DjidelAbdelali/pfe/memoire_docs/Presentation_PFE_USTHB.pdf

Encadrants :

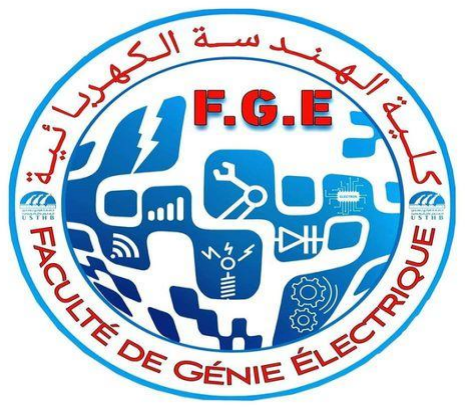
[picture p1: figure]

Dr. BOUDJEDIR Chems Eddin

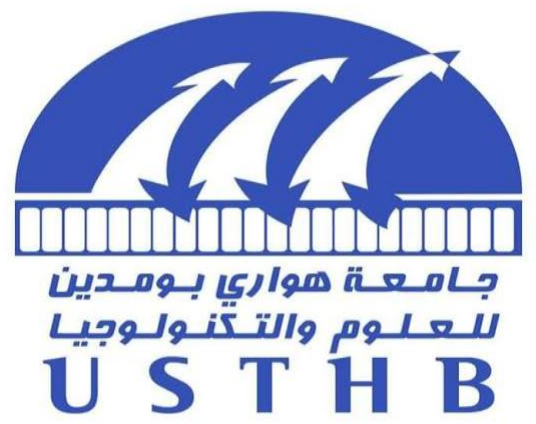
[picture p2: figure]
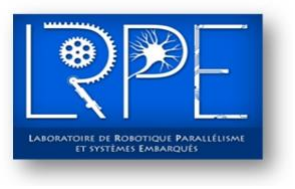
[picture p3: figure]

## Conception, réalisation et commande par mode glissant d'ordre fractionnaire d'un robot parallèle de type Delta

M. DJIDEL Abdelali Rayan & MLLE. ZETOUTOU Djedjiga Lyna

Président : Dr. LAIB Abdelbasset Examinateur : Dr. GUESSOUM Hani

Présenté le 24/06/2025

Membres du jury :

1

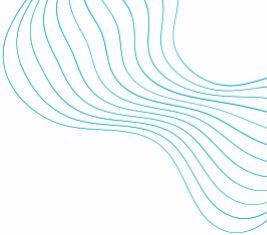
[picture p4: figure]

# Plan de travail

Introduction
Types de robots manipulateurs
Etude des commandes robustes Commande TDC et SMC-Fractionnaire

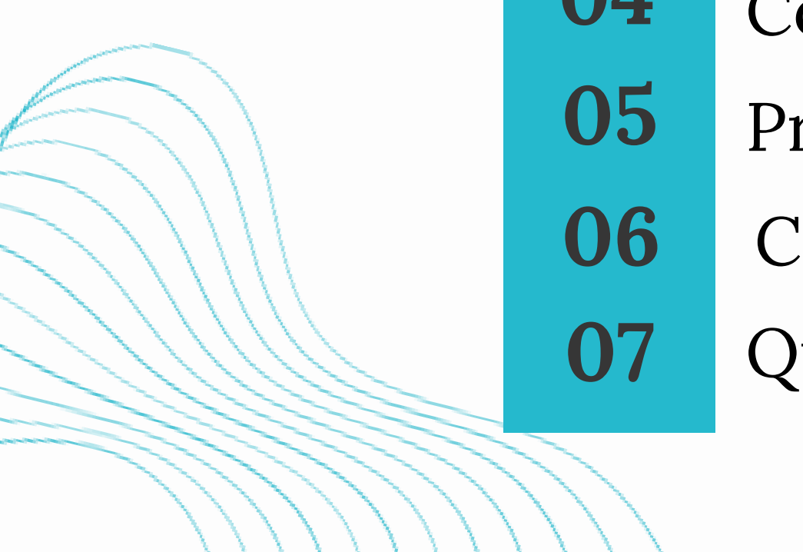
[picture p5: figure]

Présentation du robot
Conclusion et perspectives

01
02
03
04

### 07 Questions

2

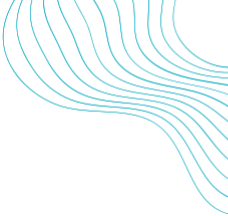
[picture p6: figure]

Context

Avec l’essor technologique et les exigences croissantes du secteur industriel, les robots parallèles se sont imposés comme des éléments cruciaux de l’automatisation. Parmi eux, le robot Delta se distingue par sa grande précision et sa rapidité, en faisant un choix privilégié pour les applications à

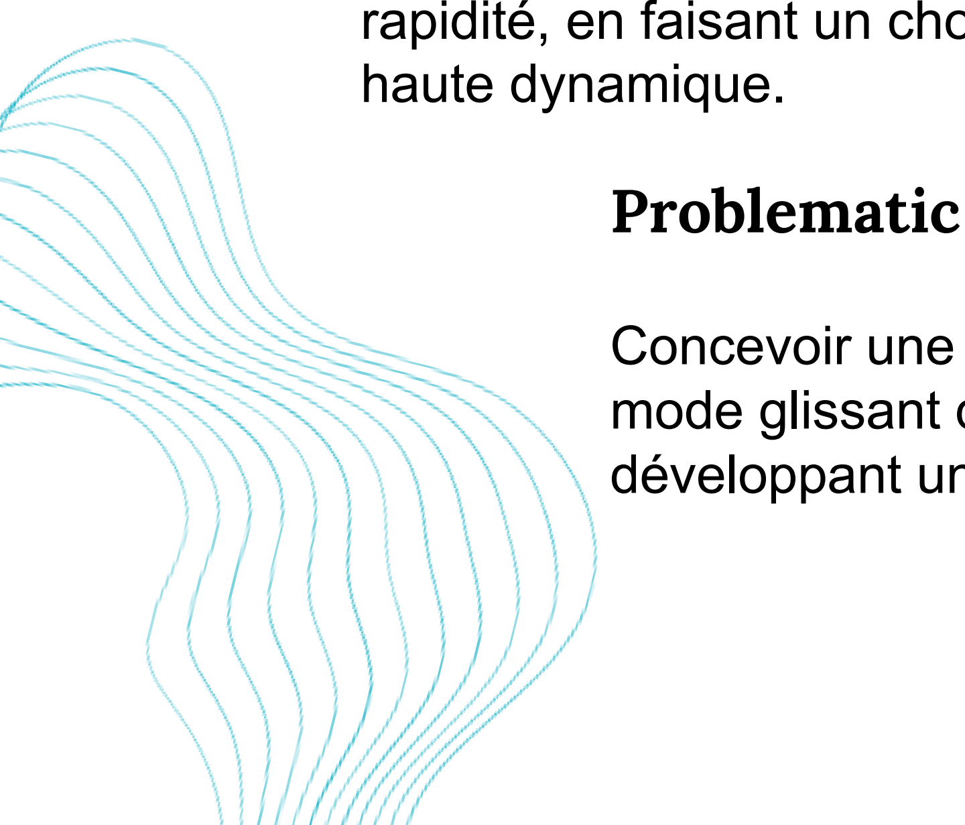
[picture p7: figure]
haute dynamique. Problematic

Concevoir une commande robuste fondée sur le mode glissant d’ordre fractionnaire tout en développant un prototype du robot Delta.

3

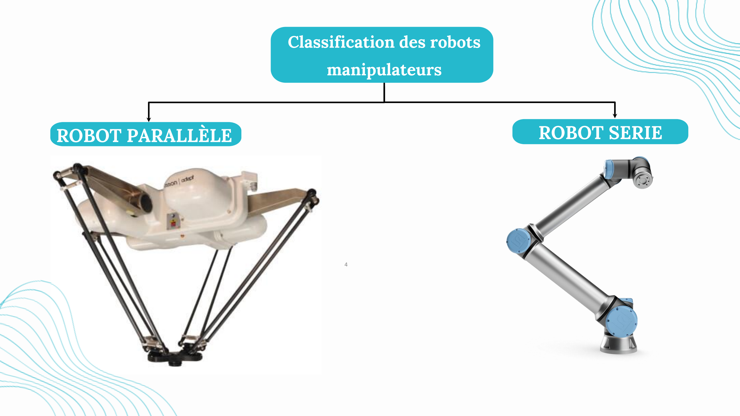
[picture p8: page 4]

Classification des robots
manipulateurs
ROBOT PARALLÈLE | ROBOT SERIE

4

## Robot Delta

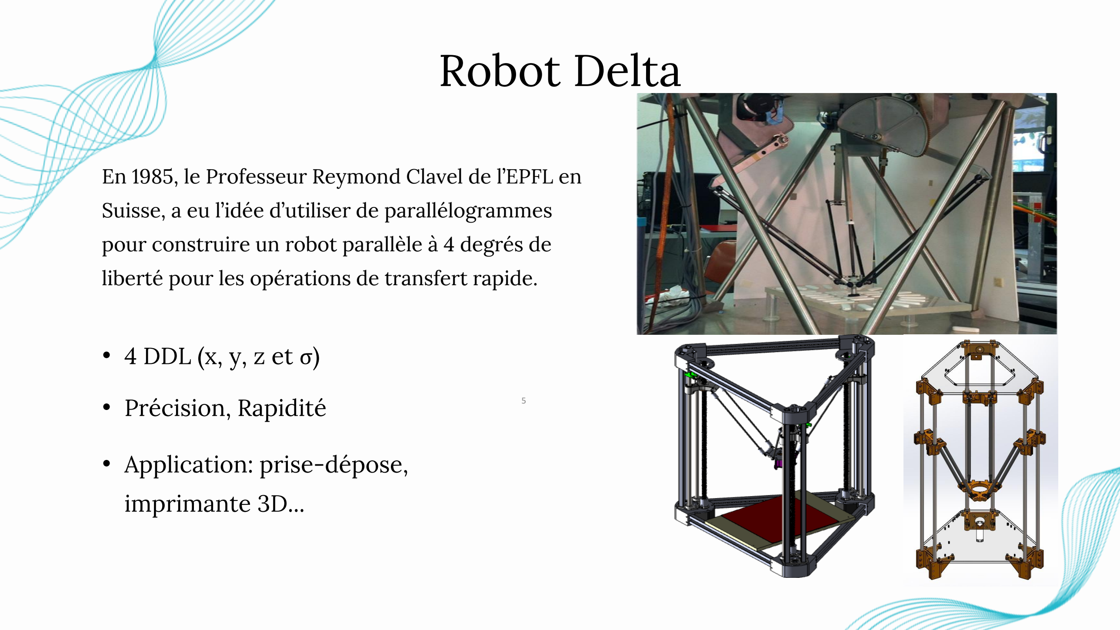
[picture p9: page 5]

En 1985, le Professeur Reymond Clavel de l’EPFL en Suisse, a eu l’idée d’utiliser de parallélogrammes pour construire un robot parallèle à 4 degrés de liberté pour les opérations de transfert rapide.

- 4 DDL (x, y, z et σ)
- Précision, Rapidité
- Application: prise-dépose, imprimante 3D...

5

## Modèle Dynamique

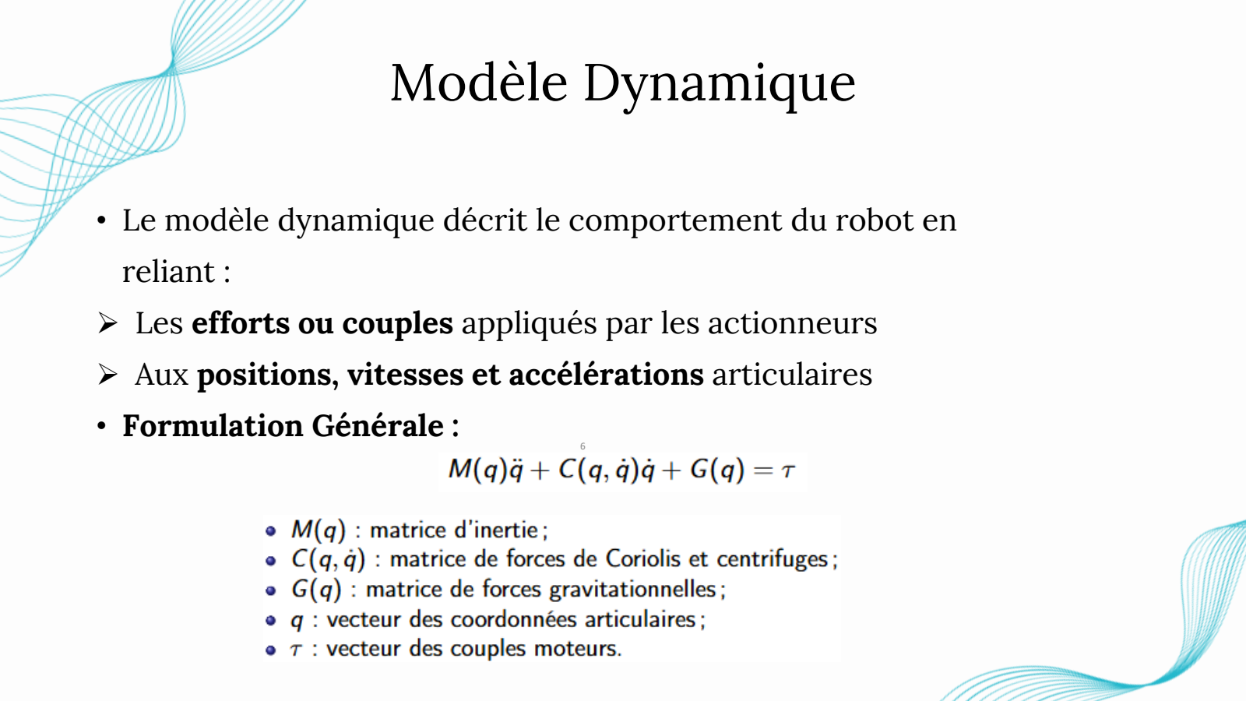
[picture p10: page 6]

- Le modèle dynamique décrit le comportement du robot en reliant :
- Les efforts ou couples appliqués par les actionneurs
- Aux positions, vitesses et accélérations articulaires
- Formulation Générale :

6

Limites des approches basées modèle

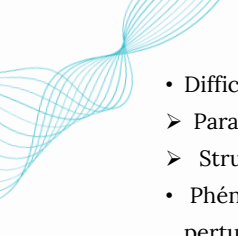
[picture p11: figure]

- Difficultés à obtenir un modèle dynamique précis :
- Paramètres incertains (masse, inertie, frottements...)
- Structure parallèle complexe (robot Delta)
- Phénomènes non modélisables (jeux mécaniques, vibrations, perturbations)
Approche alternative : les commandes sans modèle

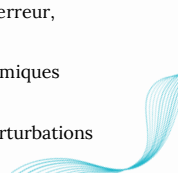
[picture p12: figure]

- Se basent uniquement sur les signaux mesurés (erreur, vitesse…)
- Réduction de la dépendance aux équations dynamiques complexes
- Meilleure robustesse face aux incertitudes et perturbations

7

## Commandes PD et PD-Fractionnaire

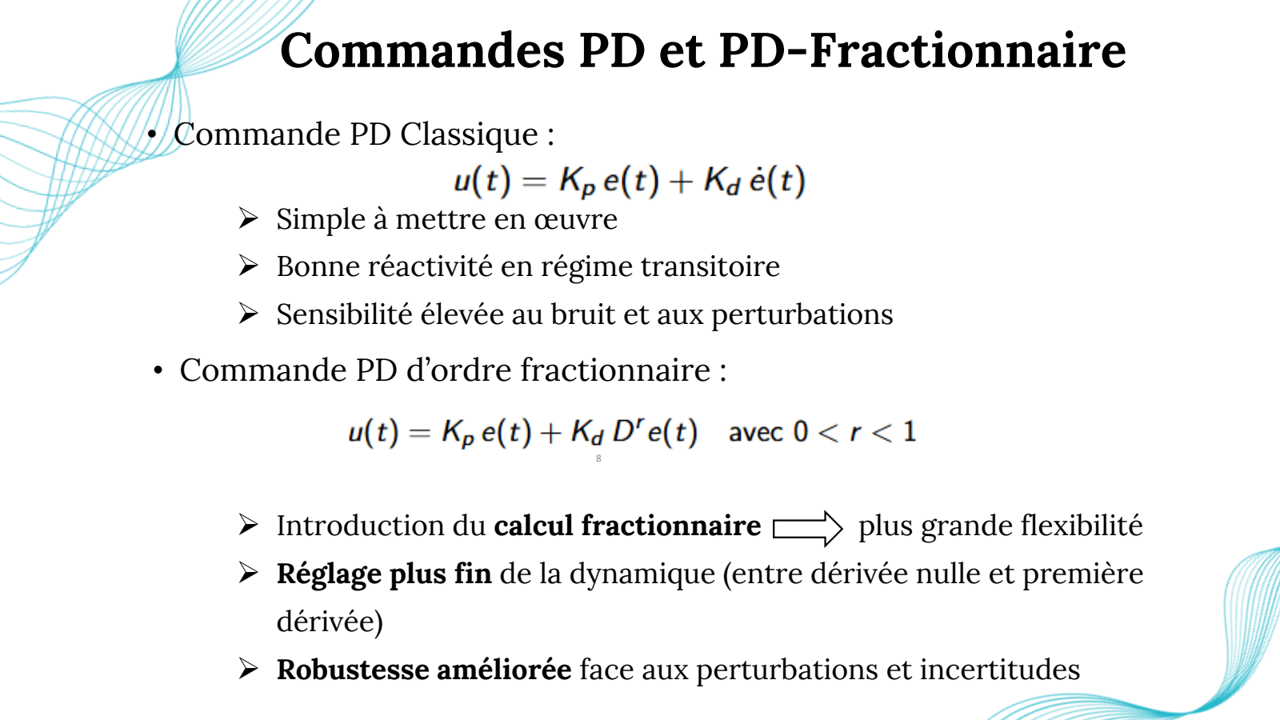
[picture p13: page 8]

- Commande PD Classique :
- Commande PD d’ordre fractionnaire :
- Simple à mettre en œuvre
- Bonne réactivité en régime transitoire
- Sensibilité élevée au bruit et aux perturbations
- Introduction du calcul fractionnaire plus grande flexibilité
- Réglage plus fin de la dynamique (entre dérivée nulle et première dérivée)
- Robustesse améliorée face aux perturbations et incertitudes

8

## Opérateur d'ordre fractionnaire

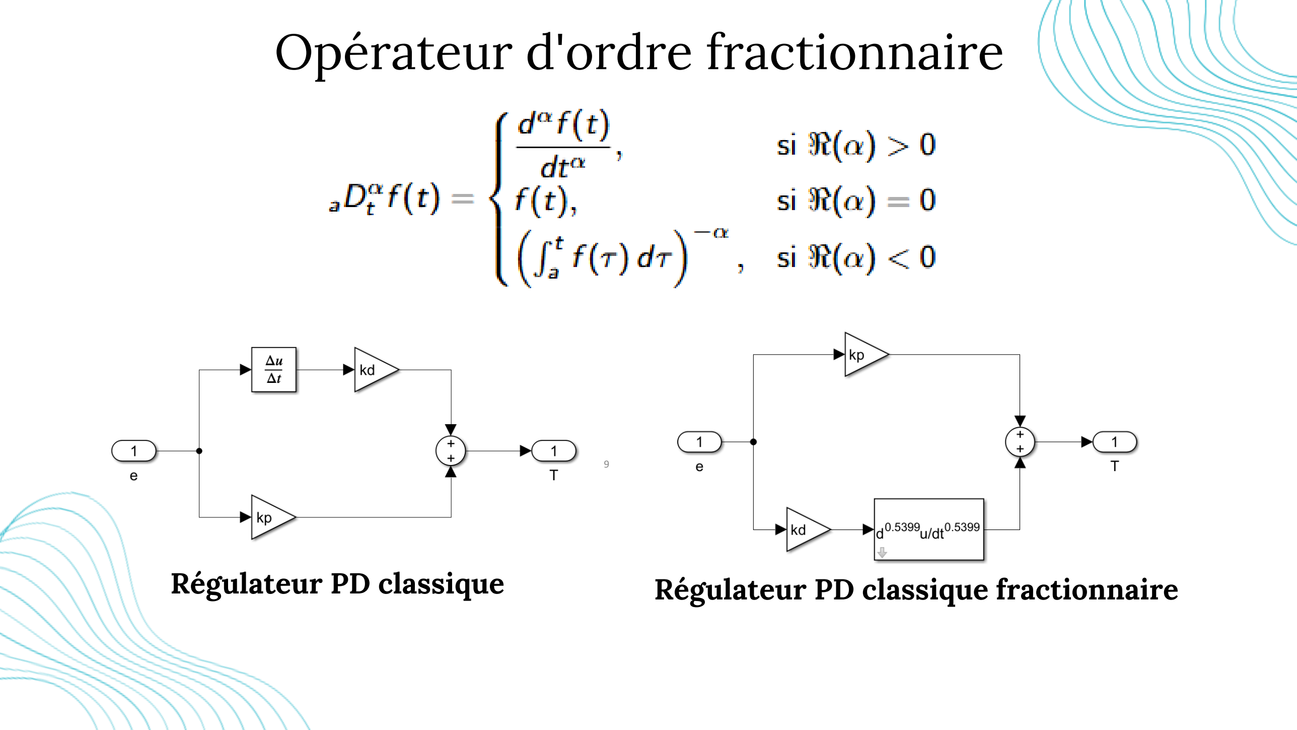
[picture p14: page 9]

Régulateur PD classique | Régulateur PD classique fractionnaire

9

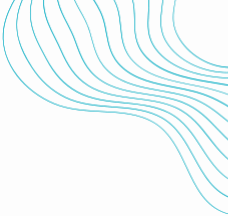
[picture p15: figure]

Formulation de la trajectoire choisie

## Génération de trajectoire

- Type de trajectoire : forme demi-ellipse dans le plan xz.
- Expression paramétrique :

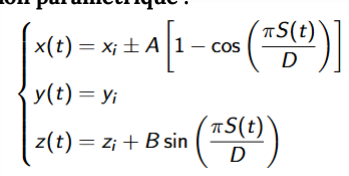
[picture p16: figure]

- Où :

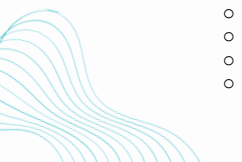
[picture p17: figure]

- S(t) : distance parcourue entre les deux points
- D : distance totale
- A, B : amplitudes sur x et z
- (xi , yi , zi ) : point de départ

10

## Génération de trajectoire

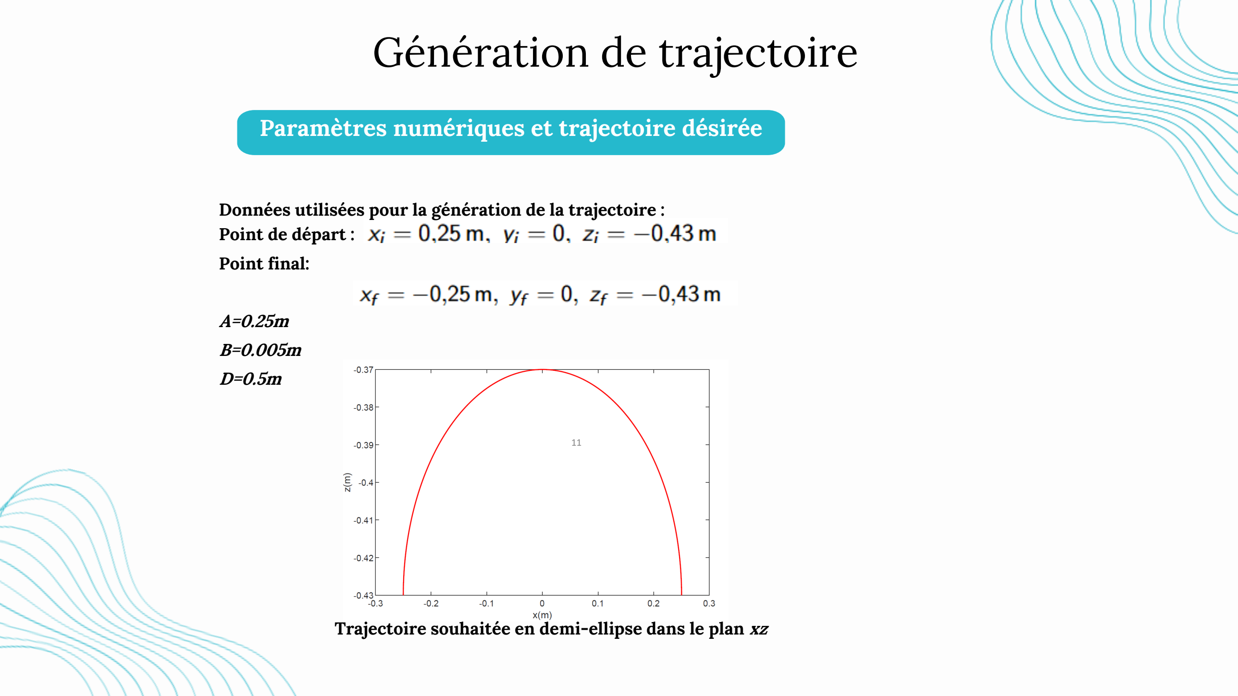
[picture p18: page 11]

Paramètres numériques et trajectoire désirée

Données utilisées pour la génération de la trajectoire : Point de départ :

Trajectoire souhaitée en demi-ellipse dans le plan xz

Point final:

A=0.25m
B=0.005m
D=0.5m

11

## Poursuite de trajectoire – 0.5s

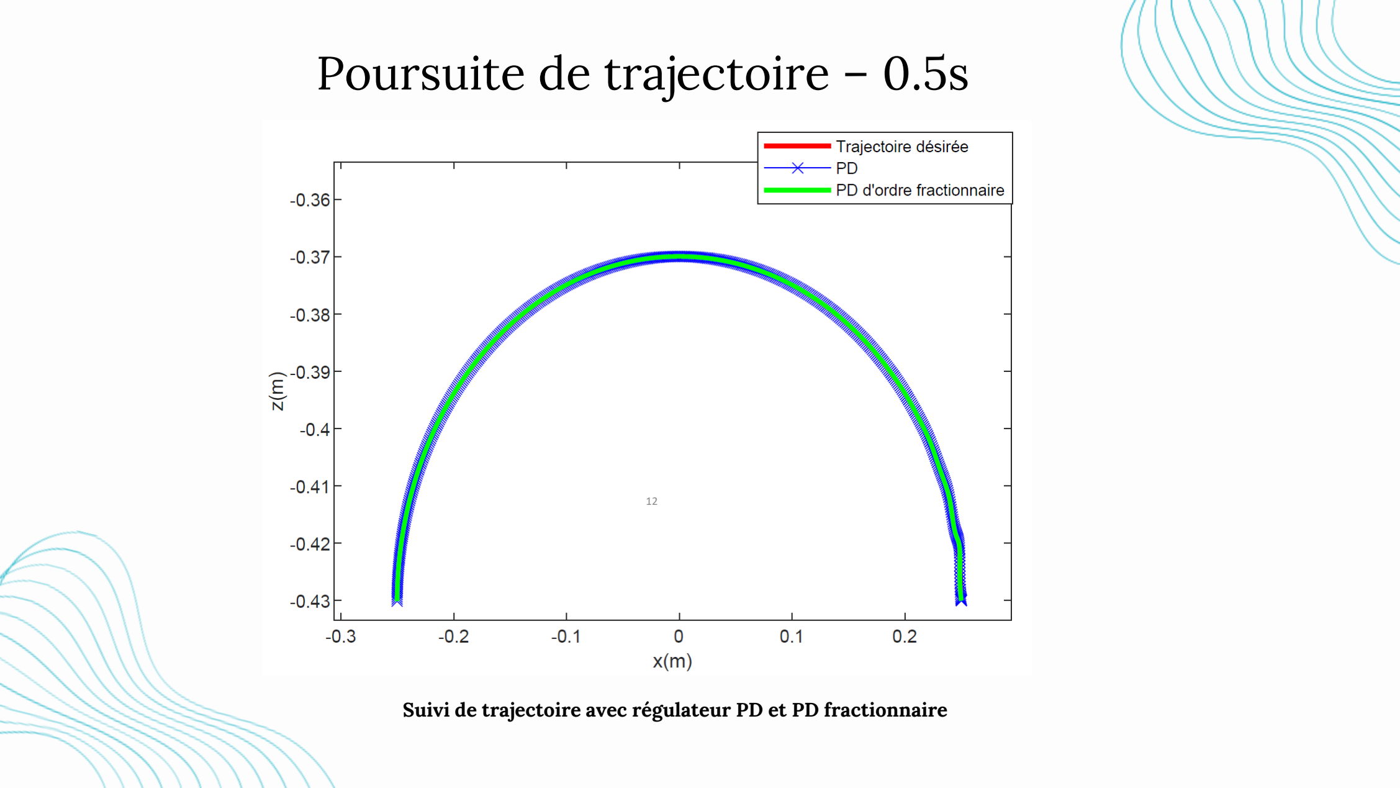
[picture p19: page 12]

Suivi de trajectoire avec régulateur PD et PD fractionnaire

12

## Erreurs et couples – 0.5s

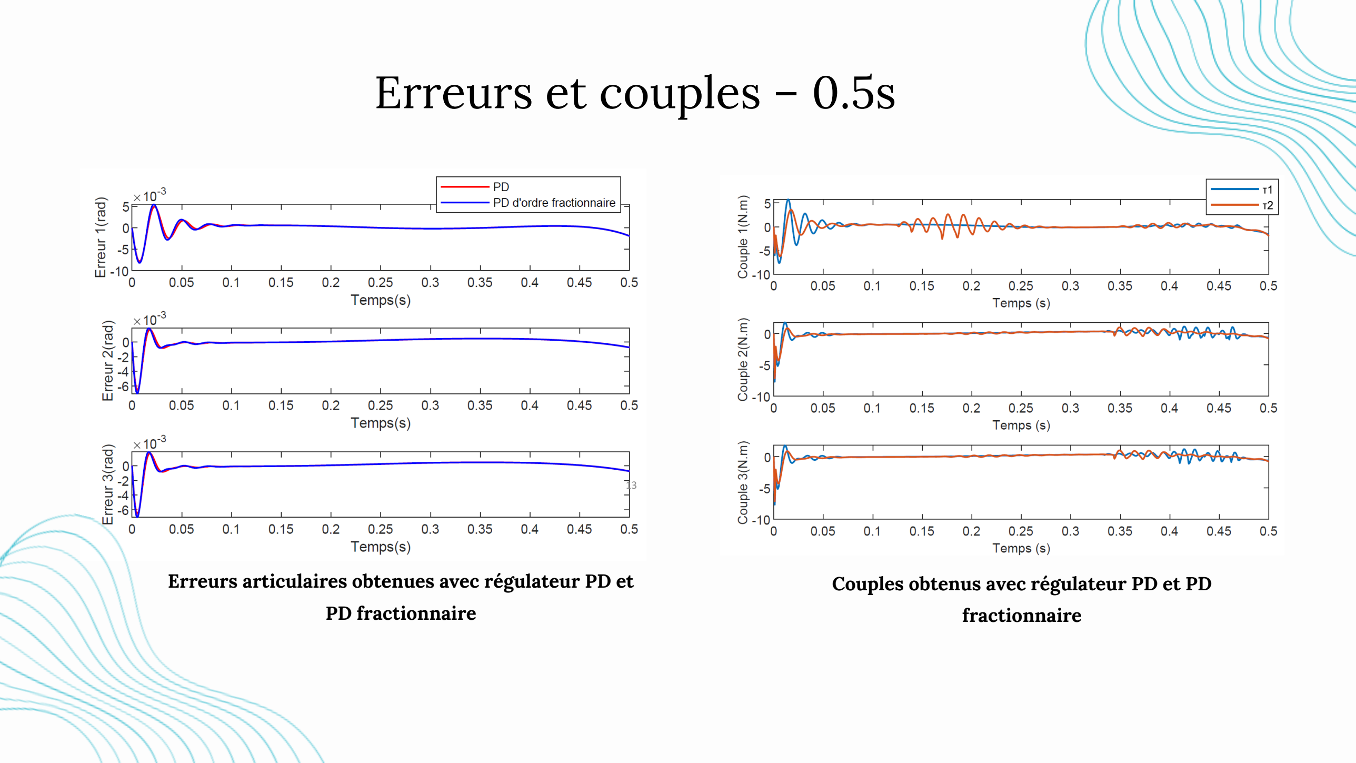
[picture p20: page 13]

Erreurs articulaires obtenues avec régulateur PD et PD fractionnaire

Couples obtenus avec régulateur PD et PD fractionnaire

13

## Poursuite de trajectoire – 0.2s

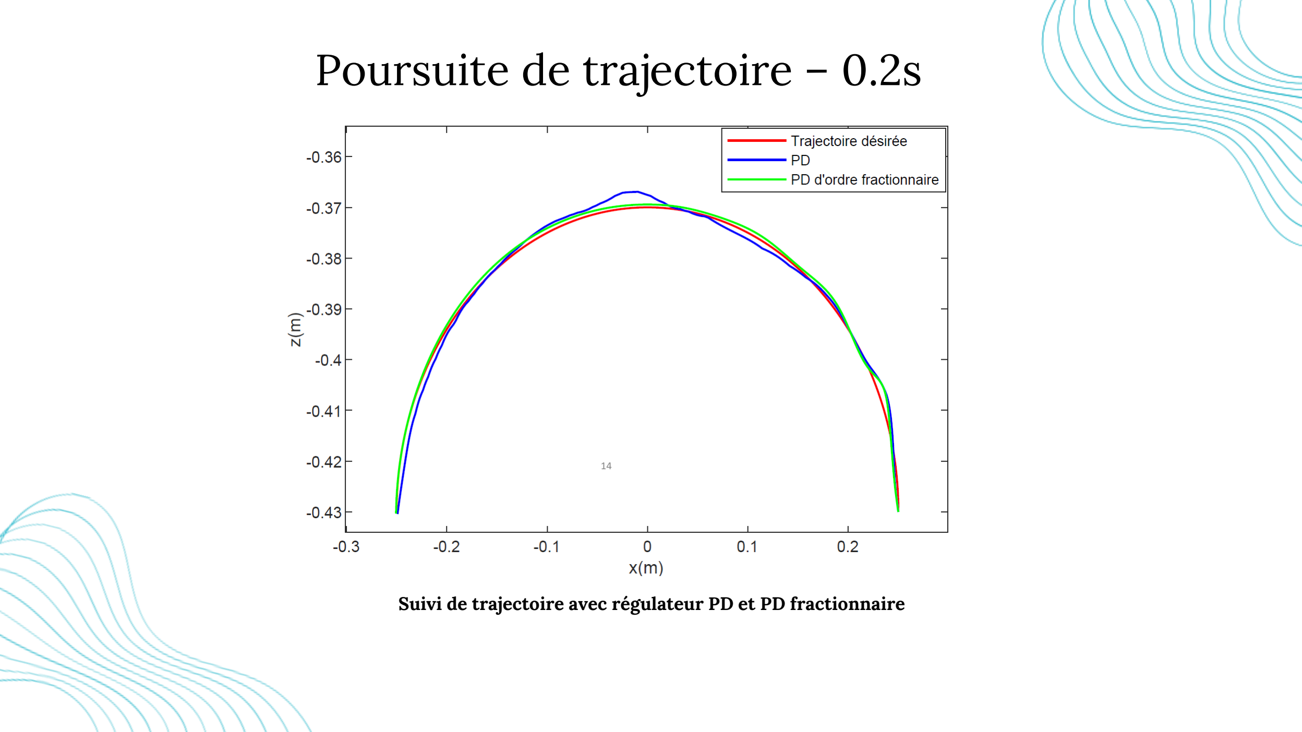
[picture p21: page 14]

Suivi de trajectoire avec régulateur PD et PD fractionnaire

14

## Erreurs et couples – 0.2s

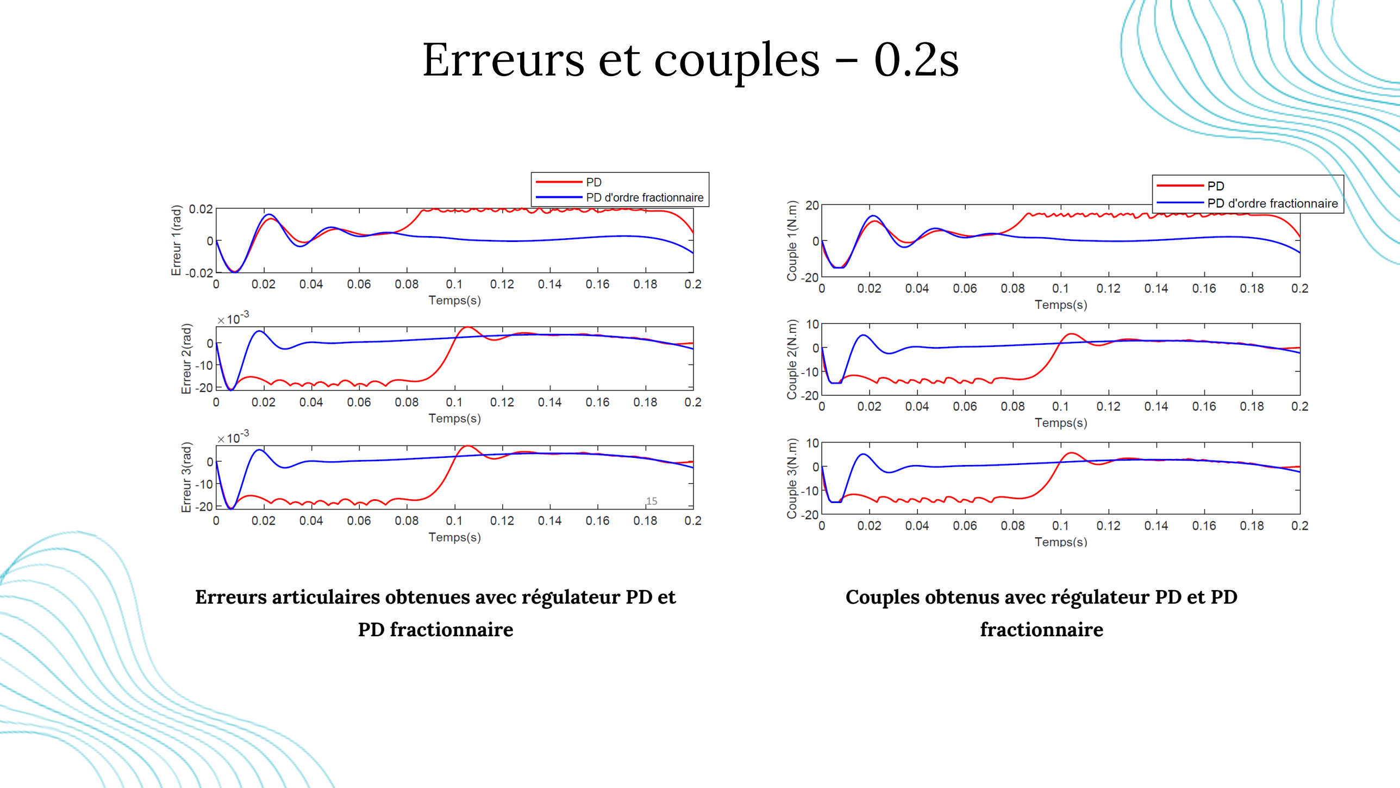
[picture p22: page 15]

Erreurs articulaires obtenues avec régulateur PD et PD fractionnaire

Couples obtenus avec régulateur PD et PD fractionnaire

15

## Commande a retard temporelle (TDC)

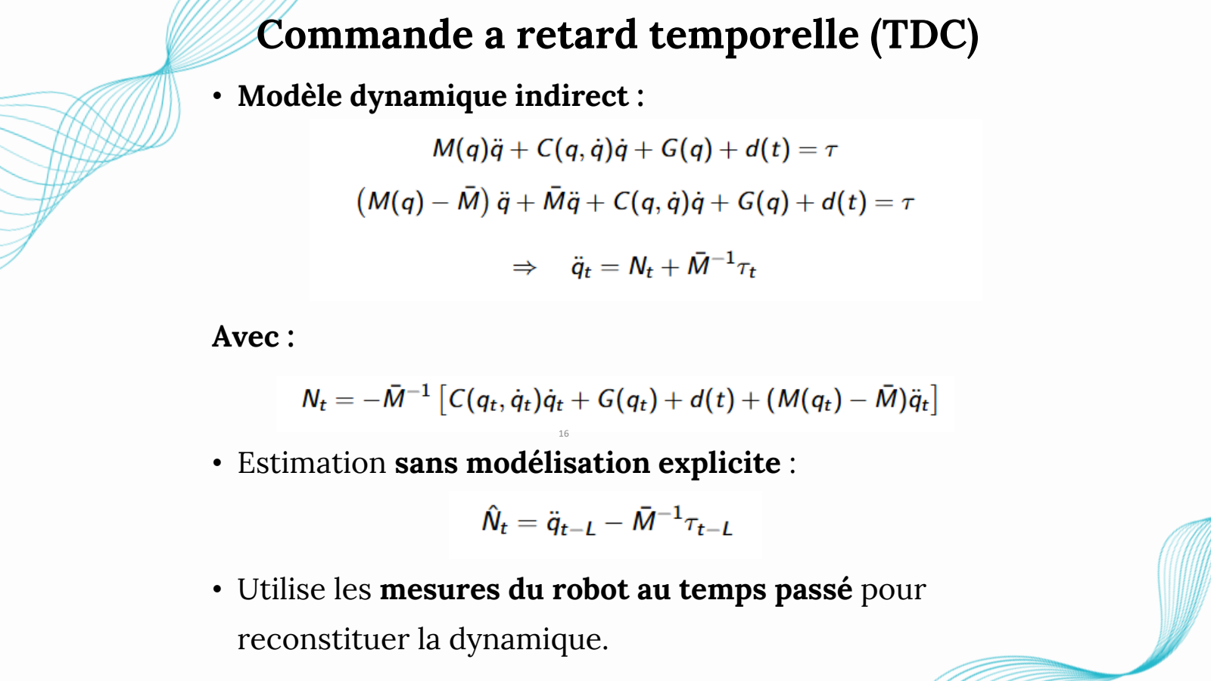
[picture p23: page 16]

- Modèle dynamique indirect :

Avec :

- Estimation sans modélisation explicite :
- Utilise les mesures du robot au temps passé pour reconstituer la dynamique.

16

## Commande par mode glissant (SMC)

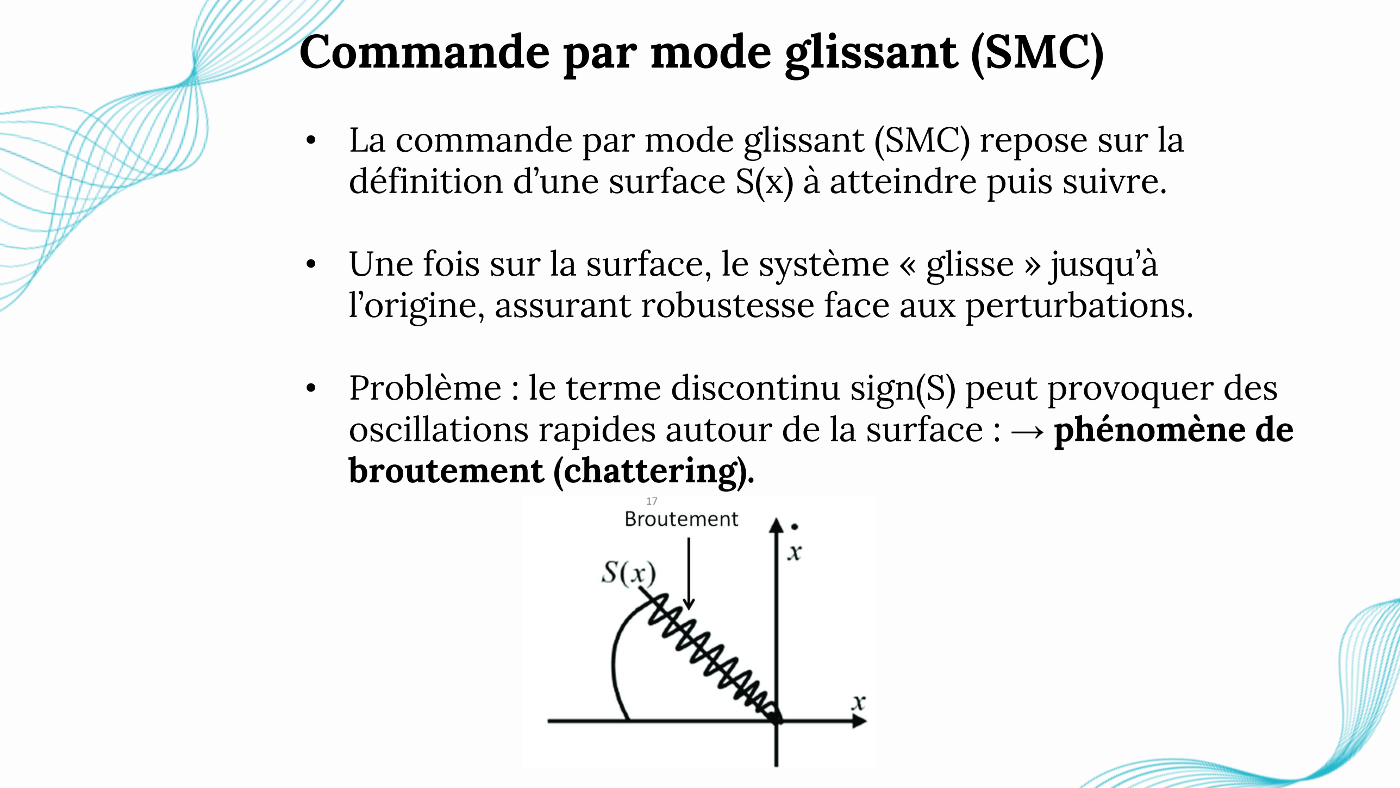
[picture p24: page 17]

- La commande par mode glissant (SMC) repose sur la définition d’une surface S(x) à atteindre puis suivre.
- Une fois sur la surface, le système « glisse » jusqu’à l’origine, assurant robustesse face aux perturbations.
- Problème : le terme discontinu sign(S) peut provoquer des oscillations rapides autour de la surface : → phénomène de broutement (chattering).

17

## Commande par mode glissant fractionnaire (SMC-F)

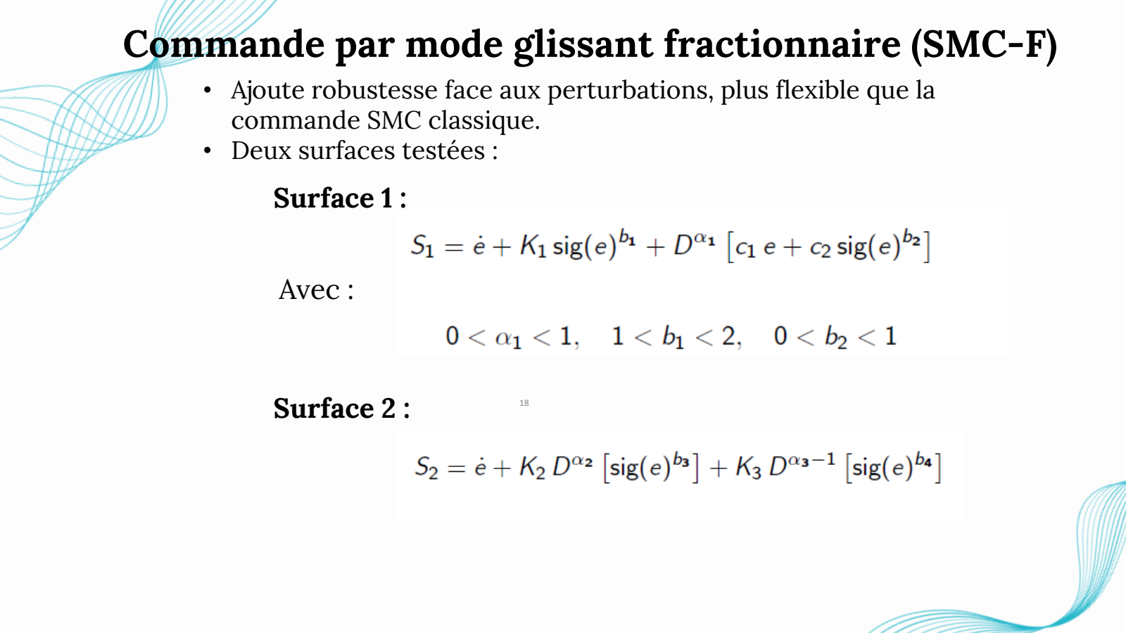
[picture p25: page 18]

Surface 1 :

- Ajoute robustesse face aux perturbations, plus flexible que la commande SMC classique.
- Deux surfaces testées :

Surface 2 :

Avec :

18

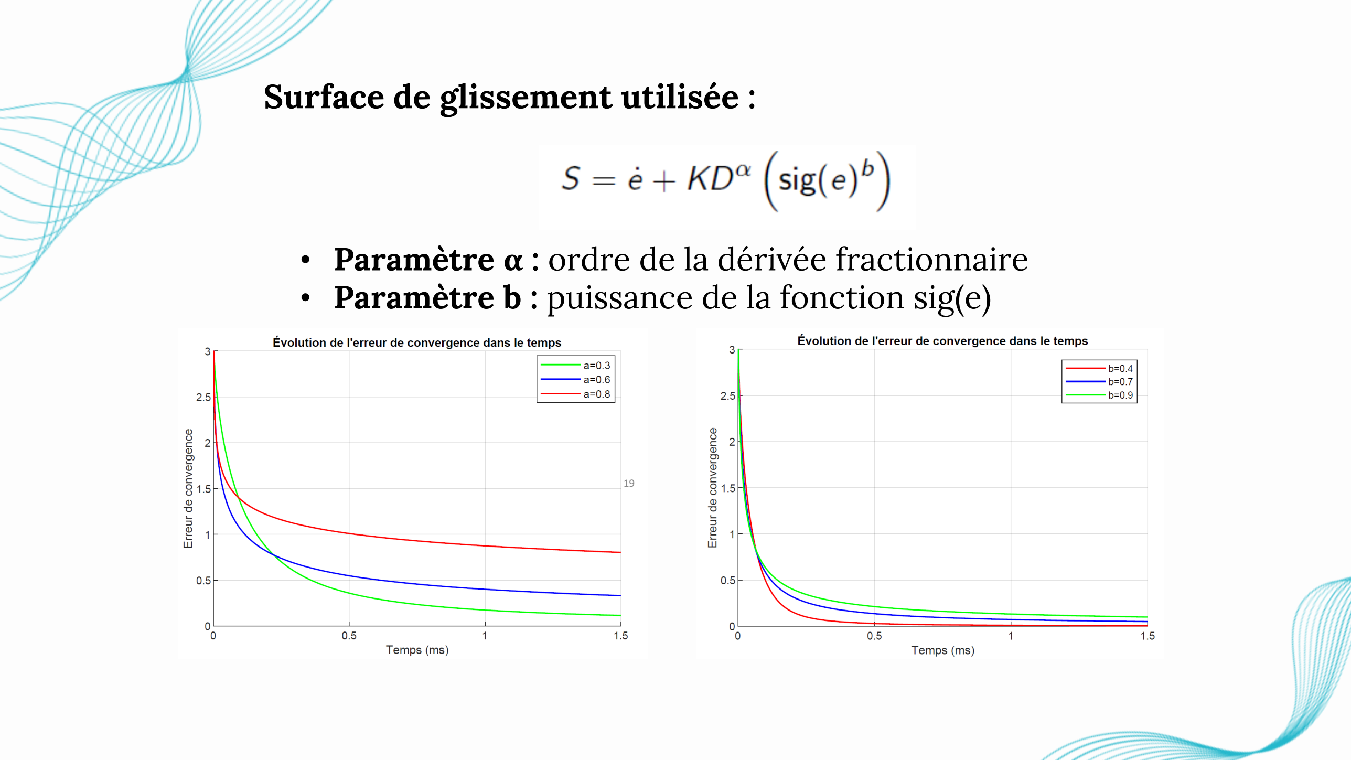
[picture p26: page 19]

Surface de glissement utilisée :

- Paramètre α : ordre de la dérivée fractionnaire
- Paramètre b : puissance de la fonction sig(e)

19

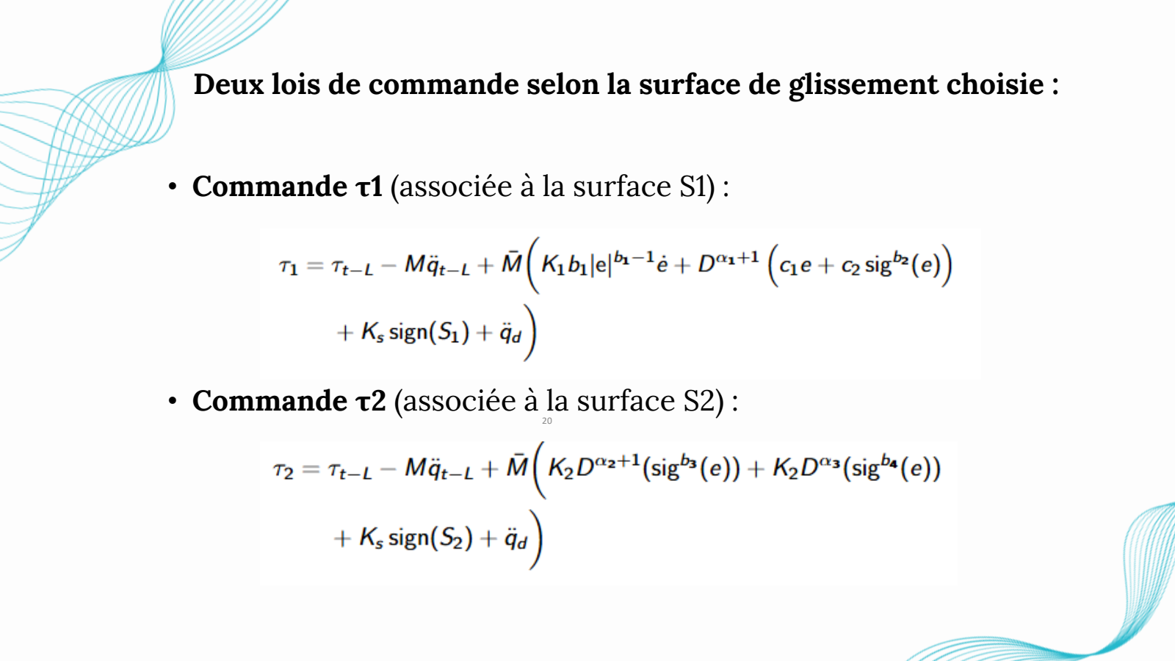
[picture p27: page 20]

Deux lois de commande selon la surface de glissement choisie :

- Commande τ1 (associée à la surface S1) :
- Commande τ2 (associée à la surface S2) :

20

## Poursuite de trajectoire – 0.5s (SMC-F)

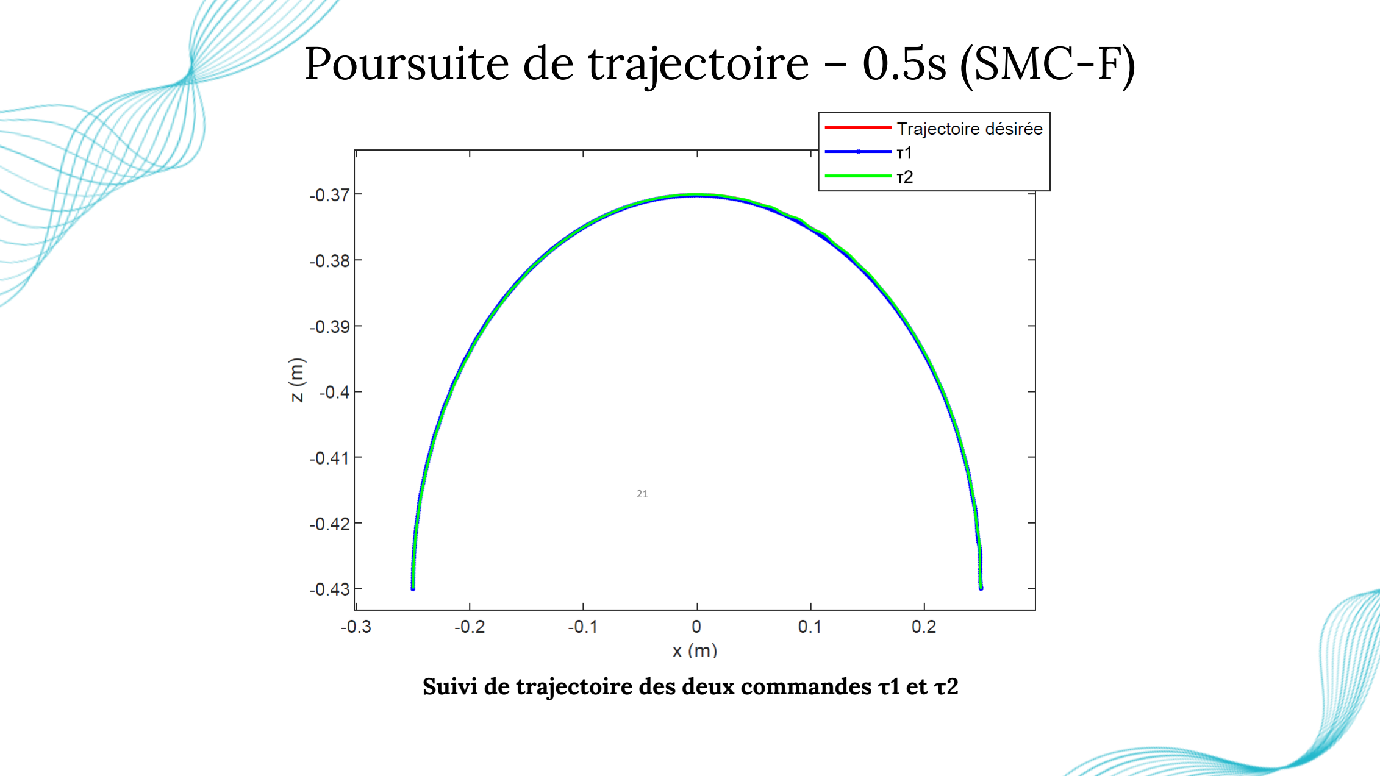
[picture p28: page 21]

Suivi de trajectoire des deux commandes τ1 et τ2

21

## Erreurs et couples – 0.5s

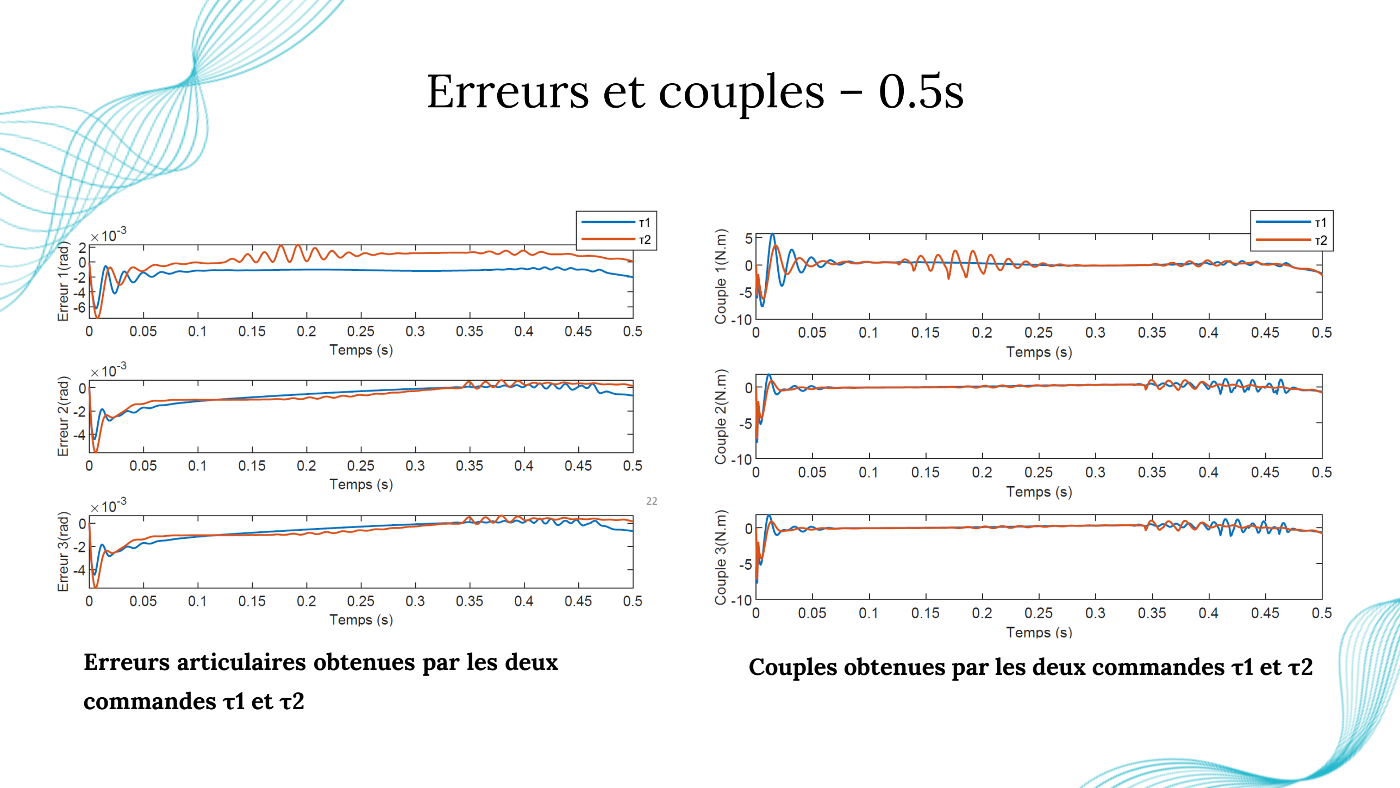
[picture p29: page 22]

Erreurs articulaires obtenues par les deux | Couples obtenues par les deux commandes τ1 et τ2
commandes τ1 et τ2

22

## Poursuite de trajectoire – 0.2s (SMC-F)

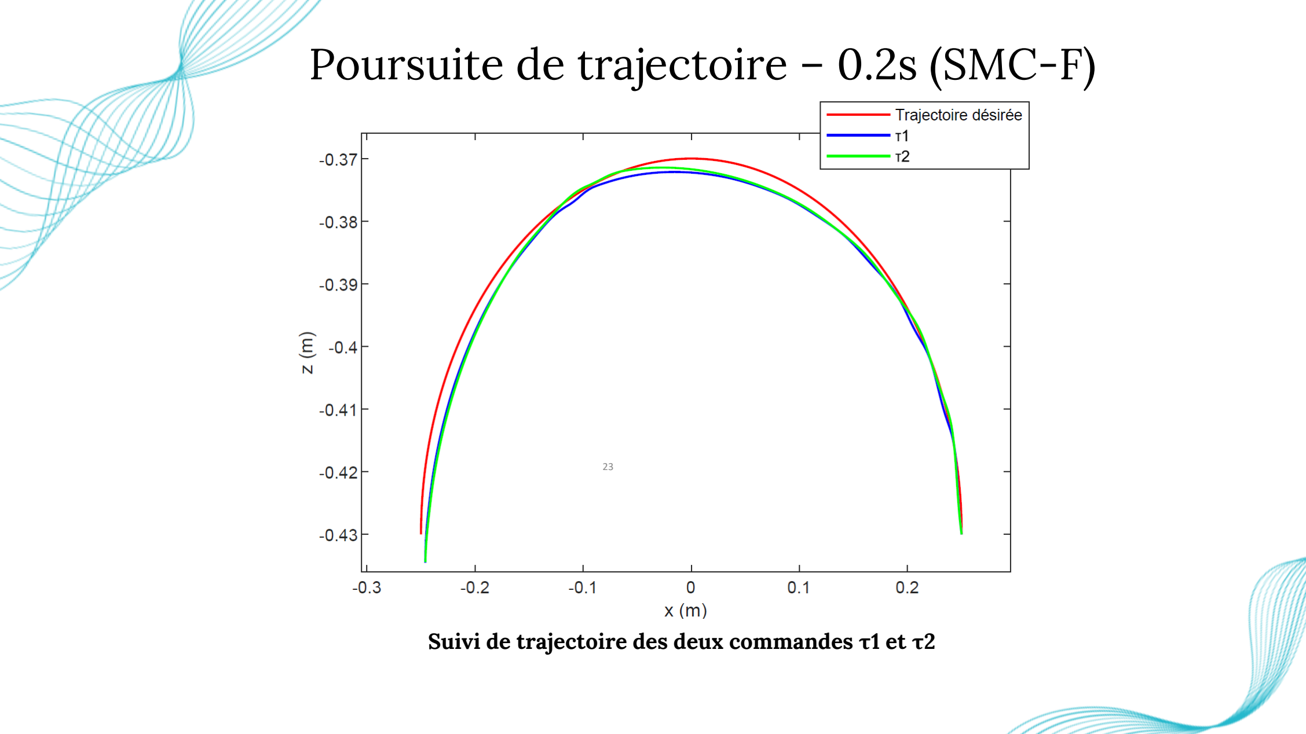
[picture p30: page 23]

Suivi de trajectoire des deux commandes τ1 et τ2

23

## Erreurs et couples – 0.2s

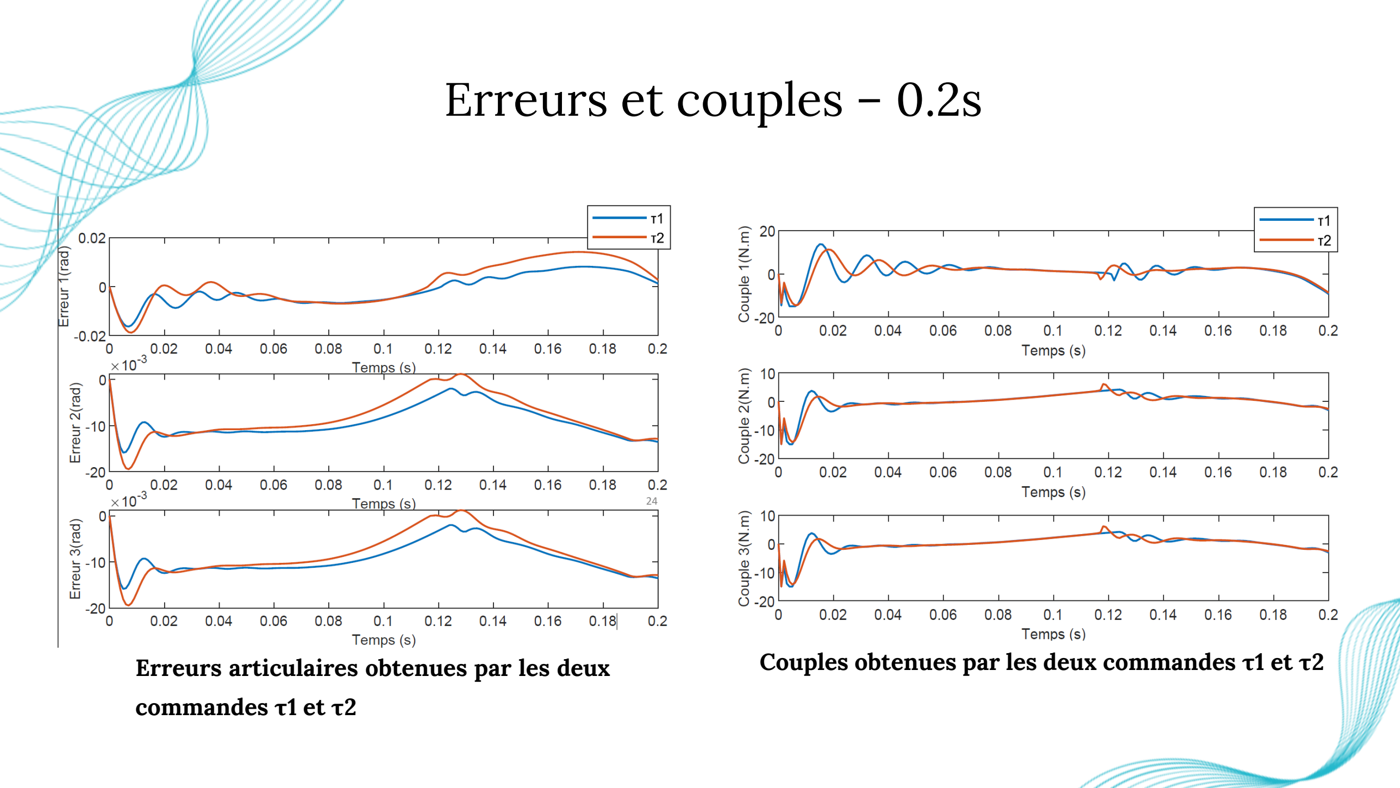
[picture p31: page 24]

Erreurs articulaires obtenues par les deux | Couples obtenues par les deux commandes τ1 et τ2
commandes τ1 et τ2

24

## Comparaison RMS des erreurs articulaires

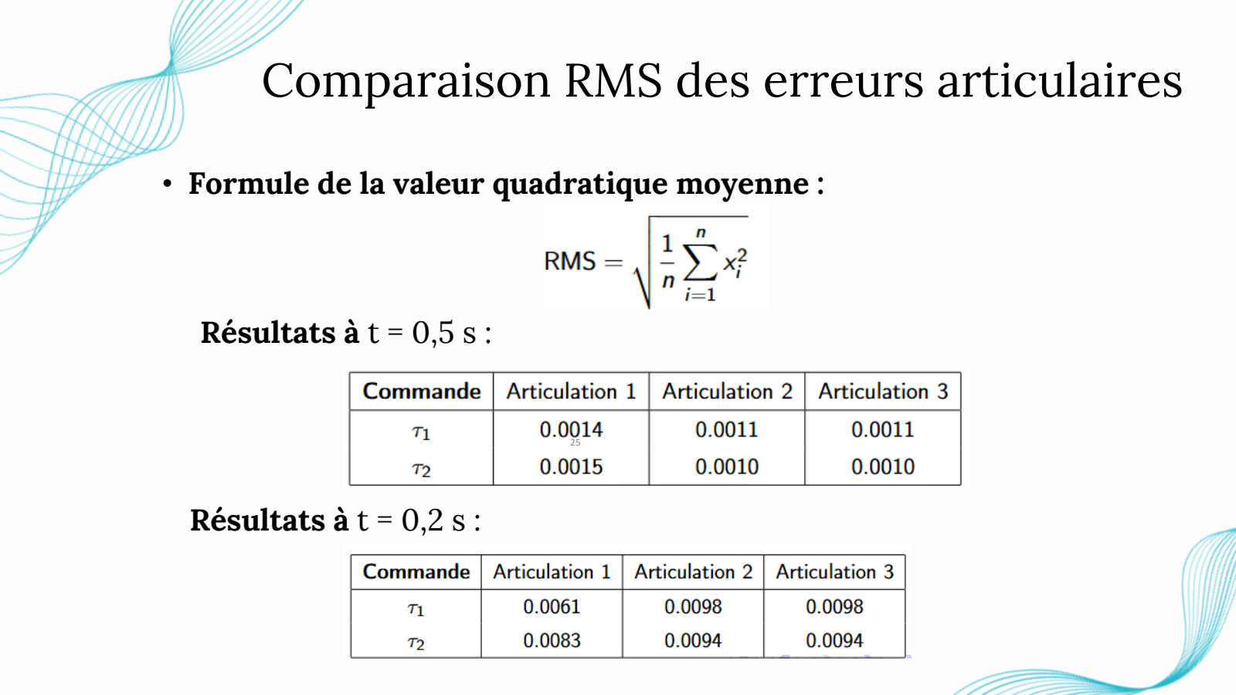
[picture p32: page 25]

- Formule de la valeur quadratique moyenne :

Résultats à t = 0,5 s :

Résultats à t = 0,2 s :

25

- La commande τ1, associée à la surface de glissement S1 donne de meilleurs résultats que τ2
- Une meilleure précision de suivi des trajectoires articulaires
- Une vitesse de convergence plus importante

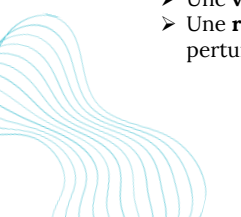
[picture p33: figure]

- Une robustesse accrue face aux incertitudes et perturbations 26

## Présentation du robot Delta

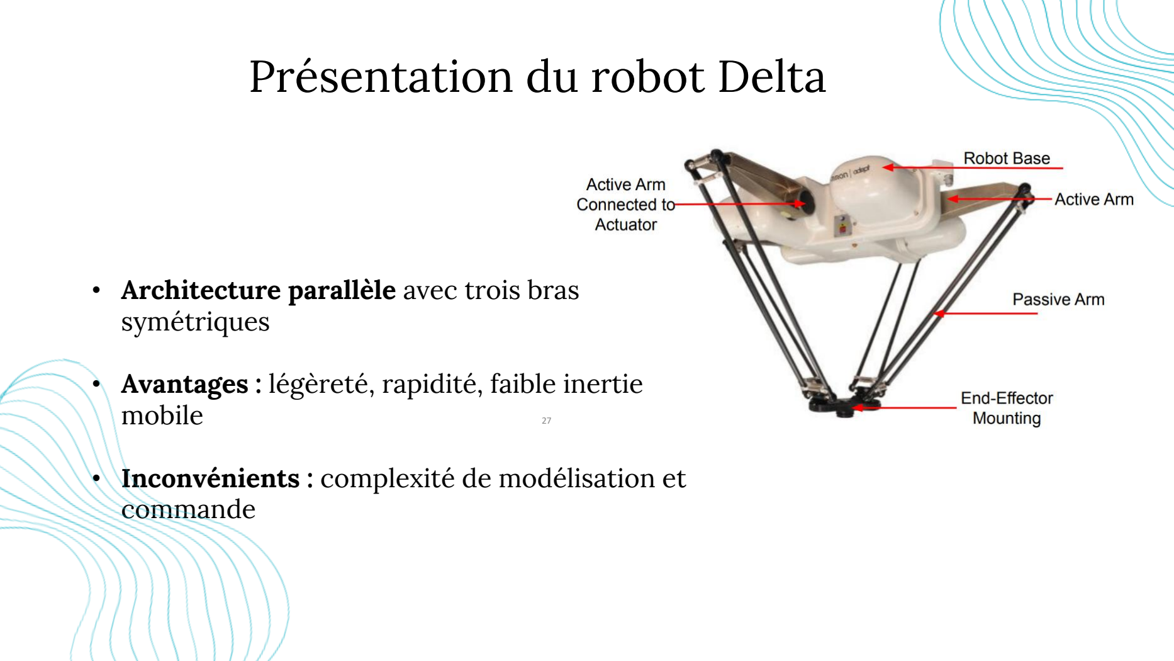
[picture p34: page 27]

- Architecture parallèle avec trois bras symétriques
- Avantages : légèreté, rapidité, faible inertie mobile
- Inconvénients : complexité de modélisation et commande

27

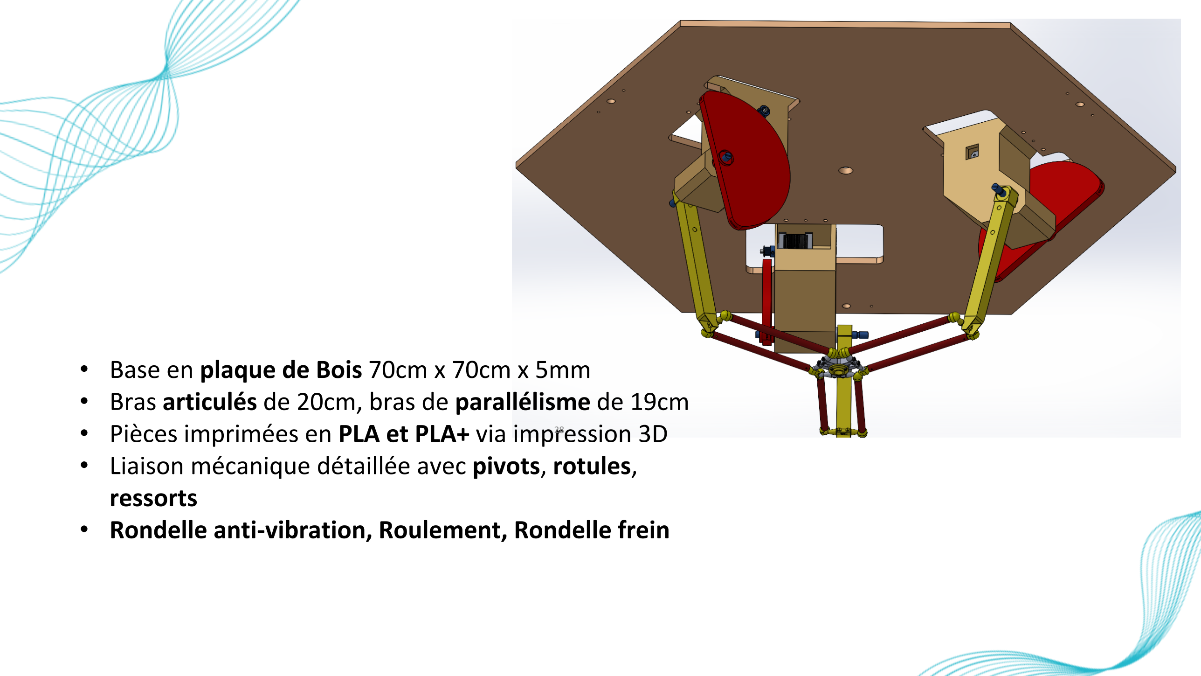
[picture p35: page 28]

- Base en plaque de Bois 70cm x 70cm x 5mm
- Bras articulés de 20cm, bras de parallélisme de 19cm
- Pièces imprimées en PLA et PLA+ via impression 3D
- Liaison mécanique détaillée avec pivots, rotules, ressorts
- Rondelle anti-vibration, Roulement, Rondelle frein

28

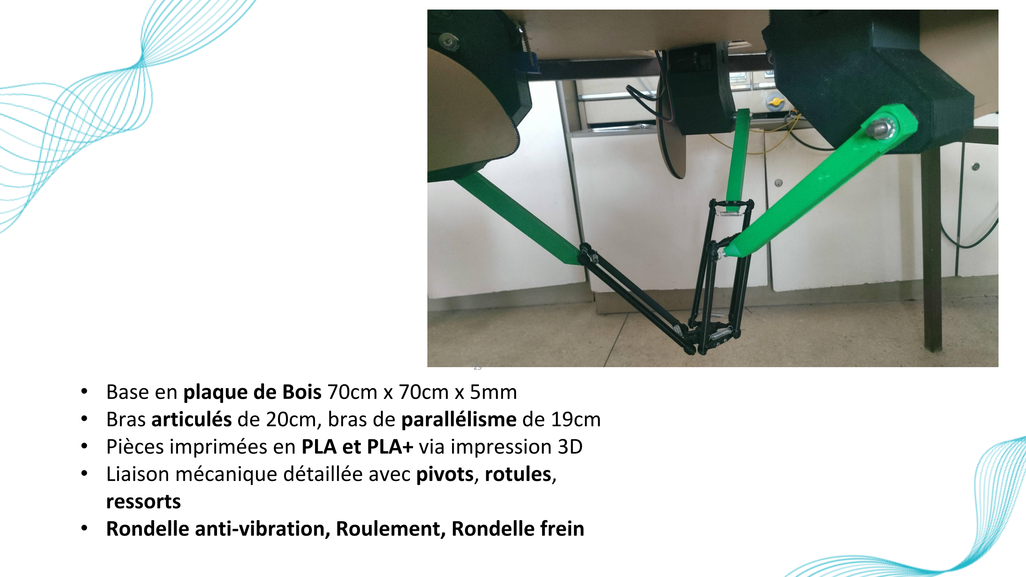
[picture p36: page 29]

- Base en plaque de Bois 70cm x 70cm x 5mm
- Bras articulés de 20cm, bras de parallélisme de 19cm
- Pièces imprimées en PLA et PLA+ via impression 3D
- Liaison mécanique détaillée avec pivots, rotules, ressorts
- Rondelle anti-vibration, Roulement, Rondelle frein

29

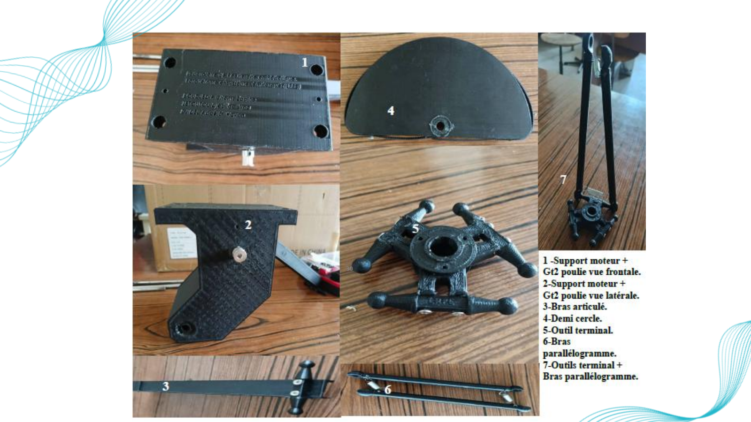
[picture p37: page 30]

30

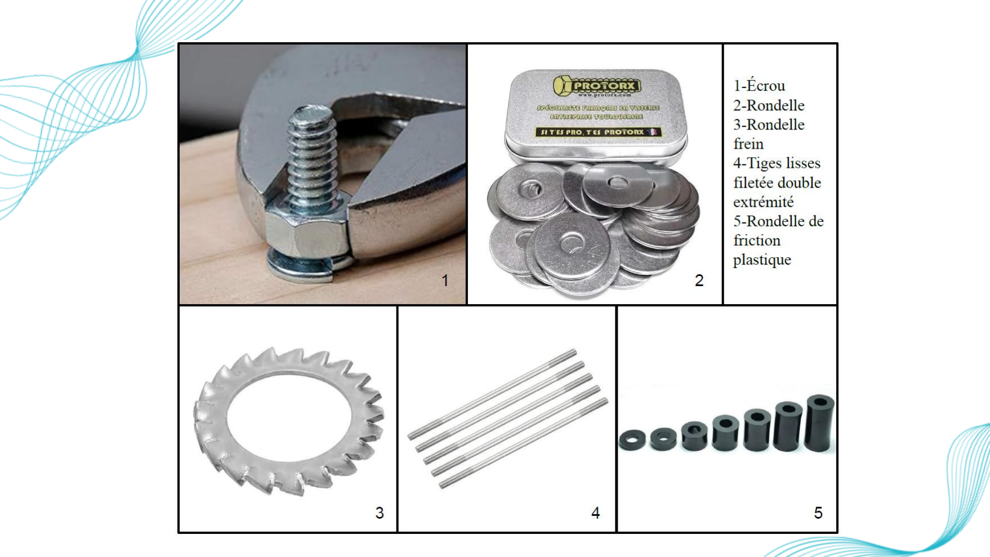
[picture p38: page 31]

31

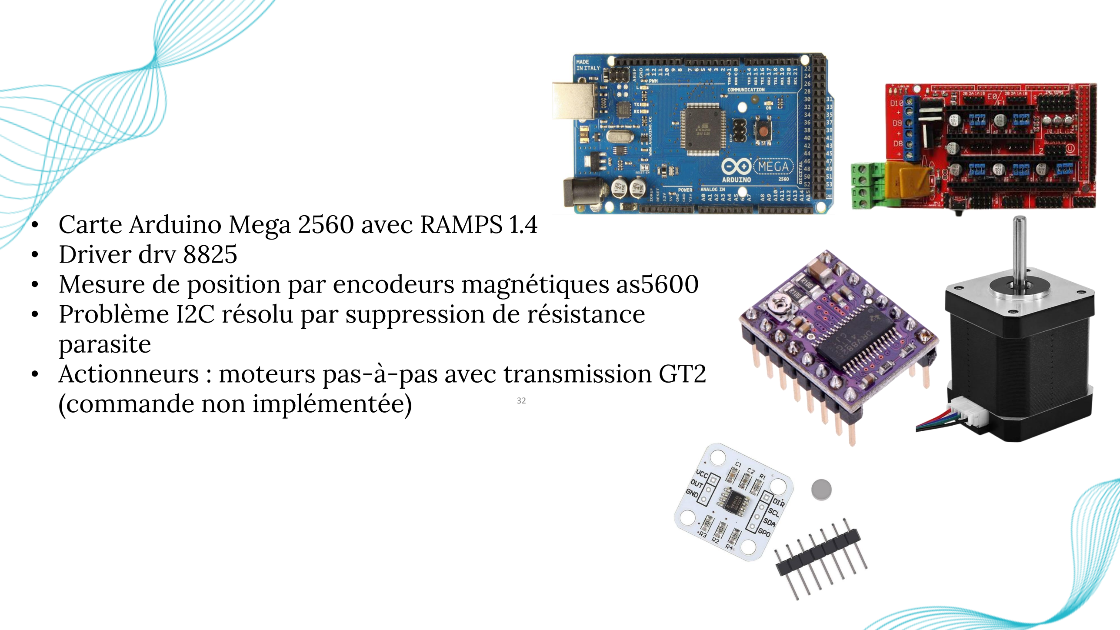
[picture p39: page 32]

- Carte Arduino Mega 2560 avec RAMPS 1.4
- Driver drv 8825
- Mesure de position par encodeurs magnétiques as5600
- Problème I2C résolu par suppression de résistance parasite
- Actionneurs : moteurs pas-à-pas avec transmission GT2 (commande non implémentée)
32

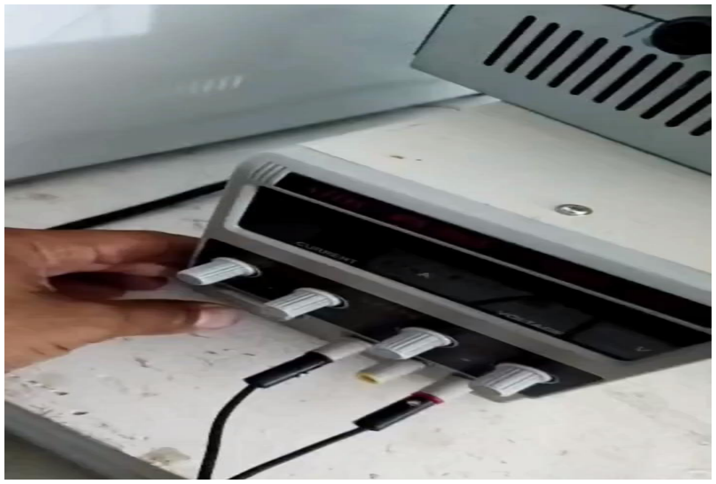
[picture p40: page 33]

33

Conclusion

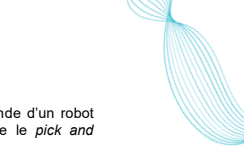
[picture p41: figure]

Ce travail présente la conception et la commande d’un robot parallèle Delta pour des tâches industrielles comme le pick and place.

Le prototype mécatronique combine impression 3D et composants standards, modélisé sous SolidWorks. L’électronique repose sur Arduino Mega, RAMPS 1.4, DRV8825, capteurs AS5600 et moteurs Nema 17.

Côté commande, trois stratégies ont été étudiées : PD classique, PD fractionnaire et TDC–SMC fractionnaire. Les simulations MATLAB montrent que le calcul fractionnaire améliore la souplesse et les performances. Une plateforme expérimentale a été mise en place pour les futurs travaux académiques.

34

Perspectives

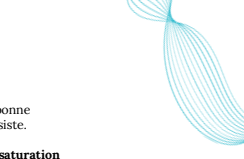
[picture p42: figure]

- Bien que la commande par mode glissant fractionnaire ait montré une bonne précision et robustesse, le phénomène de broutement (chattering) persiste.
- Pour y remédier, une amélioration consiste à remplacer la fonction de saturation sat(S) par une loi de convergence continue.
- Nous proposons la loi de convergence Double Hyperbolique comme alternative :

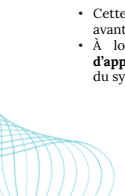
[picture p43: figure]

- Cette loi permettrait une atténuation efficace du broutement tout en conservant les avantages du mode glissant fractionnaire.
- À long terme, l’intégration d’un réseau de neurones ou d’un algorithme d’apprentissage par renforcement pourrait adapter dynamiquement la loi selon l’état du système

35

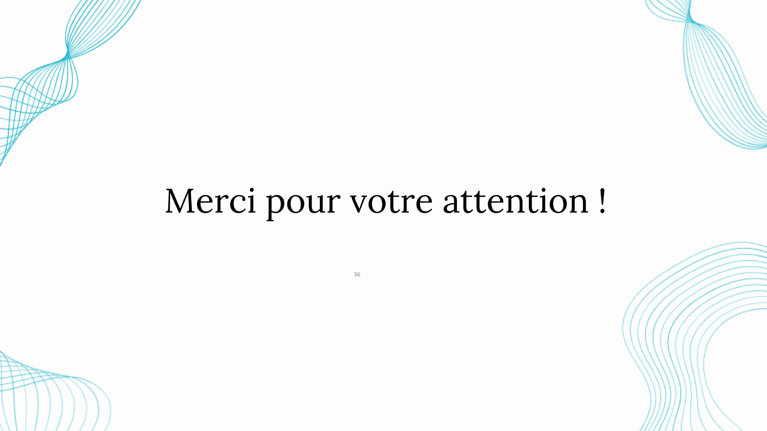
[picture p44: page 36]

# Merci pour votre attention !

36
