DjidelAbdelali/pfe/cad_3d/3D Modeling/fig3D_1_spatial_trajectory.png

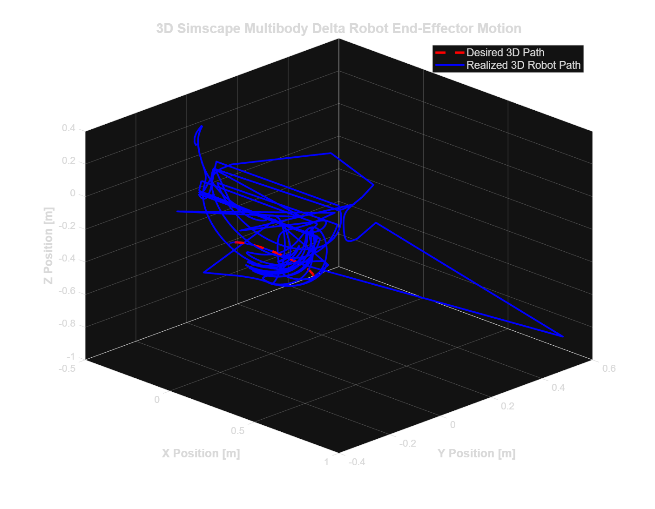
cad_3d/3D Modeling/fig3D_1_spatial_trajectory.png
