DjidelAbdelali/pfe/cad_3d/3D Modeling/fig3D_2_joint_angles.png

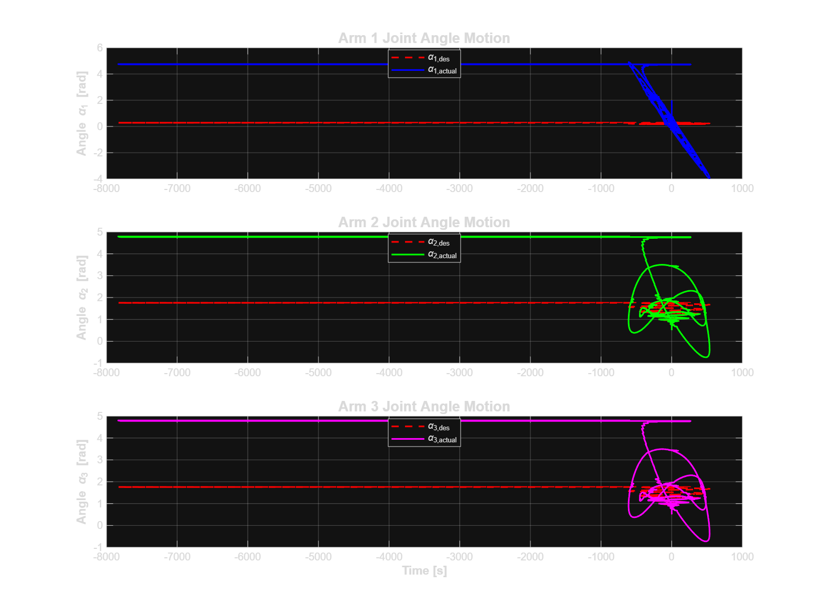
cad_3d/3D Modeling/fig3D_2_joint_angles.png
