DjidelAbdelali/pfe/cad_3d/3D Modeling/fig3D_3_position_tracking_3d.png

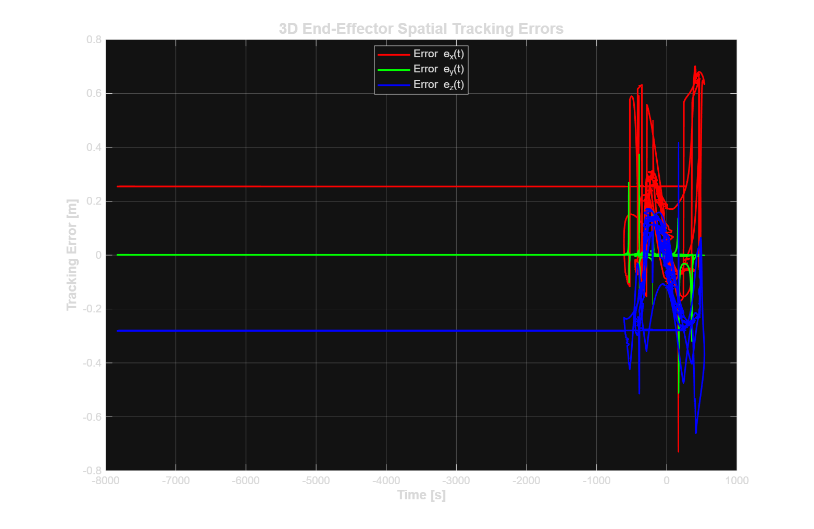
cad_3d/3D Modeling/fig3D_3_position_tracking_3d.png
