DjidelAbdelali/pfe/cad_3d/Assem12-Copy - Copy.SLDASM

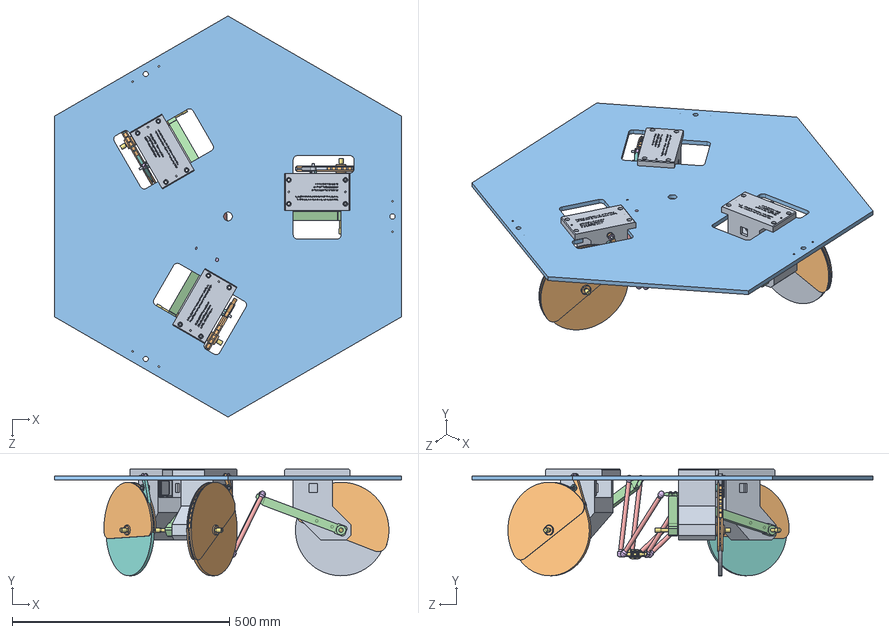
[picture p53: CAD file, 2026-09-23]
cad_3d/Assem12-Copy - Copy.SLDASM
798.5 x 245.0 x 922.0 mm
Final BlocMoteur x 3
Pièce1_Roue_ecrou modif 2 x 3
Pièce0_Plaque
Brass x 3
Pièce4_Tube x 6
Pièce4_Extremetees x 12
Nacelle1
GT2 Timing Pulley x 3
NEMA-17 x 3
608-z_01 x 6
608-z_02 x 6
608-z_03 x 6
608-z_04 x 6
Gates_2GT_20T_Smooth_Idler x 3
Pièce1_arbre x 3
Belt1-4^Assem12-Copy - Copy
Belt3-6^Assem12-Copy - Copy
Belt4-7^Assem12-Copy - Copy
