DjidelAbdelali/pfe/cad_3d/608-z.SLDASM

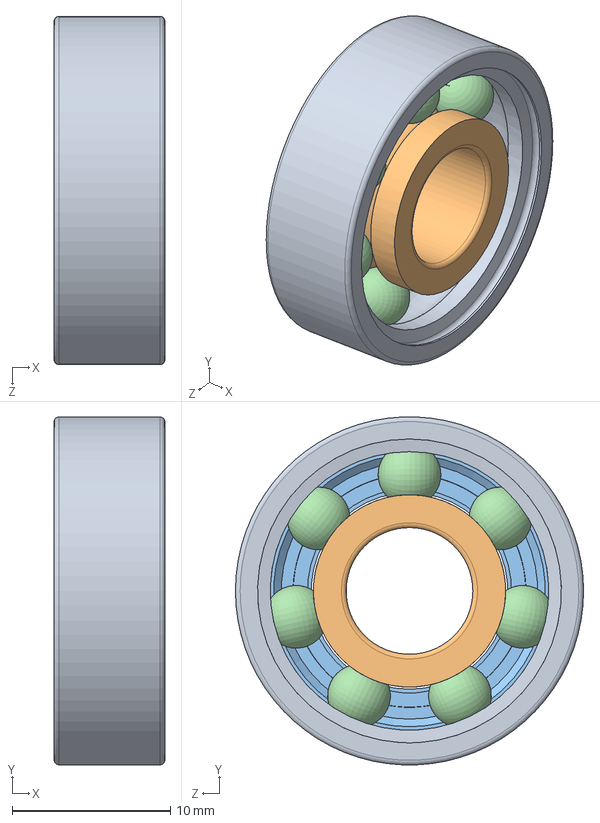
[picture p54: CAD file, 2026-09-23]
cad_3d/608-z.SLDASM
7.00 x 22.0 x 22.0 mm
608-z_01
608-z_02
608-z_03
608-z_04
