DjidelAbdelali/pfe/cad_3d/3D Modeling/Nacelle2.SLDASM

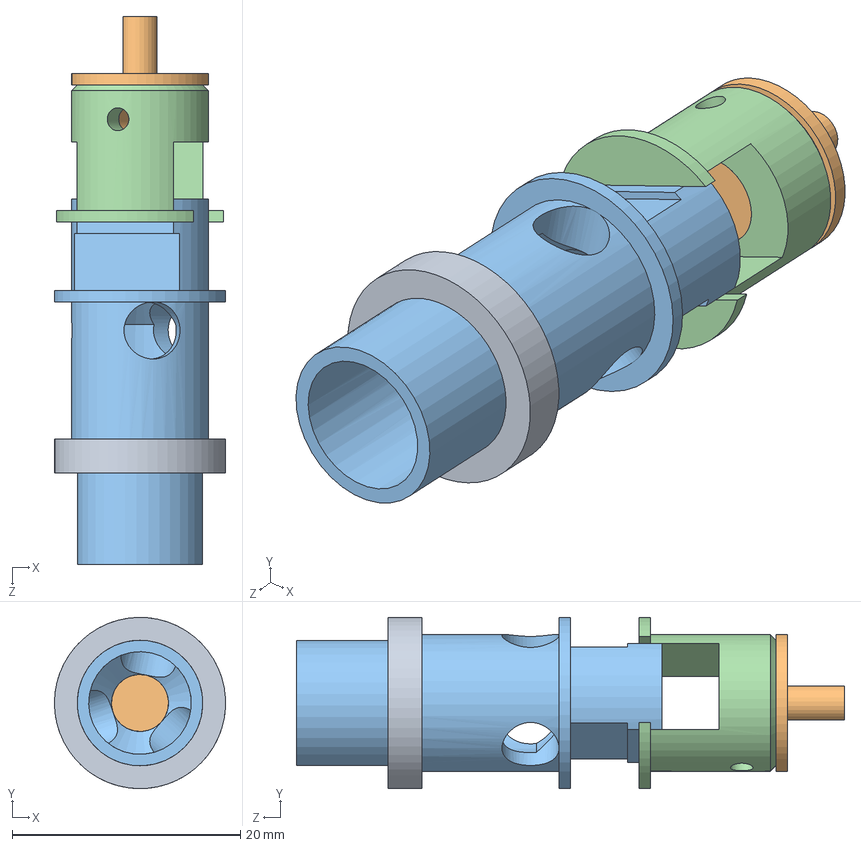
[picture p55: CAD file, 2026-09-23]
cad_3d/3D Modeling/Nacelle2.SLDASM
15.0 x 15.0 x 48.0 mm
Pièce5_BagueArret
Pièce5_RaccordCardon
Pièce5_Tube
Pièce5_Guide
