DjidelAbdelali/pfe/cad_3d/3D Modeling/poulieDents.SLDASM

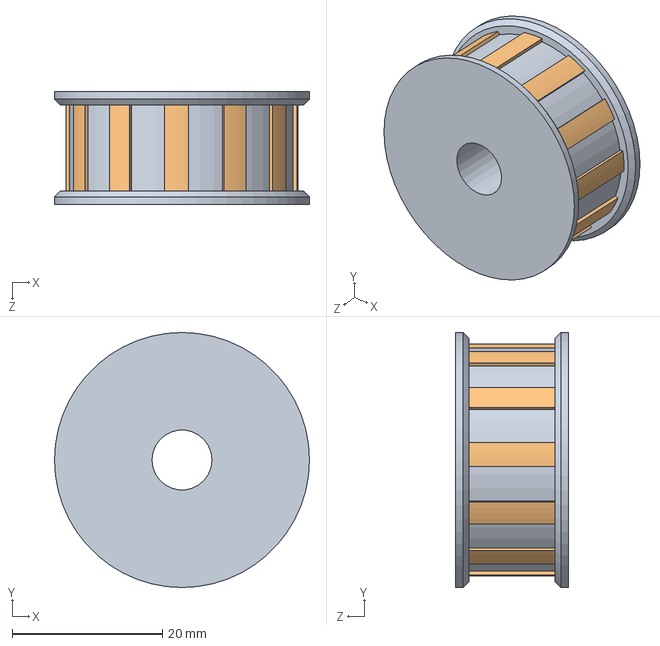
[picture p56: CAD file, 2026-09-23]
cad_3d/3D Modeling/poulieDents.SLDASM
34.0 x 34.0 x 15.0 mm
Pièce1_poulie_renvoie
Pièce1_poulie_dents
