DjidelAbdelali/pfe/cad_3d/3D Modeling/PignonDents.SLDASM

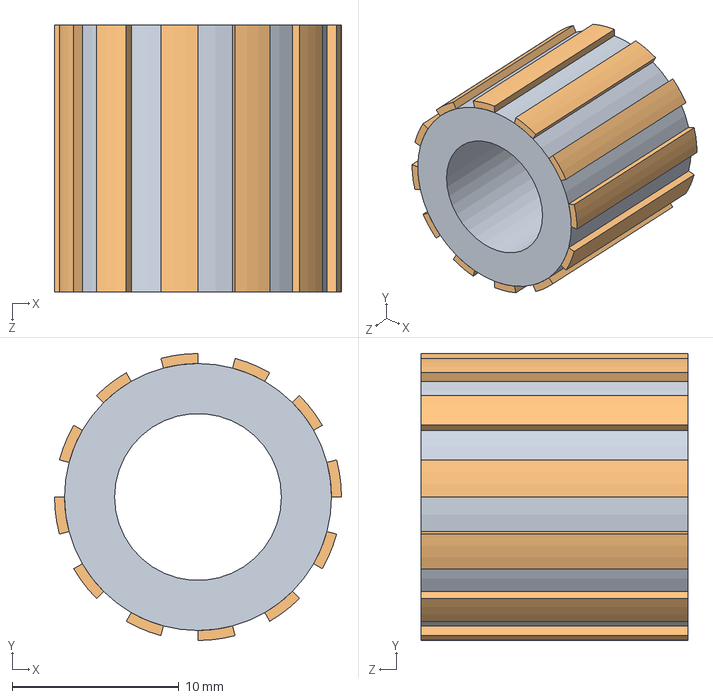
[picture p57: CAD file, 2026-09-23]
cad_3d/3D Modeling/PignonDents.SLDASM
17.2 x 17.2 x 16.0 mm
Pièce1_PignionModifie
Pièce1_PignionModifie_dents
