DjidelAbdelali/pfe/cad_3d/3D Modeling/Pirce0_Roeu.SLDASM

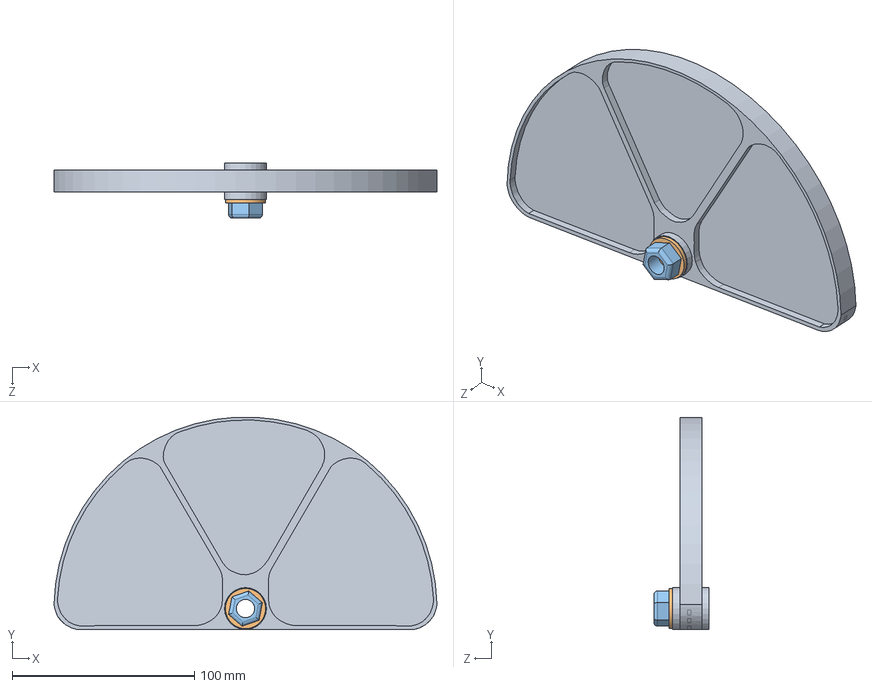
[picture p58: CAD file, 2026-09-23]
cad_3d/3D Modeling/Pirce0_Roeu.SLDASM
210.0 x 116.4 x 30.4 mm
Pièce1_Roue
Pièce1_Rendelle
Pièce2_EcrouBras
