DjidelAbdelali/pfe/cad_3d/3D Modeling/Base.SLDASM

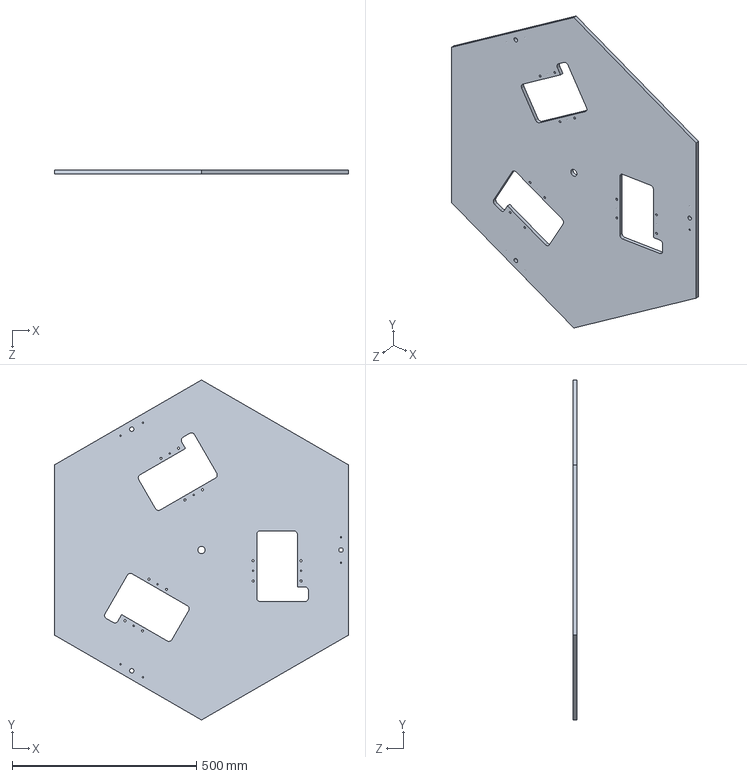
[picture p59: CAD file, 2026-09-23]
cad_3d/3D Modeling/Base.SLDASM
798.5 x 922.0 x 10.0 mm
