DjidelAbdelali/pfe/cad_3d/3D Modeling/Assemblage3.SLDASM

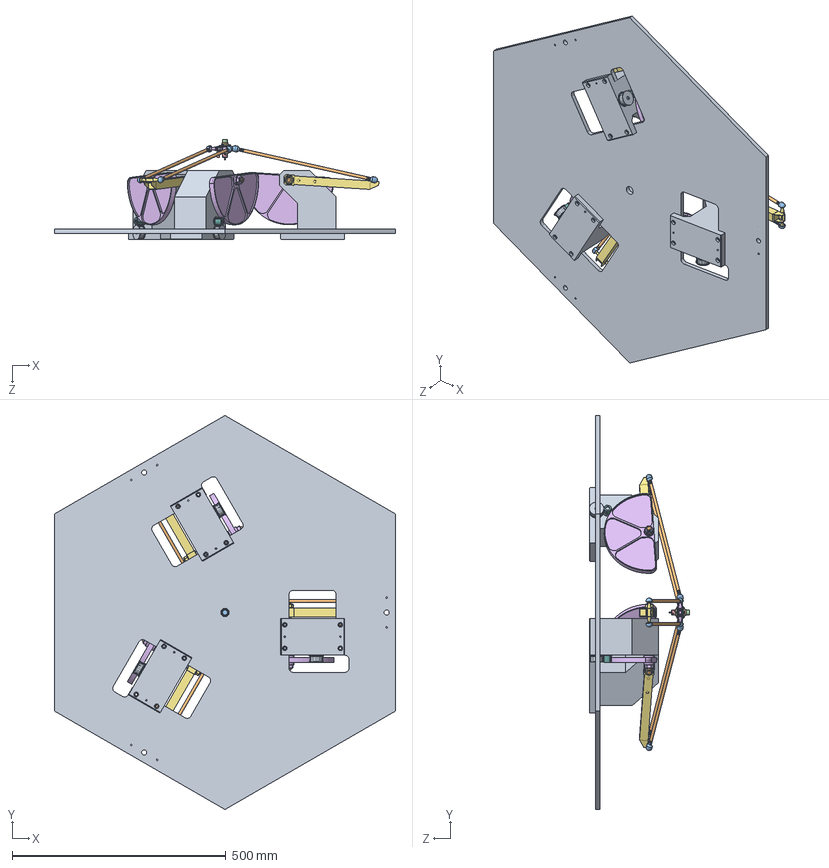
[picture p60: CAD file, 2026-09-23]
cad_3d/3D Modeling/Assemblage3.SLDASM
798.5 x 922.0 x 235.0 mm
Pièce0_Base
Pièce4_Tube x 6
Pièce4_Extremetees x 12
Pièce5_Nacelle
Pièce5_RaccordTuyau
Pièce2_Articulation x 3
Pièce5_Capot x 2
Pièce5_ViceTcyM2.5_10 x 6
Pièce5_ViceTcyM3_10 x 6
Pièce5_BagueArret
Pièce5_RaccordCardon
Pièce5_Tube
Pièce5_Guide
Pièce1_Roue_ecrou x 3
Pièce0_Bras x 3
Pièce1_PignonDents x 3
Pièce1_poulieDents x 3
Pièce1_arbre x 3
