DjidelAbdelali/pfe/cad_3d/3D Modeling/Complement_Base.SLDASM

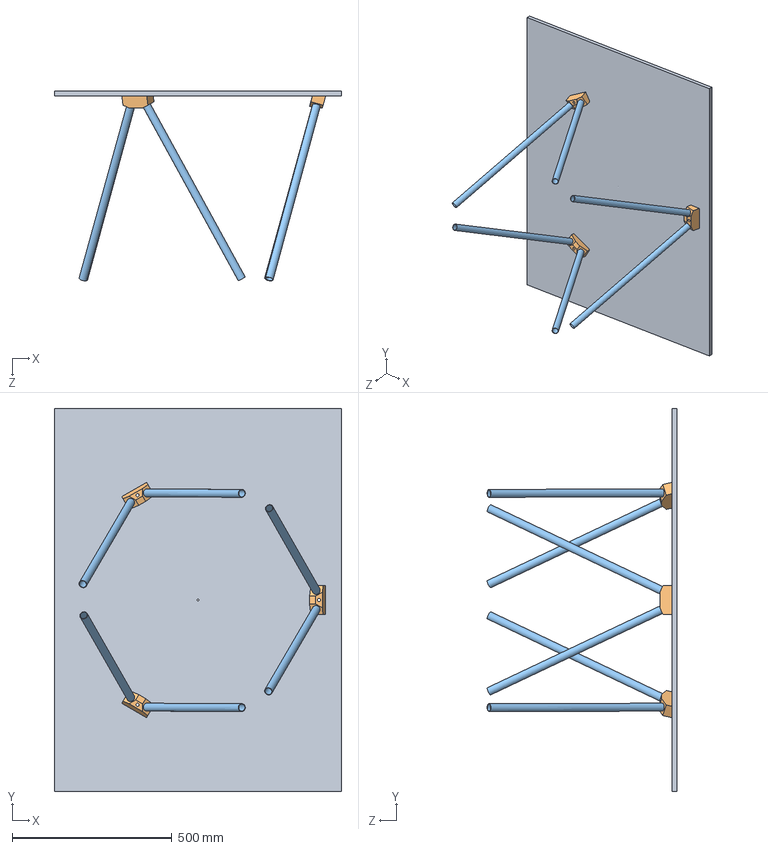
[picture p61: CAD file, 2026-09-23]
cad_3d/3D Modeling/Complement_Base.SLDASM
900.0 x 1200.0 x 594.6 mm
Pièce6_ComplementBase
Pièce6_supportPied x 3
Pièce6_pieds x 6
