DjidelAbdelali/pfe/cad_3d/3D Modeling/BarreParalleles22.SLDASM

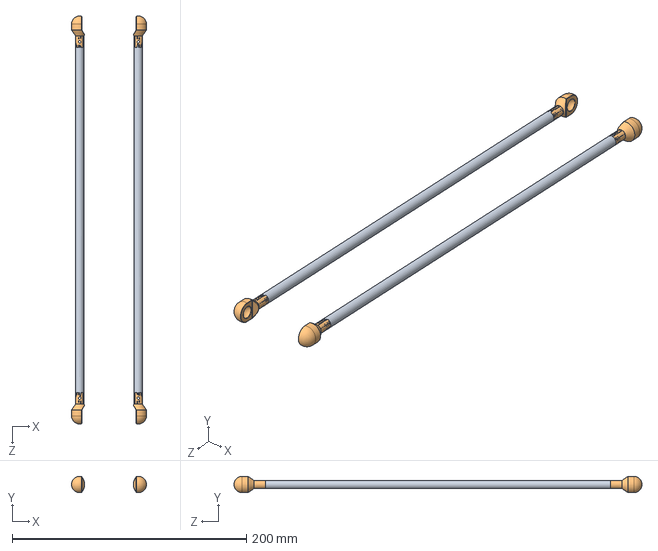
[picture p62: CAD file, 2026-09-23]
cad_3d/3D Modeling/BarreParalleles22.SLDASM
64.0 x 14.0 x 348.0 mm
Pièce4_Tube x 2
Pièce4_Extremetees x 4
