DjidelAbdelali/pfe/cad_3d/3D Modeling/Nacelle1.SLDASM

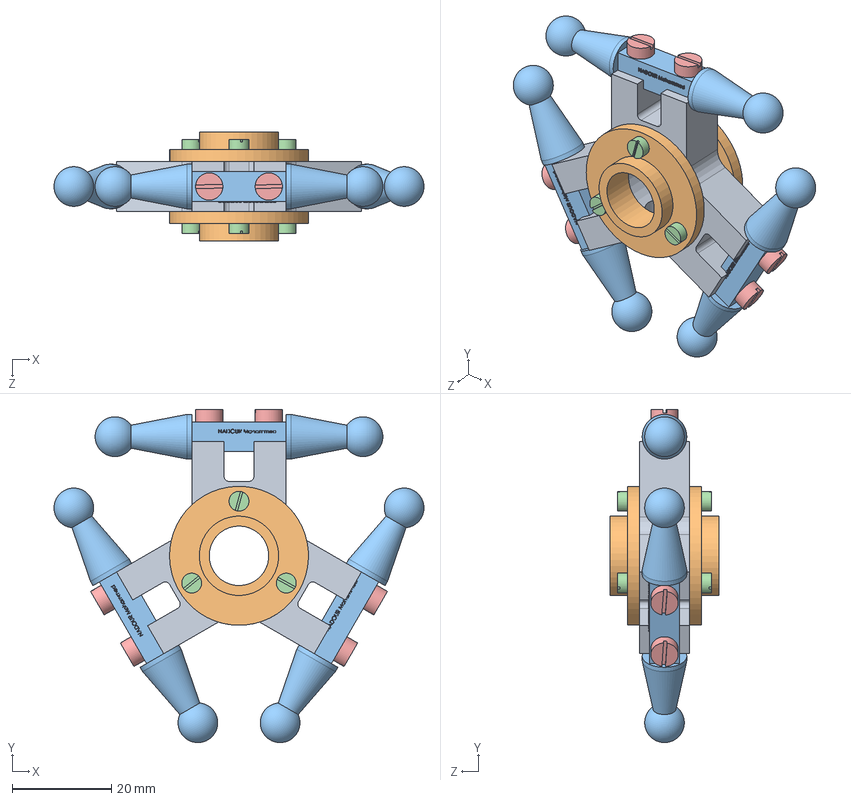
[picture p64: CAD file, 2026-09-23]
cad_3d/3D Modeling/Nacelle1.SLDASM
74.6 x 67.1 x 22.0 mm
Pièce5_Nacelle
Pièce5_Capot x 2
Pièce2_Articulation x 3
Pièce5_ViceTcyM2.5_10 x 6
Pièce5_ViceTcyM3_10 x 6
