DjidelAbdelali/pfe/cad_3d/3D Modeling/BarreParalleles.SLDASM

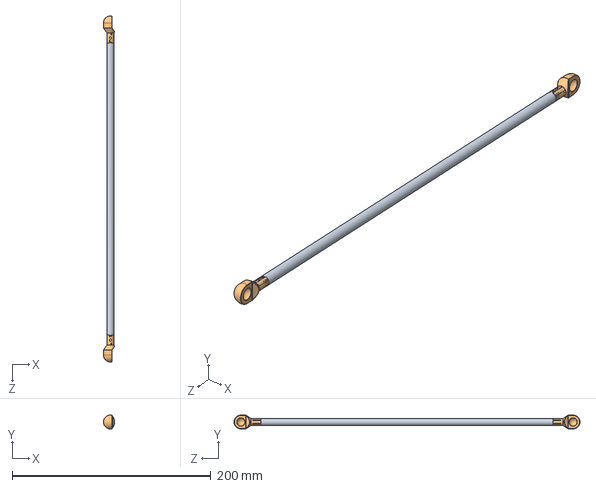
[picture p65: CAD file, 2026-09-23]
cad_3d/3D Modeling/BarreParalleles.SLDASM
11.2 x 14.0 x 348.0 mm
Pièce4_Tube
Pièce4_Extremetees x 2
