DjidelAbdelali/pfe/cad_3d/3D Modeling/BarreParalleles2.SLDASM

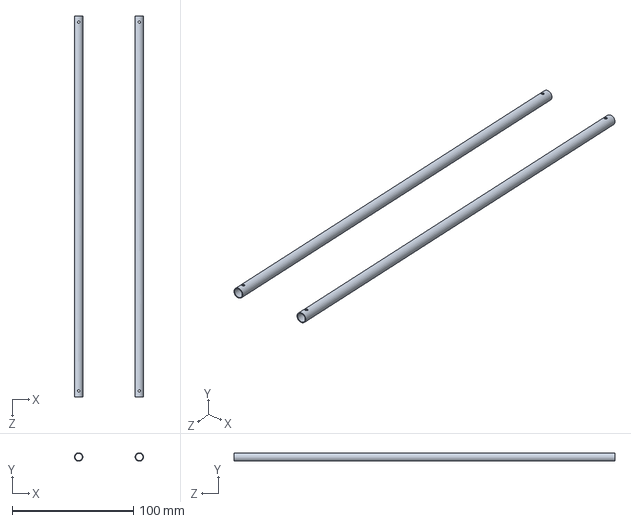
[picture p66: CAD file, 2026-09-23]
cad_3d/3D Modeling/BarreParalleles2.SLDASM
57.0 x 7.00 x 314.0 mm
Pièce4_Tube x 2
