DjidelAbdelali/pfe/cad_3d/3D Modeling/BlocMoteur.SLDASM

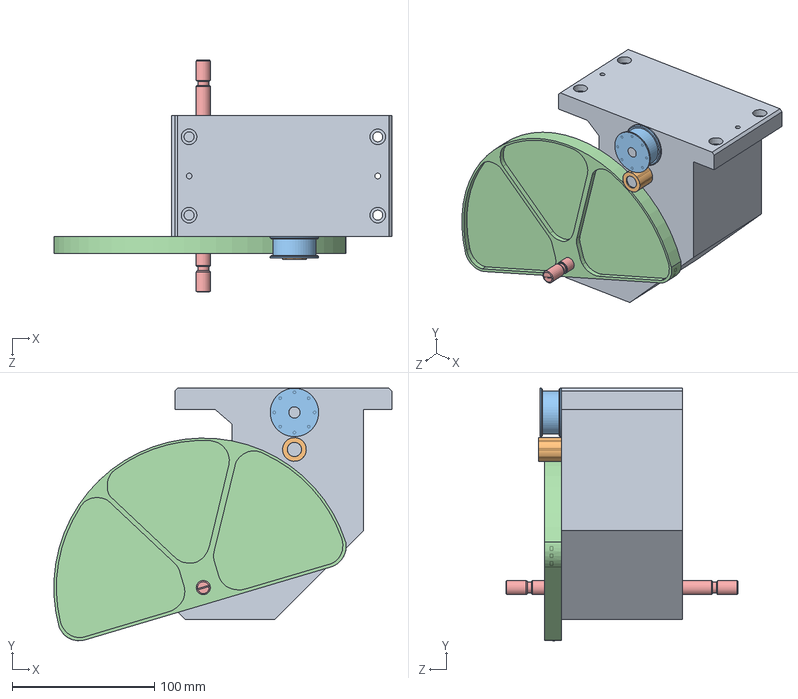
[picture p67: CAD file, 2026-09-23]
cad_3d/3D Modeling/BlocMoteur.SLDASM
237.4 x 177.3 x 163.0 mm
Pièce1_BlocMoteur
Pièce1_PignionModifie
Pièce1_poulie_renvoie
Pièce1_Roue
Pièce1_arbre
