DjidelAbdelali/pfe/cad_3d/3D Modeling/RobotDelta2.SLDASM

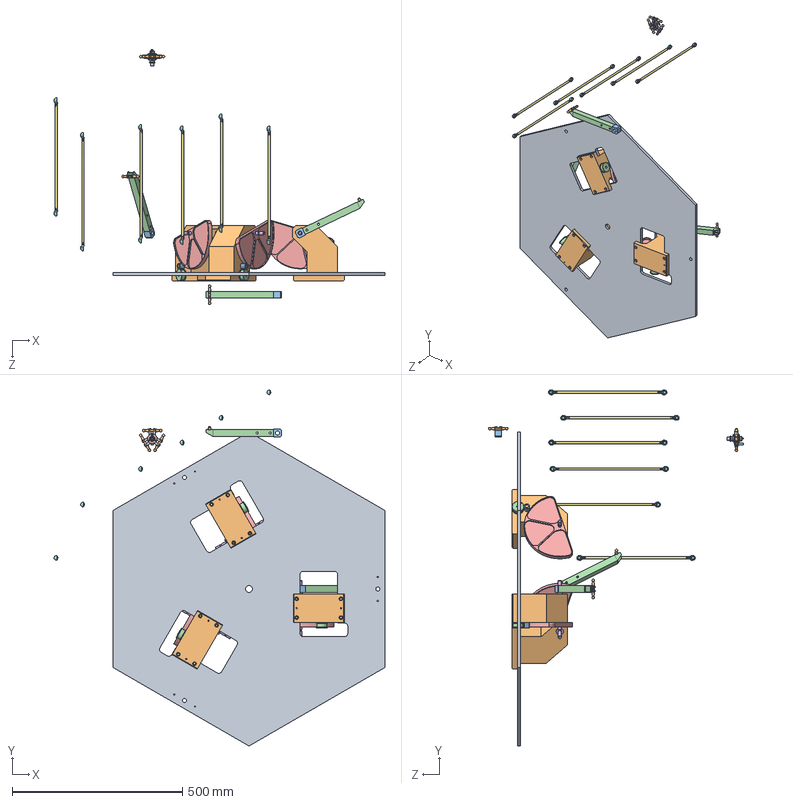
[picture p68: CAD file, 2026-09-23]
cad_3d/3D Modeling/RobotDelta2.SLDASM
971.7 x 1045.2 x 749.2 mm
Pièce0_Plaque
Pièce1_BlocMoteur x 3
Pièce1_PignionModifie x 3
Pièce1_poulie_renvoie x 3
Pièce1_Roue x 3
Pièce1_arbre x 3
Pièce4_Tube x 6
Pièce4_Extremetees x 12
Pièce5_Nacelle
Pièce2_Articulation x 6
Pièce5_BagueArret
Pièce5_RaccordCardon
Pièce5_Capot x 2
Pièce5_Tube
Pièce5_Guide
Pièce5_RaccordTuyau
Pièce5_ViceTcyM2.5_10 x 6
Pièce5_ViceTcyM3_10 x 12
Pièce2_support_bras x 3
Pièce3_Bras x 3
Pièce3_EcrouBras x 3
Pièce3_BagueBras x 3
