DjidelAbdelali/pfe/cad_3d/3D Modeling/Nacelle.SLDASM

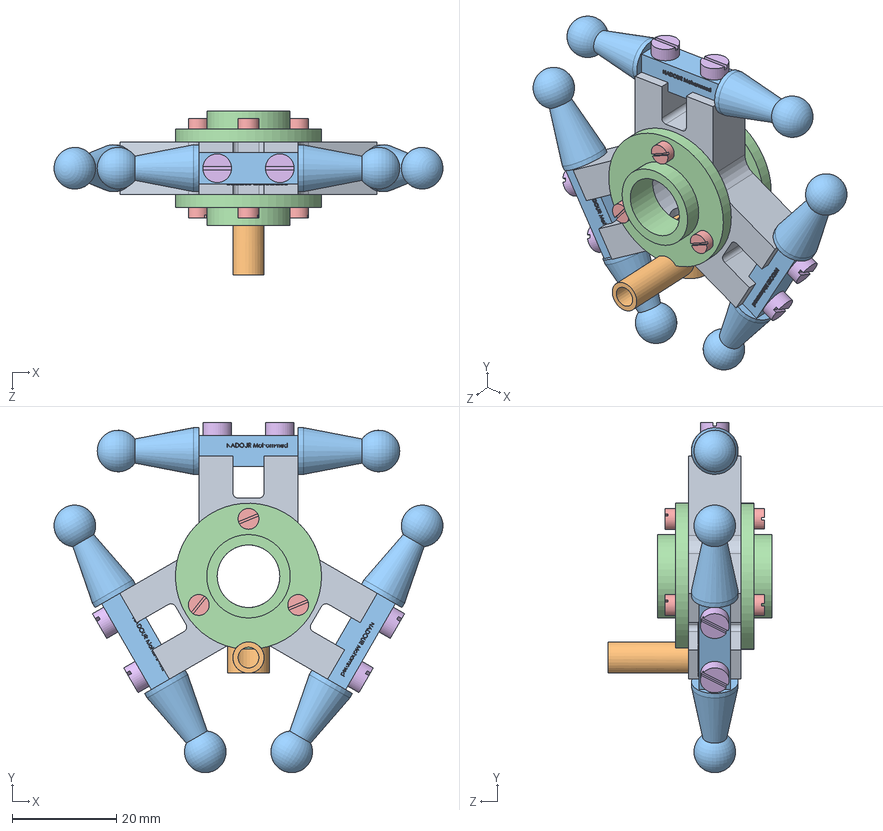
[picture p70: CAD file, 2026-09-23]
cad_3d/3D Modeling/Nacelle.SLDASM
74.6 x 67.1 x 31.5 mm
Pièce5_Nacelle
Pièce5_RaccordTuyau
Pièce2_Articulation x 3
Pièce5_Capot x 2
Pièce5_ViceTcyM2.5_10 x 6
Pièce5_ViceTcyM3_10 x 6
