DjidelAbdelali/pfe/cad_3d/3D Modeling/Bras.SLDASM

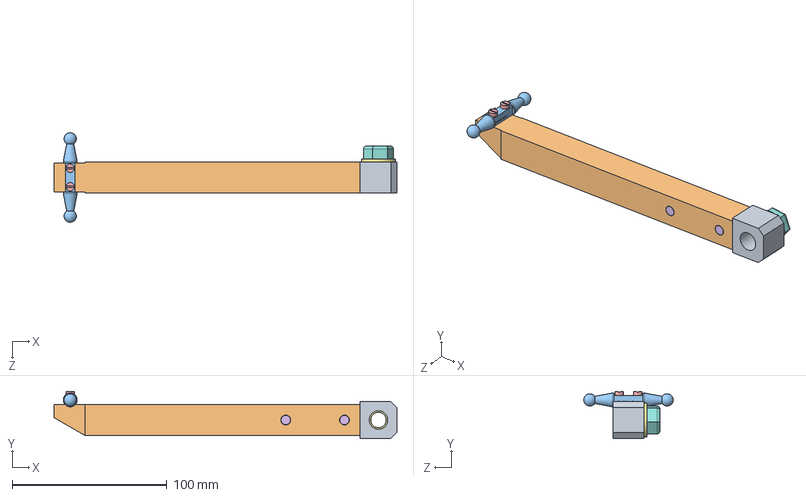
[picture p71: CAD file, 2026-09-23]
cad_3d/3D Modeling/Bras.SLDASM
222.0 x 30.5 x 58.0 mm
Pièce2_support_bras
Pièce3_Bras
Pièce2_Articulation
Pièce3_EcrouBras
Pièce5_ViceTcyM3_10 x 2
Pièce3_VisBras x 2
Pièce1_Rendelle
Pièce2_EcrouBras
