DjidelAbdelali/pfe/cad_3d/3D Modeling/Pièce5_Nacelle.SLDPRT

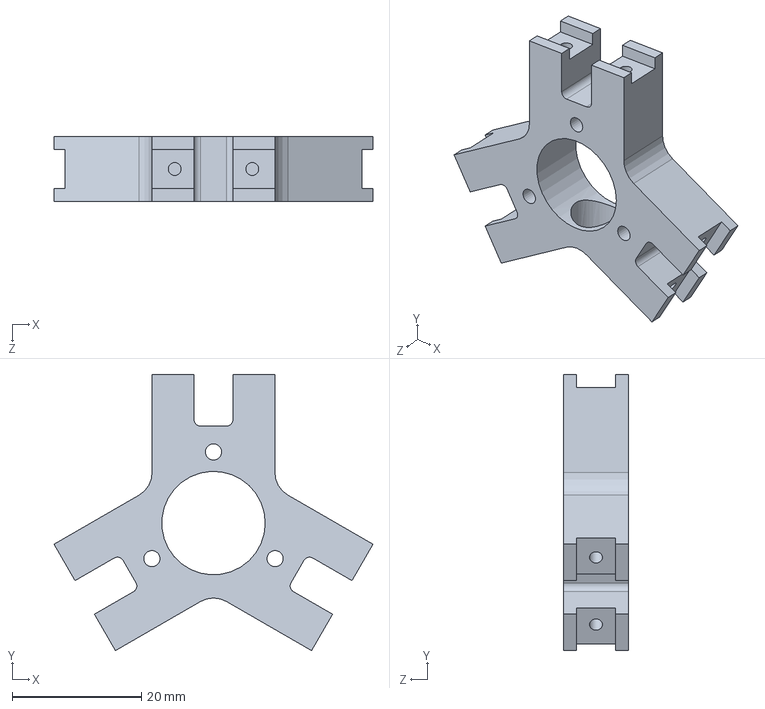
[picture p72: CAD file, 2026-09-23]
cad_3d/3D Modeling/Pièce5_Nacelle.SLDPRT
49.3 x 42.7 x 10.0 mm
