DjidelAbdelali/pfe/cad_3d/3D Modeling/Pièce5_Capot_Défaut_sldprt.STEP

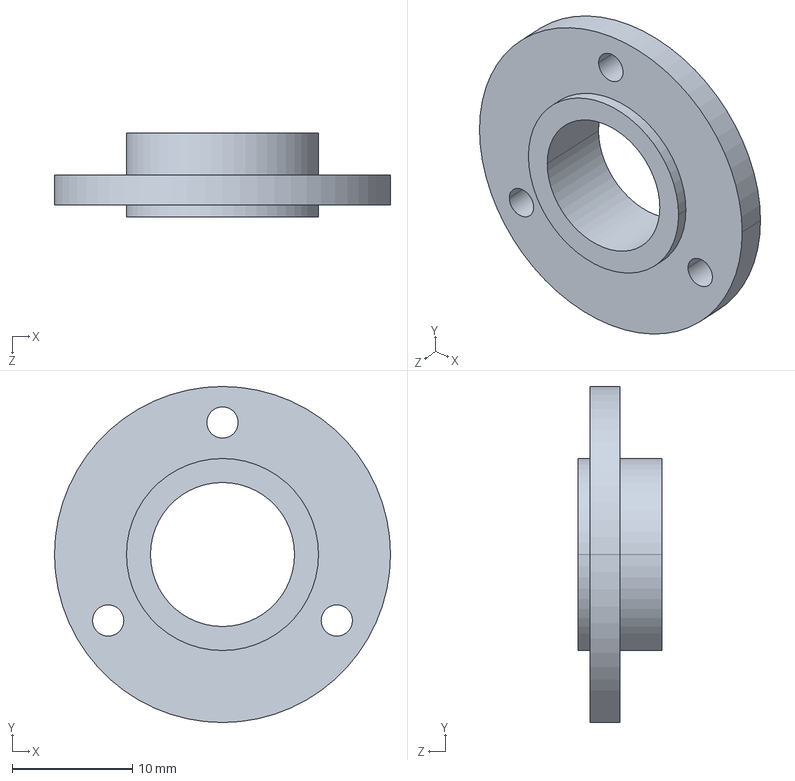
[picture p73: CAD file, 2026-09-23]
cad_3d/3D Modeling/Pièce5_Capot_Défaut_sldprt.STEP
28.0 x 28.0 x 7.00 mm
