DjidelAbdelali/pfe/cad_3d/Brass.SLDPRT

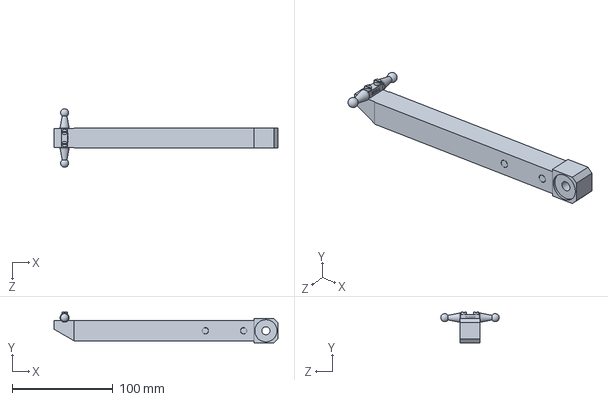
[picture p74: CAD file, 2026-09-23]
cad_3d/Brass.SLDPRT
222.0 x 30.5 x 58.0 mm
