DjidelAbdelali/pfe/cad_3d/3D Modeling/Pièce3_EcrouBras.SLDPRT

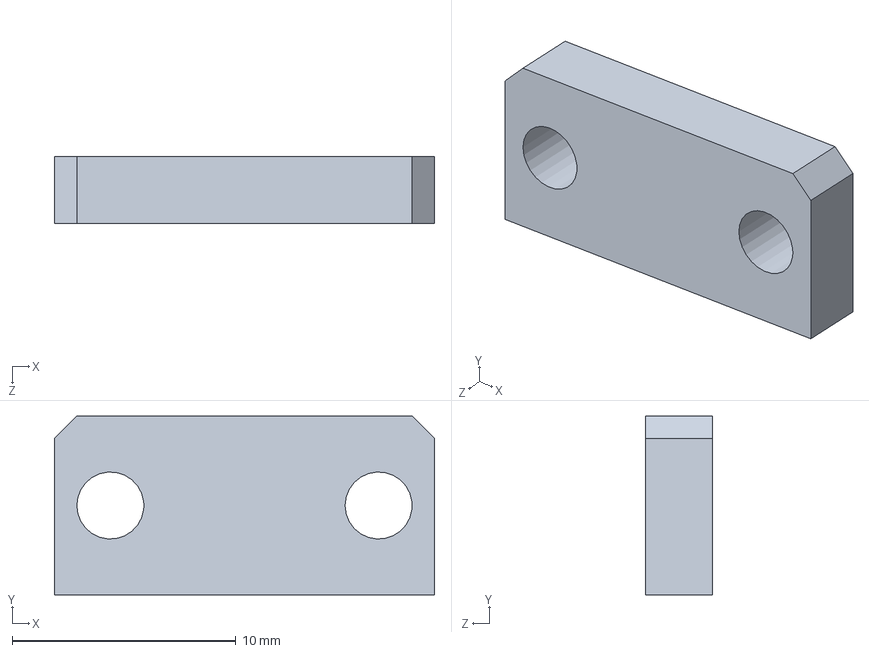
[picture p75: CAD file, 2026-09-23]
cad_3d/3D Modeling/Pièce3_EcrouBras.SLDPRT
17.0 x 8.00 x 3.00 mm
