DjidelAbdelali/pfe/cad_3d/Pièce1_Roue_ecrou modif 2.SLDPRT

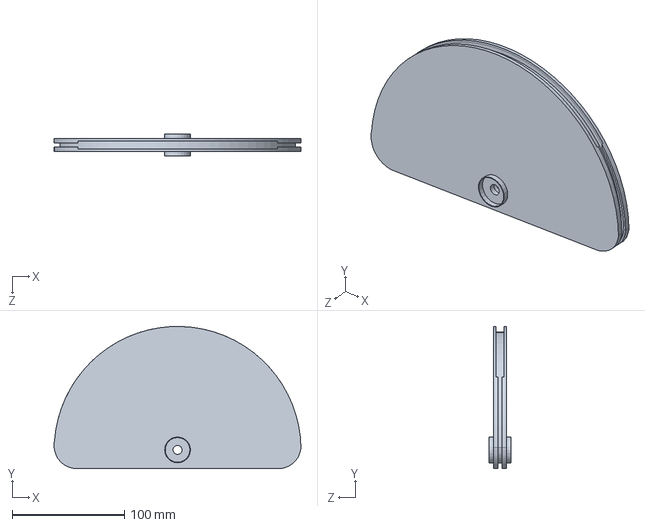
[picture p76: CAD file, 2026-09-23]
cad_3d/Pièce1_Roue_ecrou modif 2.SLDPRT
220.1 x 126.6 x 20.0 mm
