DjidelAbdelali/pfe/cad_3d/3D Modeling/Pièce2_Articulation_Défaut_sldprt.STEP

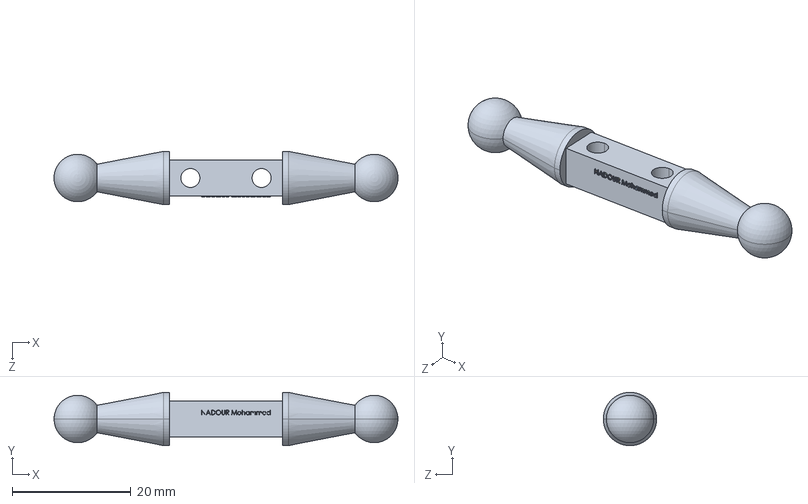
[picture p77: CAD file, 2026-09-23]
cad_3d/3D Modeling/Pièce2_Articulation_Défaut_sldprt.STEP
58.0 x 9.00 x 9.00 mm
