DjidelAbdelali/pfe/cad_3d/3D Modeling/Pièce1_PignionModifie.SLDPRT

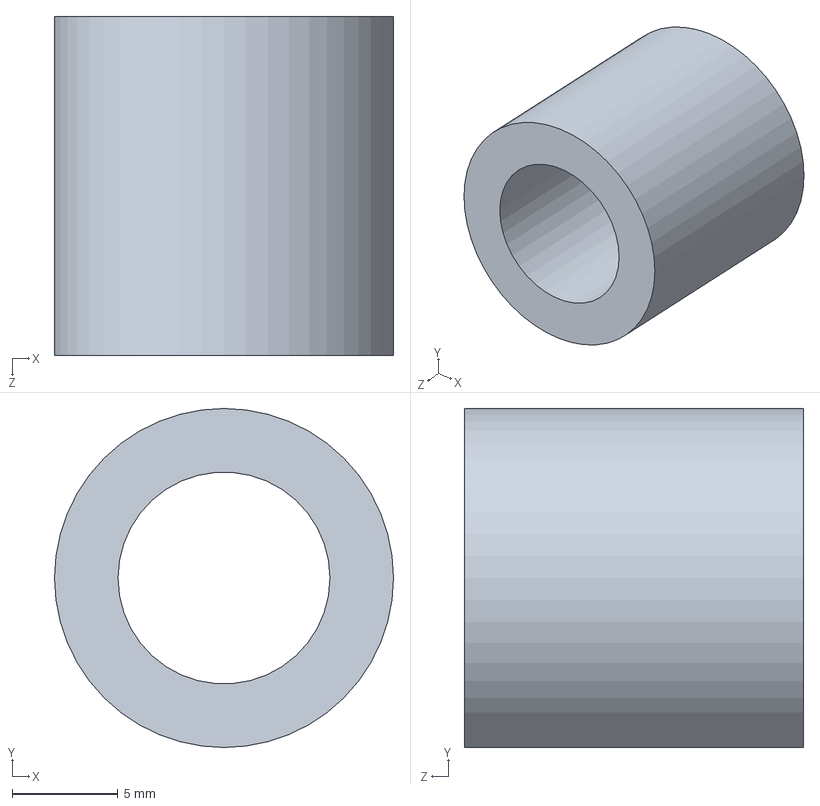
[picture p78: CAD file, 2026-09-23]
cad_3d/3D Modeling/Pièce1_PignionModifie.SLDPRT
16.0 x 16.0 x 16.0 mm
