DjidelAbdelali/pfe/cad_3d/608-z_04.SLDPRT

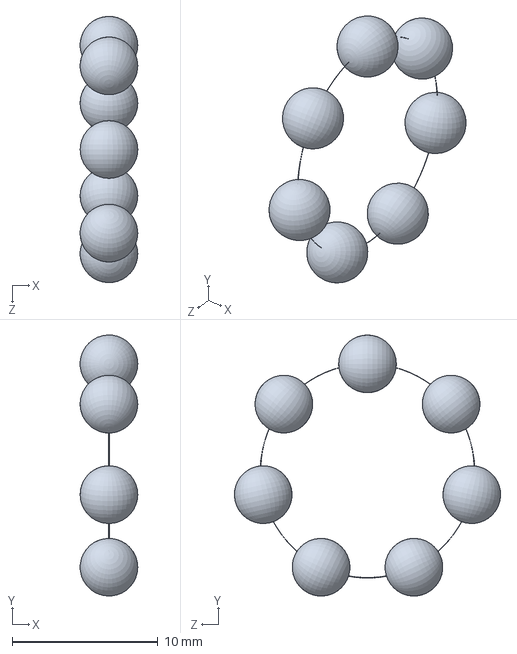
[picture p79: CAD file, 2026-09-23]
cad_3d/608-z_04.SLDPRT
3.96 x 17.9 x 18.3 mm
