DjidelAbdelali/pfe/cad_3d/3D Modeling/Pièce5_ViceTcyM2.5_10_Défaut_sldprt.STEP

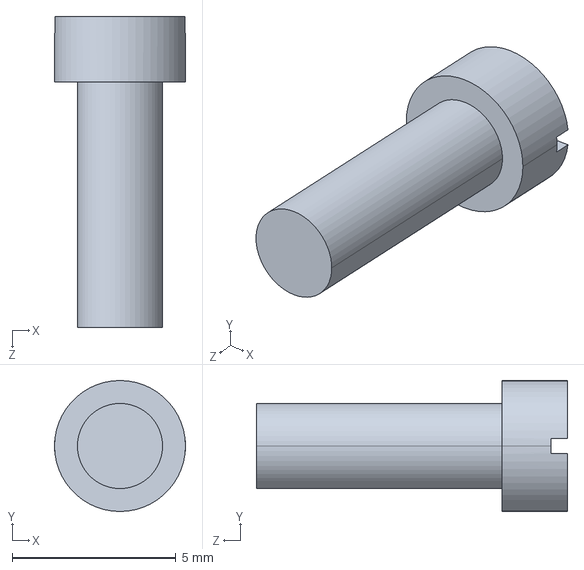
[picture p80: CAD file, 2026-09-23]
cad_3d/3D Modeling/Pièce5_ViceTcyM2.5_10_Défaut_sldprt.STEP
4.00 x 4.00 x 9.50 mm
