DjidelAbdelali/pfe/cad_3d/Gates_2GT_20T_Smooth_Idler.SLDPRT

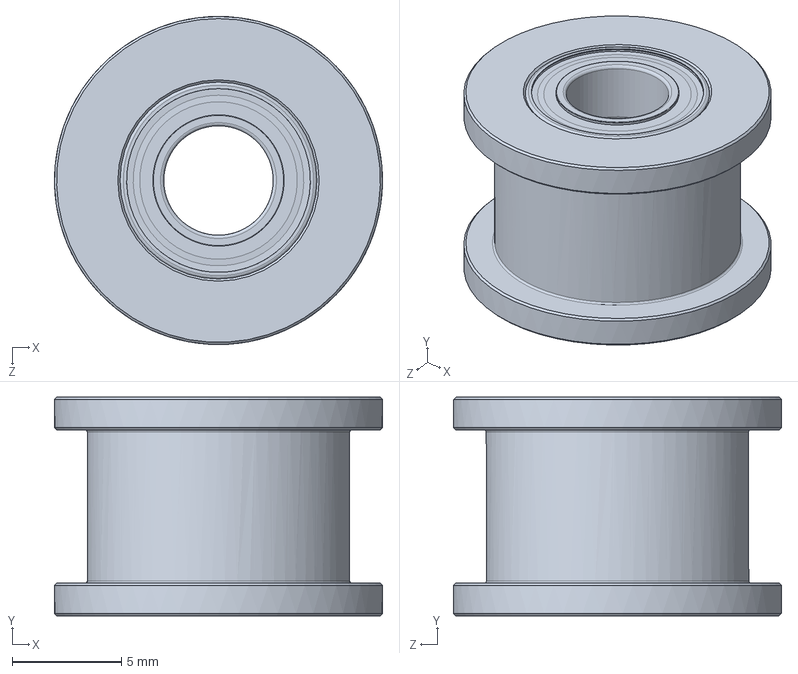
[picture p81: CAD file, 2026-09-23]
cad_3d/Gates_2GT_20T_Smooth_Idler.SLDPRT
15.0 x 10.0 x 15.0 mm
