DjidelAbdelali/pfe/cad_3d/3D Modeling/Pièce4_Extremetees_Défaut_sldprt.STEP

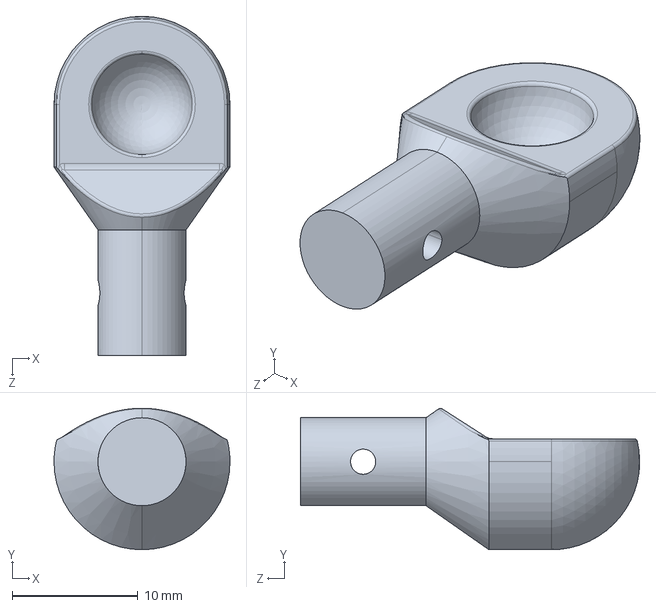
[picture p82: CAD file, 2026-09-23]
cad_3d/3D Modeling/Pièce4_Extremetees_Défaut_sldprt.STEP
14.0 x 11.2 x 27.0 mm
