DjidelAbdelali/pfe/cad_3d/3D Modeling/Pièce4_TubeCarre_Défaut_sldprt.STL

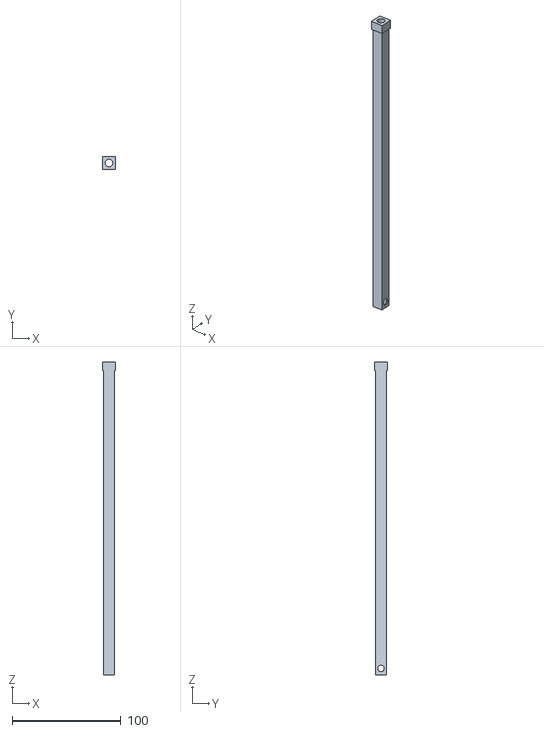
[picture p83: CAD file, 2026-09-23]
cad_3d/3D Modeling/Pièce4_TubeCarre_Défaut_sldprt.STL
12.0 x 12.0 x 288.0
