DjidelAbdelali/pfe/cad_3d/608-z_01.SLDPRT

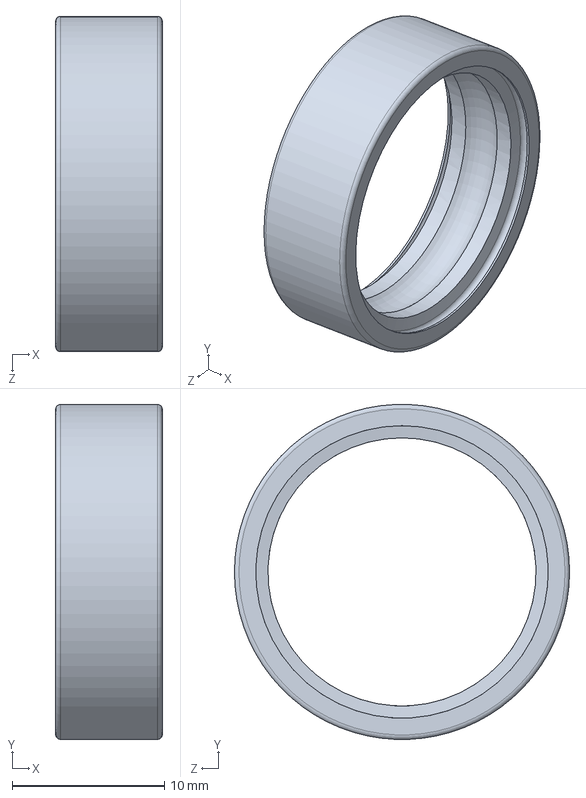
[picture p84: CAD file, 2026-09-23]
cad_3d/608-z_01.SLDPRT
7.00 x 22.0 x 22.0 mm
