DjidelAbdelali/pfe/cad_3d/608-z_03.SLDPRT

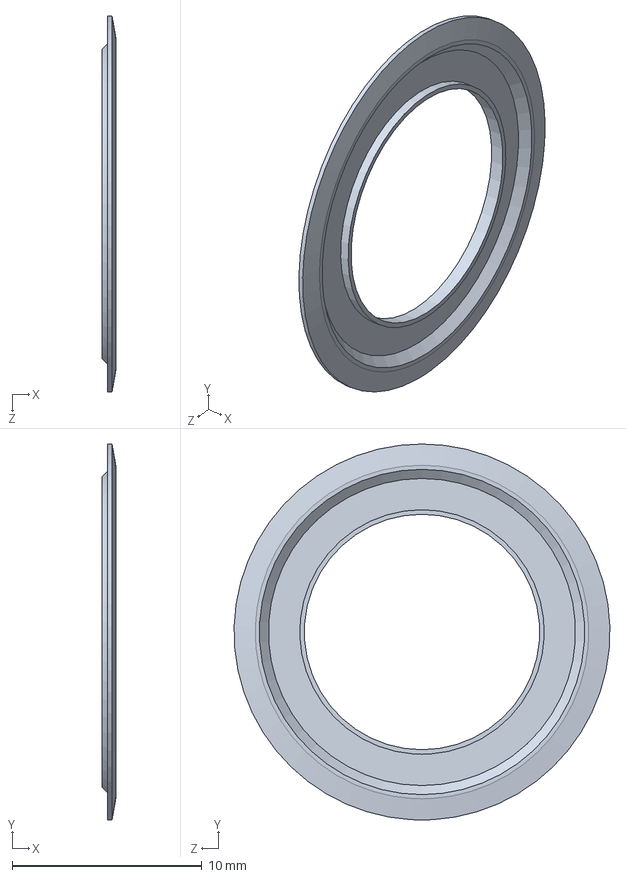
[picture p85: CAD file, 2026-09-23]
cad_3d/608-z_03.SLDPRT
0.72 x 19.8 x 19.8 mm
