DjidelAbdelali/pfe/cad_3d/Pièce4_Tube.SLDPRT

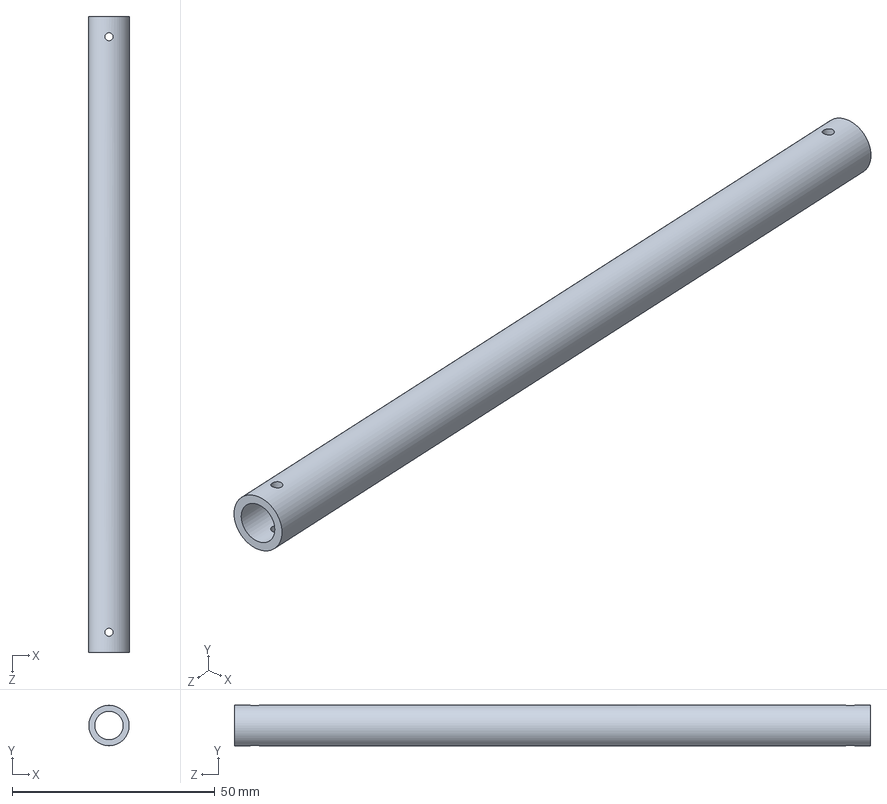
[picture p86: CAD file, 2026-09-23]
cad_3d/Pièce4_Tube.SLDPRT
10.0 x 10.0 x 157.0 mm
