DjidelAbdelali/pfe/cad_3d/3D Modeling/Pièce1_PignionModifie_dents.SLDPRT

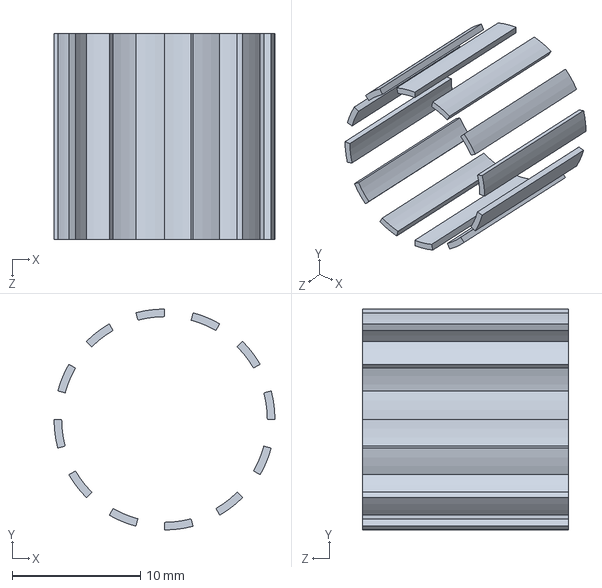
[picture p87: CAD file, 2026-09-23]
cad_3d/3D Modeling/Pièce1_PignionModifie_dents.SLDPRT
17.2 x 17.2 x 16.0 mm
