DjidelAbdelali/pfe/cad_3d/608-z_02.SLDPRT

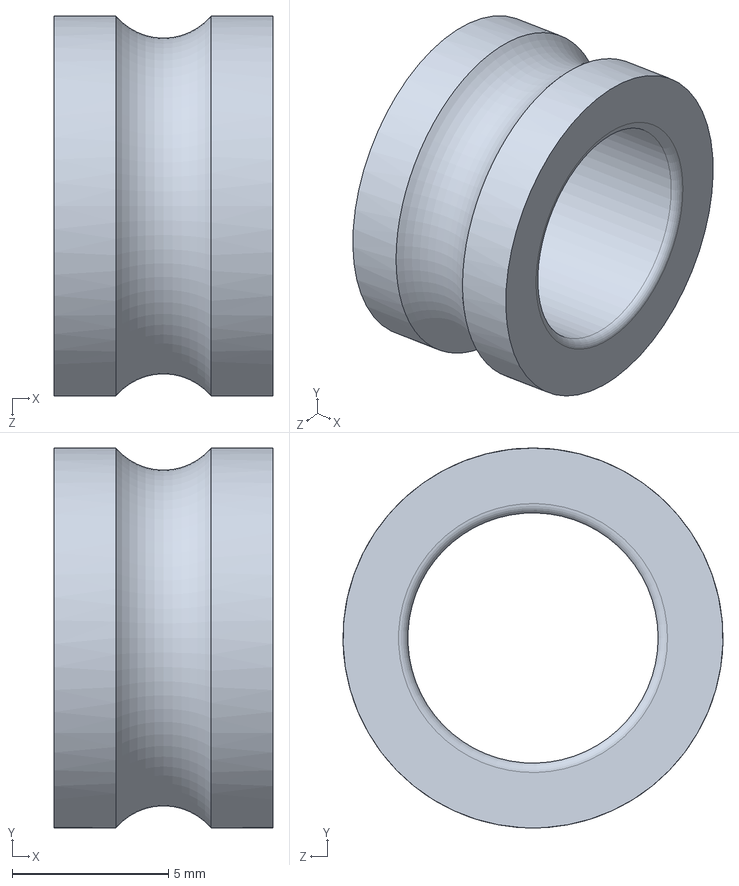
[picture p88: CAD file, 2026-09-23]
cad_3d/608-z_02.SLDPRT
7.00 x 12.1 x 12.1 mm
