DjidelAbdelali/pfe/cad_3d/3D Modeling/Pièce5_RaccordTuyau_Défaut_sldprt.STEP

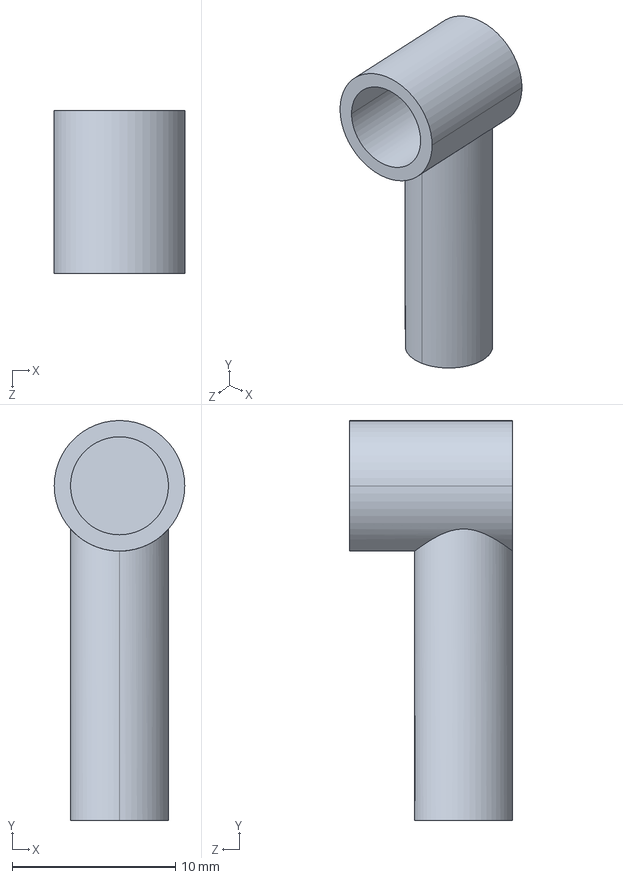
[picture p89: CAD file, 2026-09-23]
cad_3d/3D Modeling/Pièce5_RaccordTuyau_Défaut_sldprt.STEP
8.00 x 24.5 x 10.0 mm
