DjidelAbdelali/pfe/cad_3d/Pièce1_arbre.SLDPRT

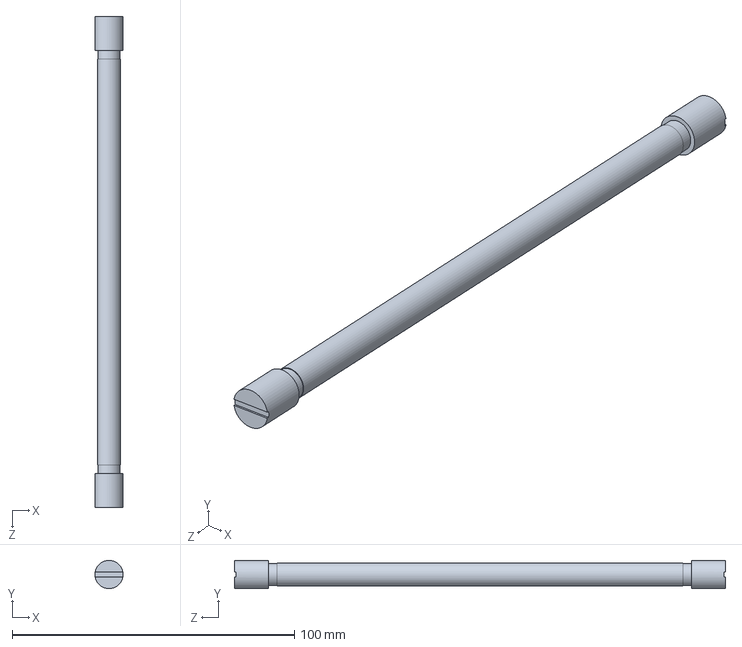
[picture p90: CAD file, 2026-09-23]
cad_3d/Pièce1_arbre.SLDPRT
10.0 x 10.0 x 174.0 mm
