DjidelAbdelali/pfe/cad_3d/3D Modeling/Pièce5_ViceTcyM3_10_Défaut_sldprt.STEP

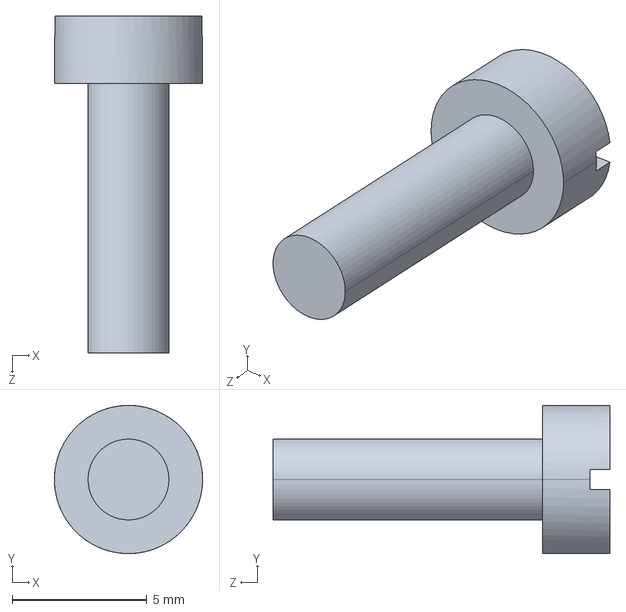
[picture p91: CAD file, 2026-09-23]
cad_3d/3D Modeling/Pièce5_ViceTcyM3_10_Défaut_sldprt.STEP
5.50 x 5.50 x 12.5 mm
