DjidelAbdelali/pfe/cad_3d/3D Modeling/Pièce0_Base_Défaut_sldprt.STEP

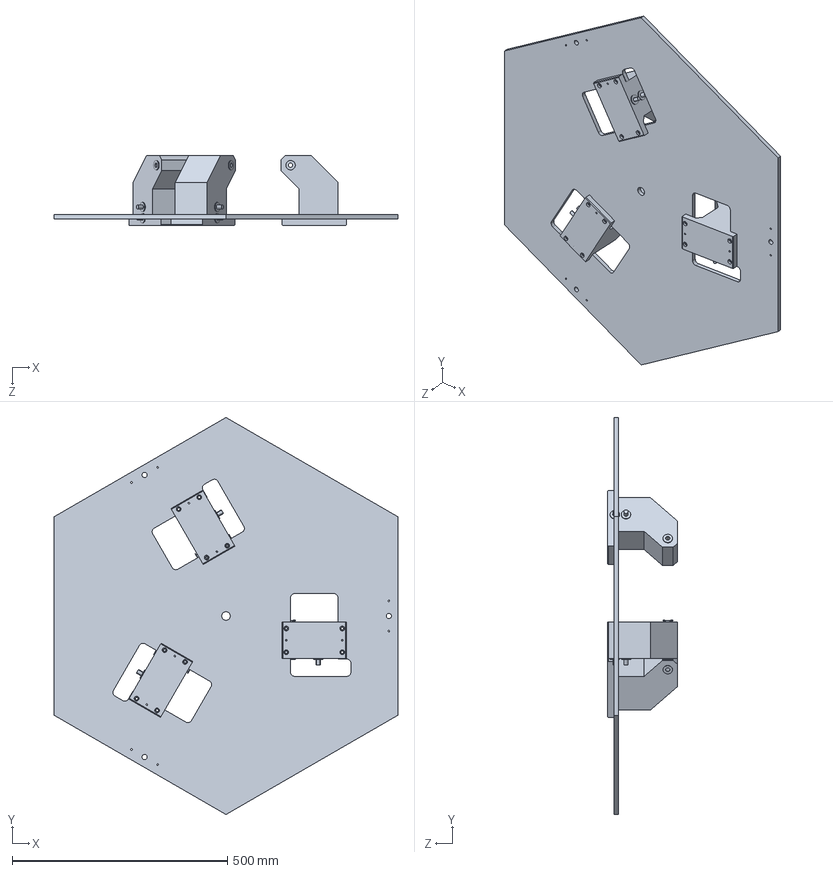
[picture p92: CAD file, 2026-09-23]
cad_3d/3D Modeling/Pièce0_Base_Défaut_sldprt.STEP
798.5 x 922.0 x 162.5 mm
