DjidelAbdelali/pfe/cad_3d/NEMA-17.SLDPRT

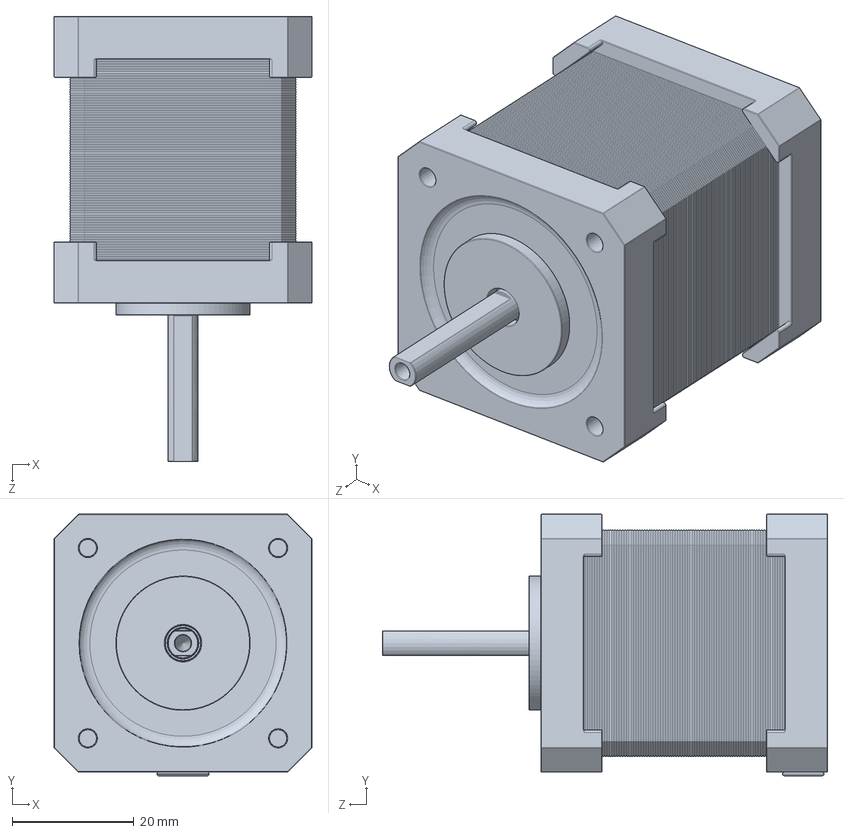
[picture p93: CAD file, 2026-09-23]
cad_3d/NEMA-17.SLDPRT
42.3 x 42.9 x 73.0 mm
