DjidelAbdelali/pfe/cad_3d/GT2 Timing Pulley.SLDPRT

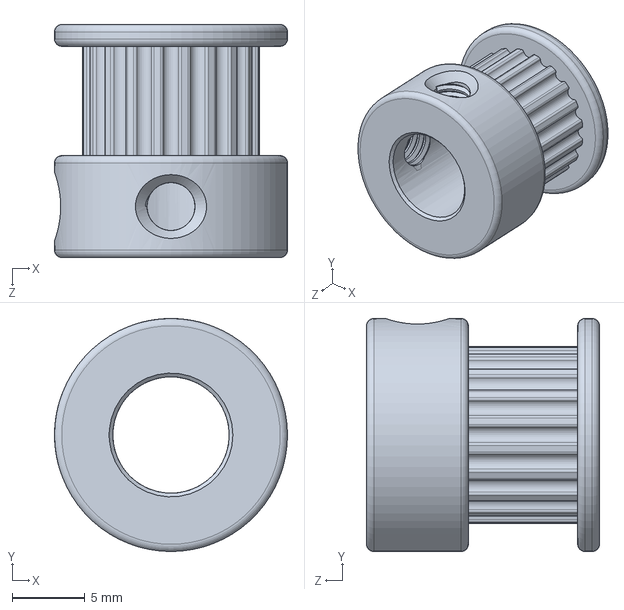
[picture p94: CAD file, 2026-09-23]
cad_3d/GT2 Timing Pulley.SLDPRT
16.0 x 16.0 x 16.0 mm
