DjidelAbdelali/pfe/cad_3d/3D Modeling/Pièce5_Guide_Défaut_sldprt.STEP

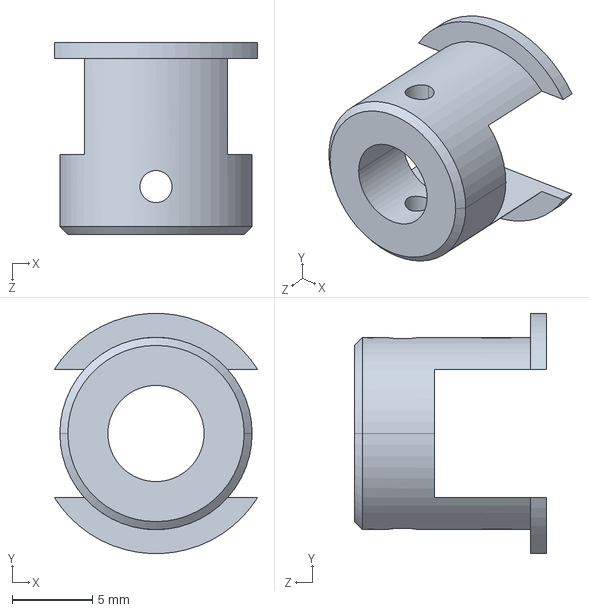
[picture p95: CAD file, 2026-09-23]
cad_3d/3D Modeling/Pièce5_Guide_Défaut_sldprt.STEP
12.7 x 15.0 x 12.0 mm
