DjidelAbdelali/pfe/cad_3d/3D Modeling/Pièce1_poulieDents_Défaut_sldprt.STEP

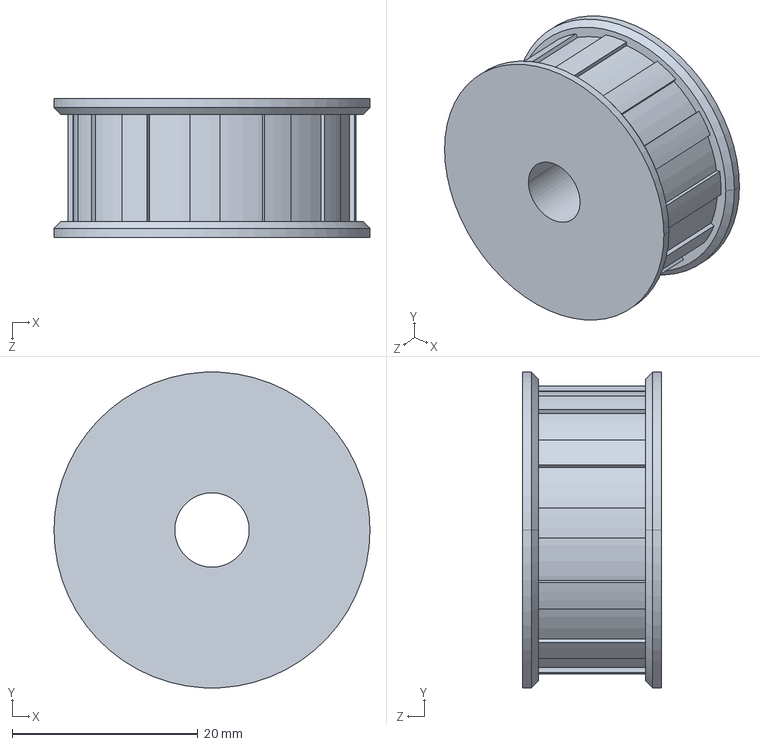
[picture p96: CAD file, 2026-09-23]
cad_3d/3D Modeling/Pièce1_poulieDents_Défaut_sldprt.STEP
34.0 x 34.0 x 15.0 mm
