DjidelAbdelali/pfe/cad_3d/3D Modeling/Pièce2_support_bras.SLDPRT

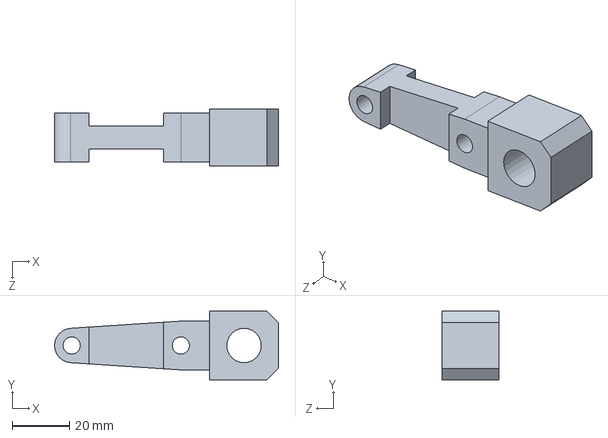
[picture p97: CAD file, 2026-09-23]
cad_3d/3D Modeling/Pièce2_support_bras.SLDPRT
78.0 x 24.0 x 20.0 mm
