DjidelAbdelali/pfe/cad_3d/3D Modeling/Final BlocMoteur.SLDPRT

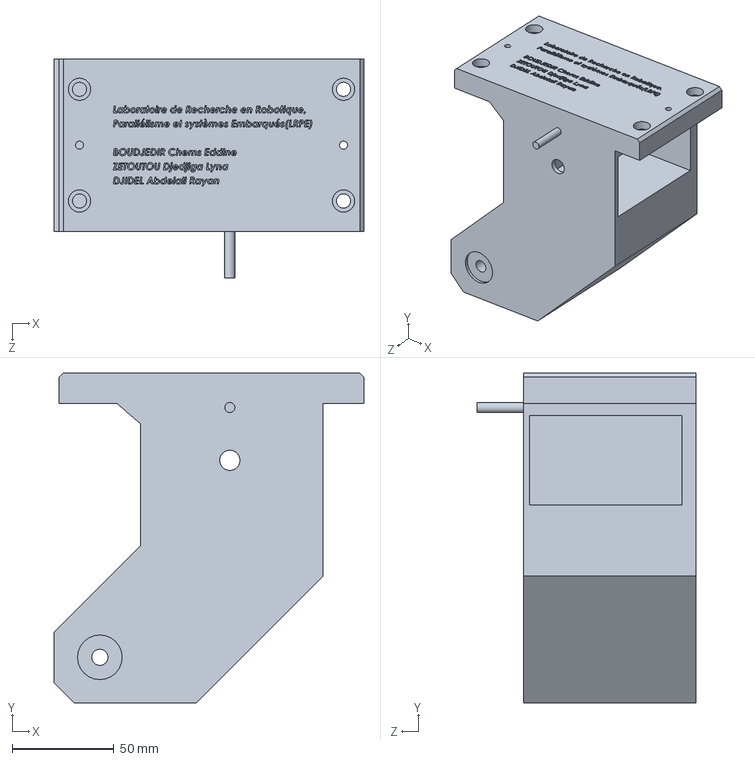
[picture p98: CAD file, 2026-09-23]
cad_3d/3D Modeling/Final BlocMoteur.SLDPRT
152.5 x 162.5 x 108.0 mm
