DjidelAbdelali/pfe/cad_3d/3D Modeling/Pièce1_BlocMoteur.SLDPRT

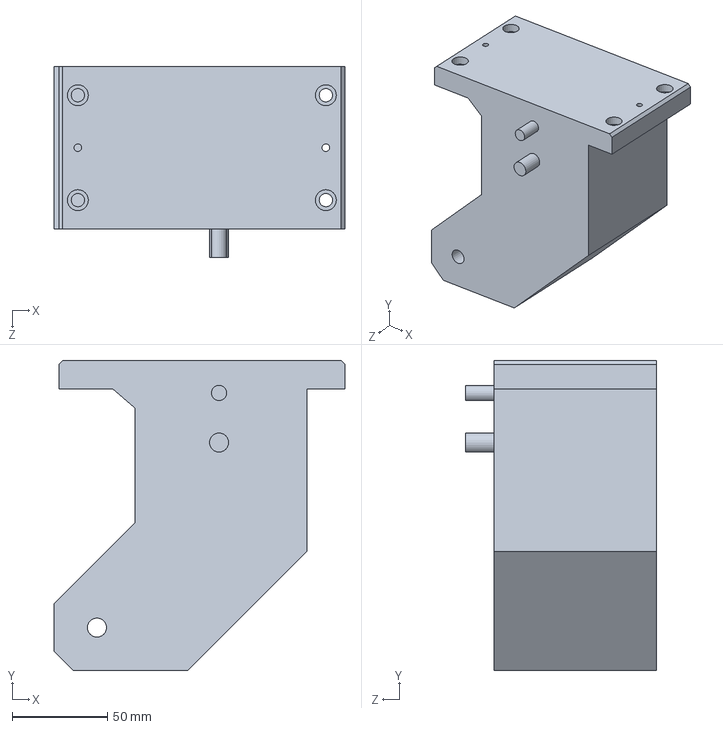
[picture p99: CAD file, 2026-09-23]
cad_3d/3D Modeling/Pièce1_BlocMoteur.SLDPRT
152.5 x 162.5 x 100.0 mm
