DjidelAbdelali/pfe/cad_3d/3D Modeling/Pièce5_RaccordCardon_Défaut_sldprt.STEP

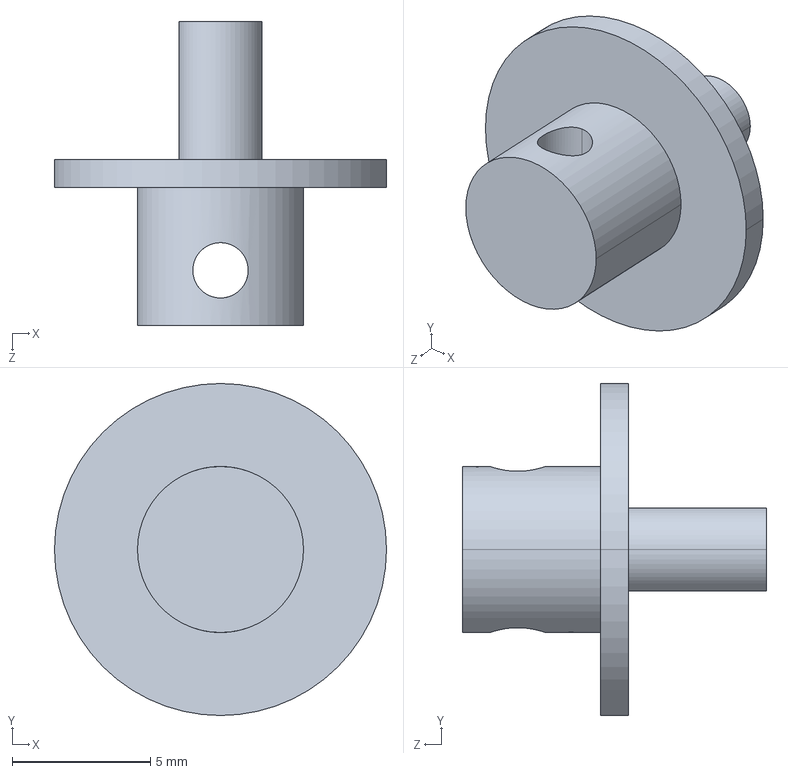
[picture p100: CAD file, 2026-09-23]
cad_3d/3D Modeling/Pièce5_RaccordCardon_Défaut_sldprt.STEP
12.0 x 12.0 x 11.0 mm
