DjidelAbdelali/pfe/cad_3d/3D Modeling/Pièce6_pieds.SLDPRT

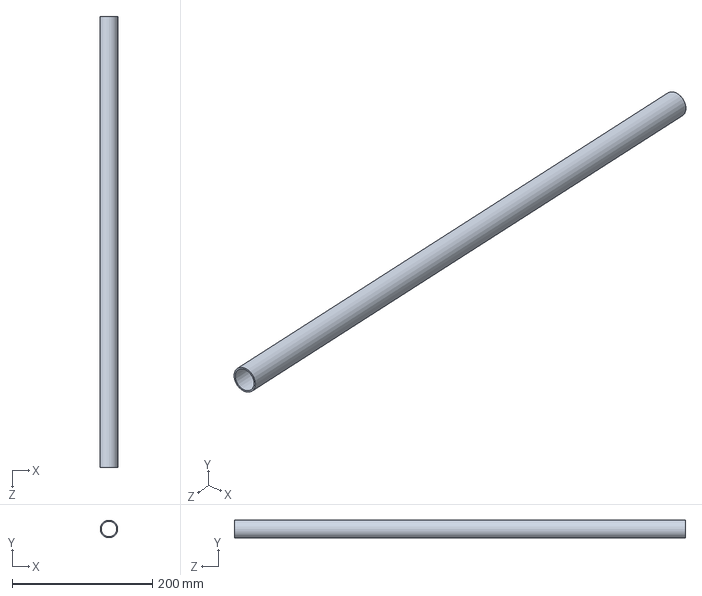
[picture p101: CAD file, 2026-09-23]
cad_3d/3D Modeling/Pièce6_pieds.SLDPRT
25.0 x 25.0 x 644.0 mm
