DjidelAbdelali/pfe/cad_3d/3D Modeling/Pièce0_Bras_Défaut_sldprt.STEP

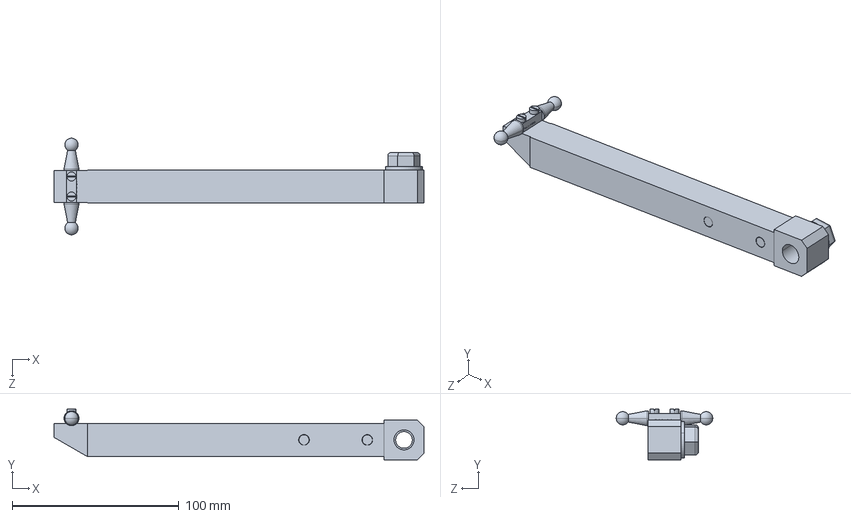
[picture p102: CAD file, 2026-09-23]
cad_3d/3D Modeling/Pièce0_Bras_Défaut_sldprt.STEP
222.0 x 30.5 x 58.0 mm
