DjidelAbdelali/pfe/cad_3d/3D Modeling/Pièce7_Articulation2_4D_Défaut_sldprt.STL

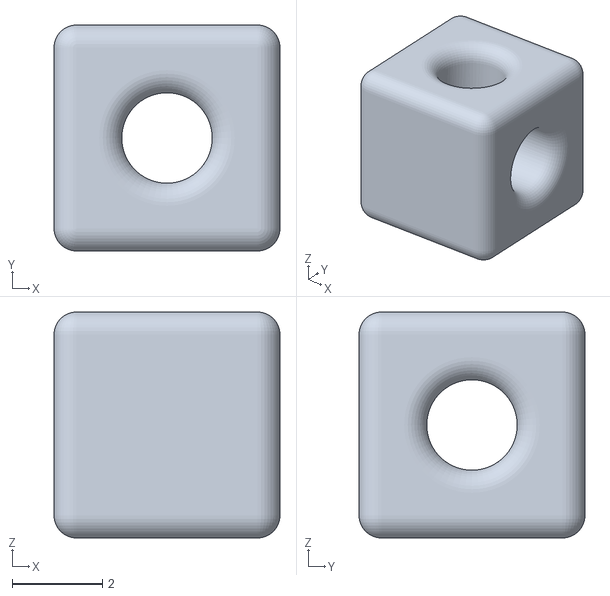
[picture p103: CAD file, 2026-09-23]
cad_3d/3D Modeling/Pièce7_Articulation2_4D_Défaut_sldprt.STL
5.00 x 5.00 x 5.00
