DjidelAbdelali/pfe/cad_3d/3D Modeling/terminal_Défaut_sldprt.STL

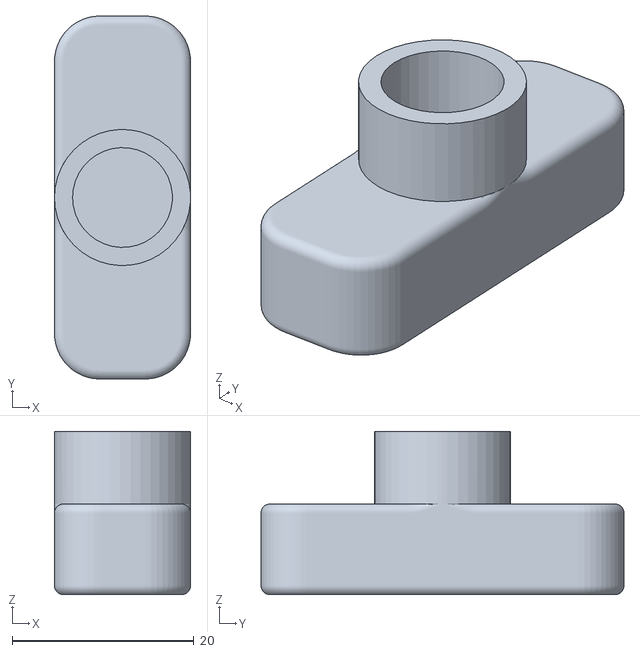
[picture p104: CAD file, 2026-09-23]
cad_3d/3D Modeling/terminal_Défaut_sldprt.STL
15.0 x 40.0 x 18.0
