DjidelAbdelali/pfe/cad_3d/3D Modeling/Pièce1_Rendelle.SLDPRT

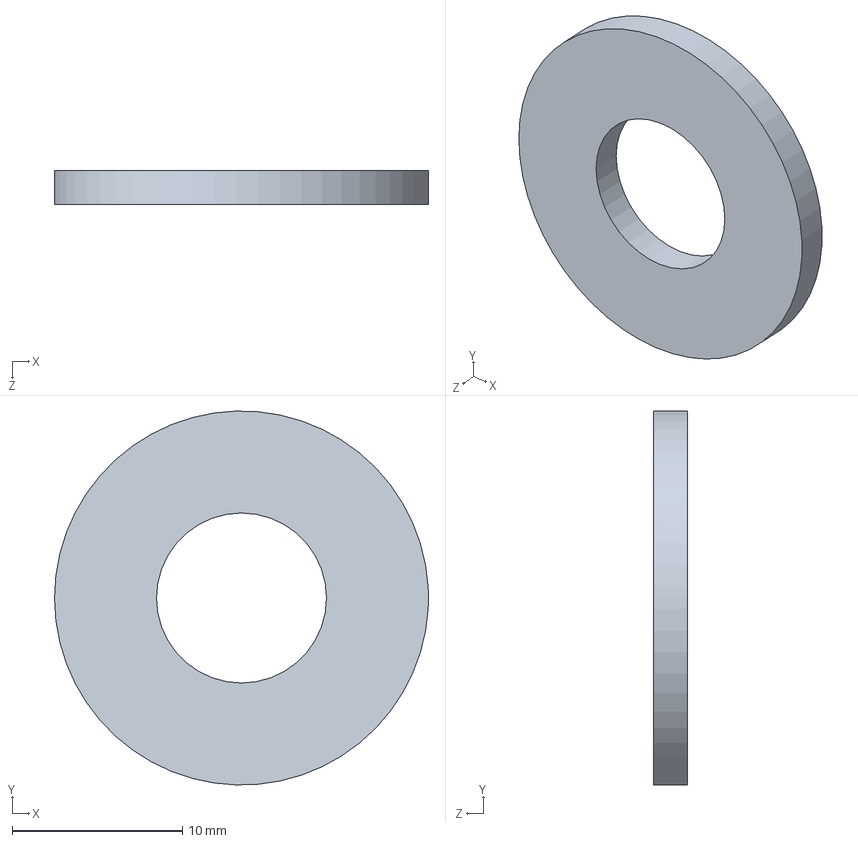
[picture p105: CAD file, 2026-09-23]
cad_3d/3D Modeling/Pièce1_Rendelle.SLDPRT
22.0 x 22.0 x 2.00 mm
