DjidelAbdelali/pfe/cad_3d/3D Modeling/Pièce3_BagueBras.SLDPRT

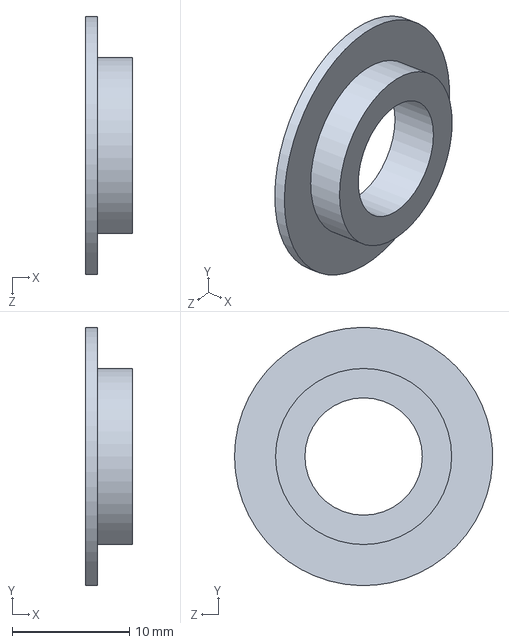
[picture p106: CAD file, 2026-09-23]
cad_3d/3D Modeling/Pièce3_BagueBras.SLDPRT
4.00 x 22.0 x 22.0 mm
