DjidelAbdelali/pfe/cad_3d/3D Modeling/Pièce1_poulie_renvoie.SLDPRT

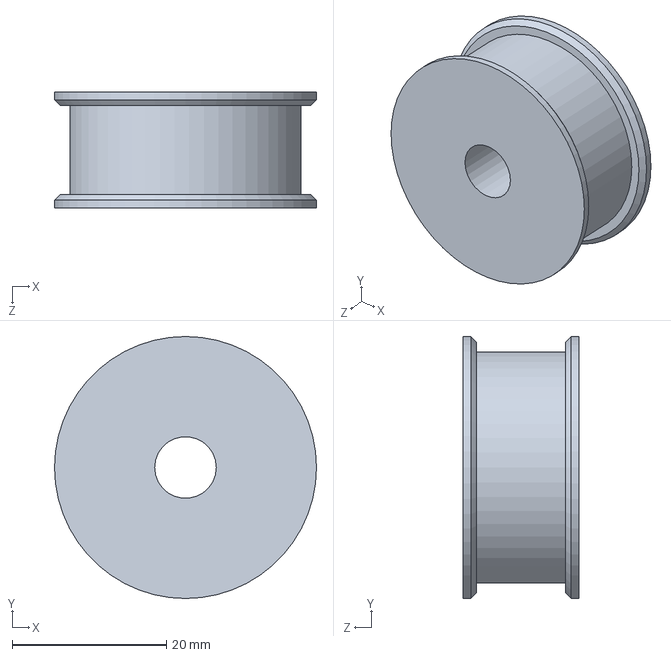
[picture p107: CAD file, 2026-09-23]
cad_3d/3D Modeling/Pièce1_poulie_renvoie.SLDPRT
34.0 x 34.0 x 15.0 mm
