DjidelAbdelali/pfe/cad_3d/3D Modeling/Pièce4_Tube.SLDPRT

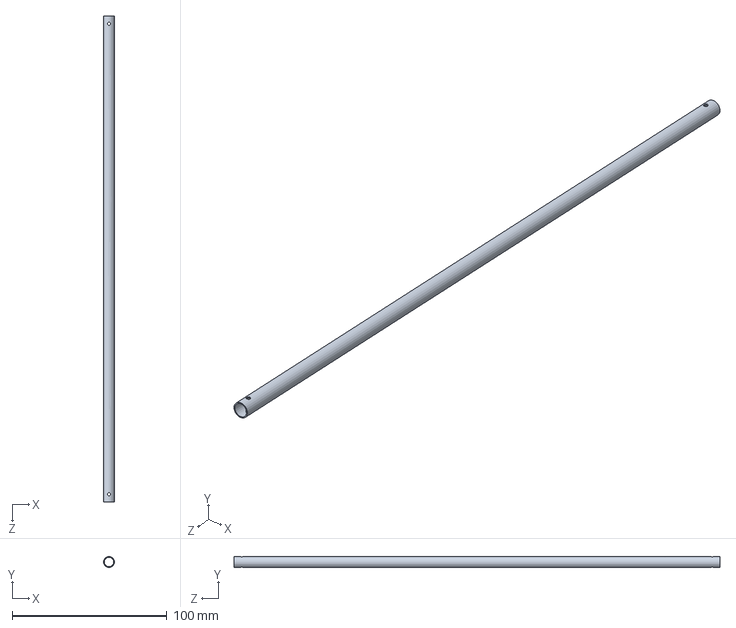
[picture p108: CAD file, 2026-09-23]
cad_3d/3D Modeling/Pièce4_Tube.SLDPRT
7.00 x 7.00 x 314.0 mm
