DjidelAbdelali/pfe/cad_3d/3D Modeling/Pièce6_ComplementBase.SLDPRT

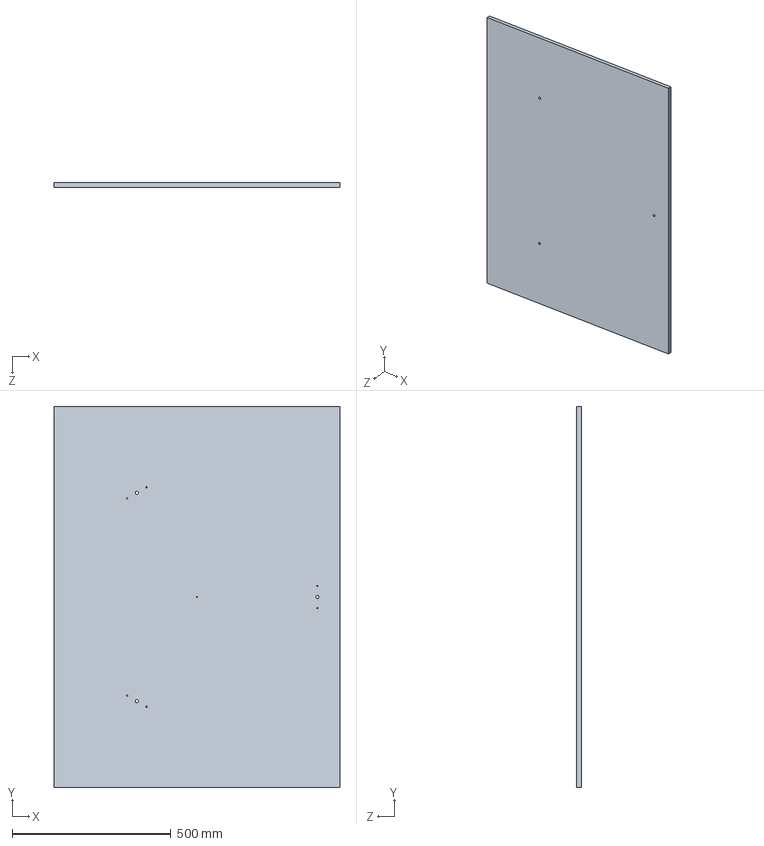
[picture p109: CAD file, 2026-09-23]
cad_3d/3D Modeling/Pièce6_ComplementBase.SLDPRT
900.0 x 1200.0 x 15.0 mm
