DjidelAbdelali/pfe/cad_3d/3D Modeling/Pièce4_Extremetees.SLDPRT

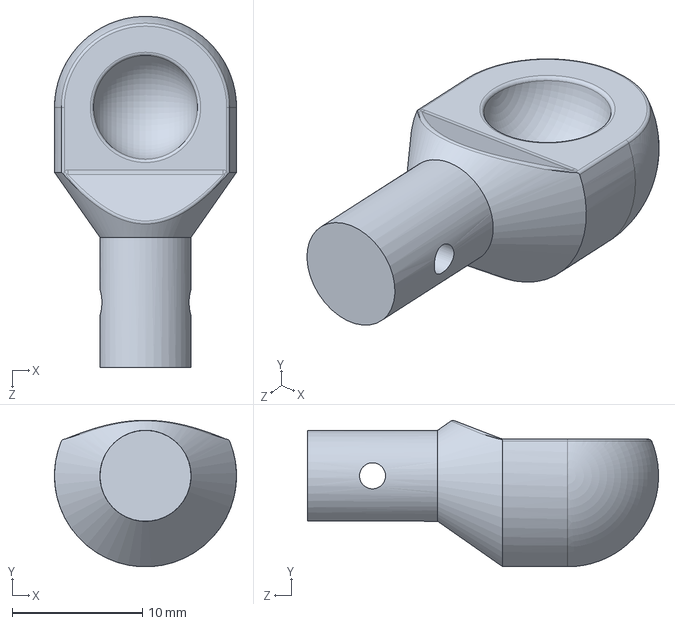
[picture p110: CAD file, 2026-09-23]
cad_3d/3D Modeling/Pièce4_Extremetees.SLDPRT
14.0 x 11.3 x 27.0 mm
