DjidelAbdelali/pfe/cad_3d/3D Modeling/Pièce3_Bras.SLDPRT

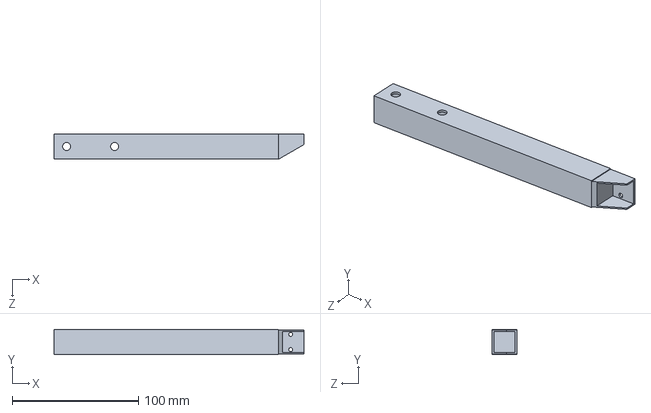
[picture p111: CAD file, 2026-09-23]
cad_3d/3D Modeling/Pièce3_Bras.SLDPRT
198.0 x 20.0 x 20.0 mm
