DjidelAbdelali/pfe/cad_3d/3D Modeling/Pièce1_AxeMoteur.SLDPRT

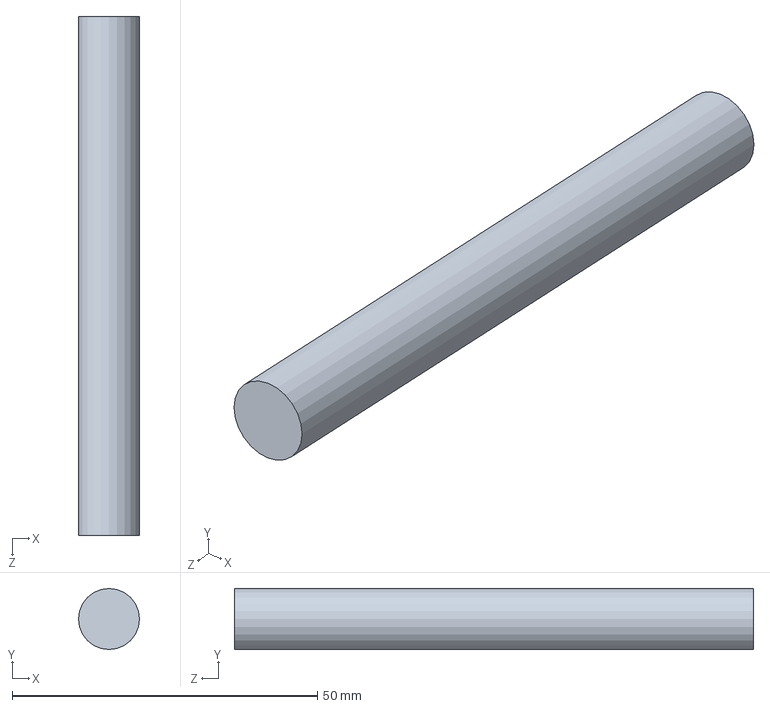
[picture p112: CAD file, 2026-09-23]
cad_3d/3D Modeling/Pièce1_AxeMoteur.SLDPRT
10.0 x 10.0 x 85.0 mm
