DjidelAbdelali/pfe/cad_3d/3D Modeling/Pièce1_arbre_Défaut_sldprt.STEP

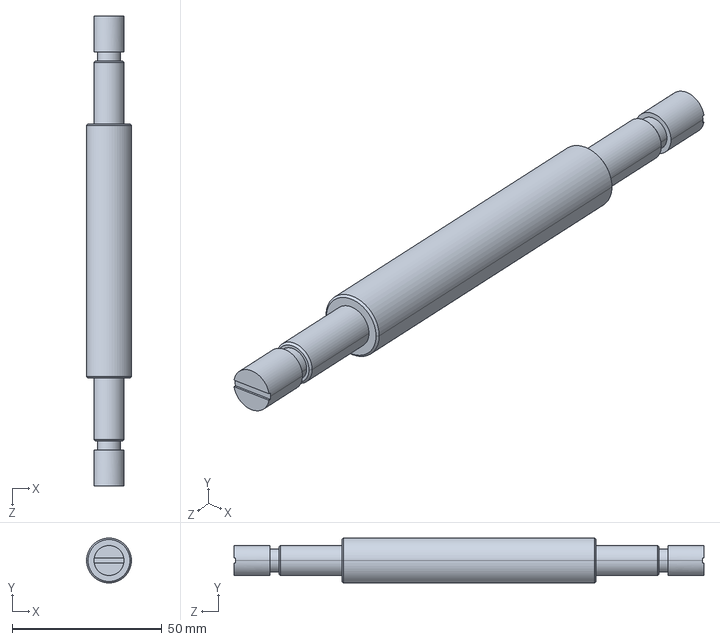
[picture p113: CAD file, 2026-09-23]
cad_3d/3D Modeling/Pièce1_arbre_Défaut_sldprt.STEP
15.0 x 15.0 x 157.0 mm
