DjidelAbdelali/pfe/cad_3d/3D Modeling/Pièce1_Roue.SLDPRT

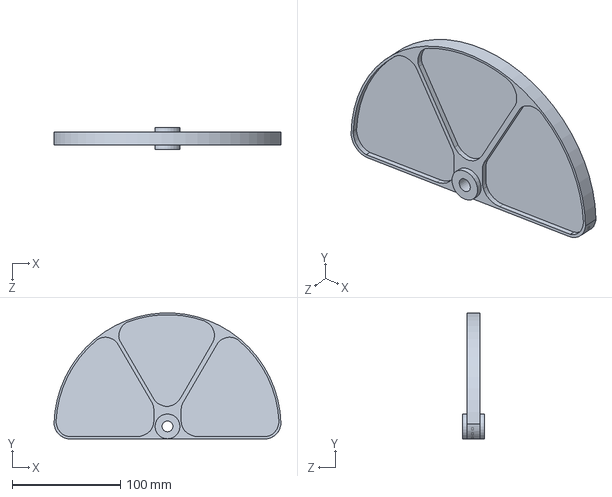
[picture p114: CAD file, 2026-09-23]
cad_3d/3D Modeling/Pièce1_Roue.SLDPRT
210.0 x 116.4 x 20.0 mm
