DjidelAbdelali/pfe/cad_3d/3D Modeling/Pièce5_Tube_Défaut_sldprt.STEP

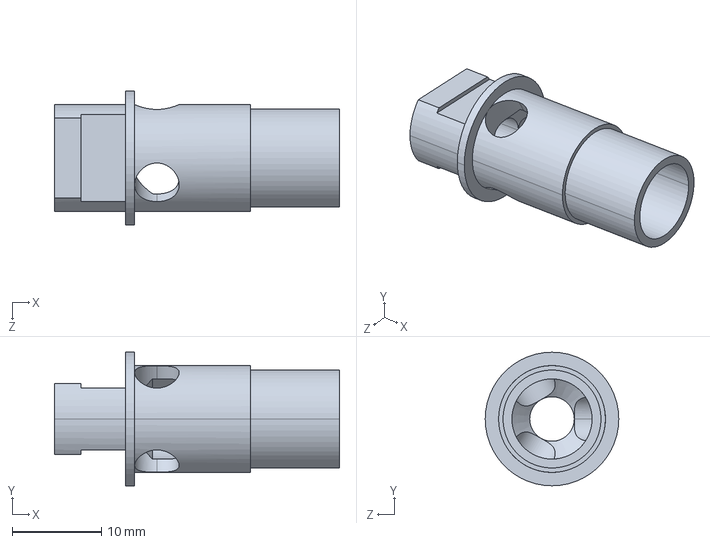
[picture p115: CAD file, 2026-09-23]
cad_3d/3D Modeling/Pièce5_Tube_Défaut_sldprt.STEP
32.0 x 15.0 x 15.0 mm
