DjidelAbdelali/pfe/cad_3d/3D Modeling/Trajectoire1_Défaut_sldprt.STL

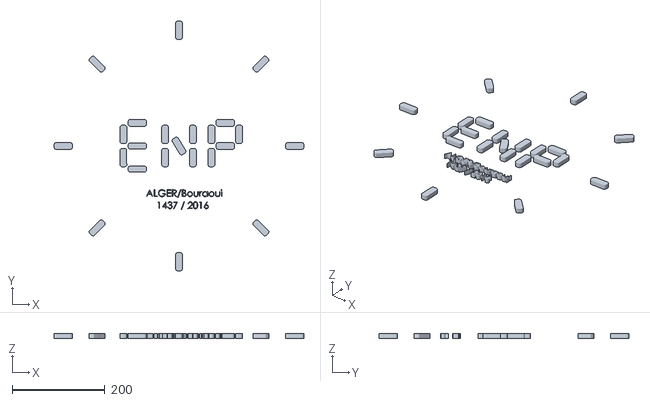
[picture p116: CAD file, 2026-09-23]
cad_3d/3D Modeling/Trajectoire1_Défaut_sldprt.STL
540.0 x 540.0 x 10.0
