DjidelAbdelali/pfe/cad_3d/3D Modeling/Pièce5_BagueArret.SLDPRT

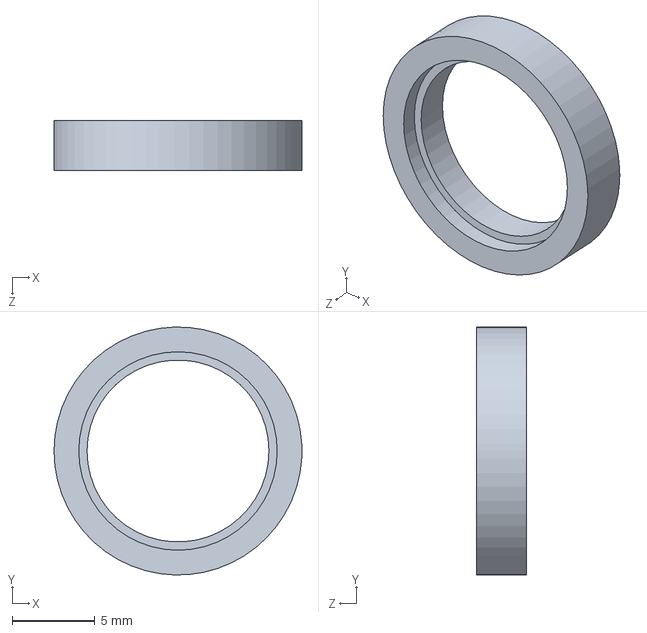
[picture p117: CAD file, 2026-09-23]
cad_3d/3D Modeling/Pièce5_BagueArret.SLDPRT
15.0 x 15.0 x 3.00 mm
