DjidelAbdelali/pfe/cad_3d/3D Modeling/Pièce6_supportPied.SLDPRT

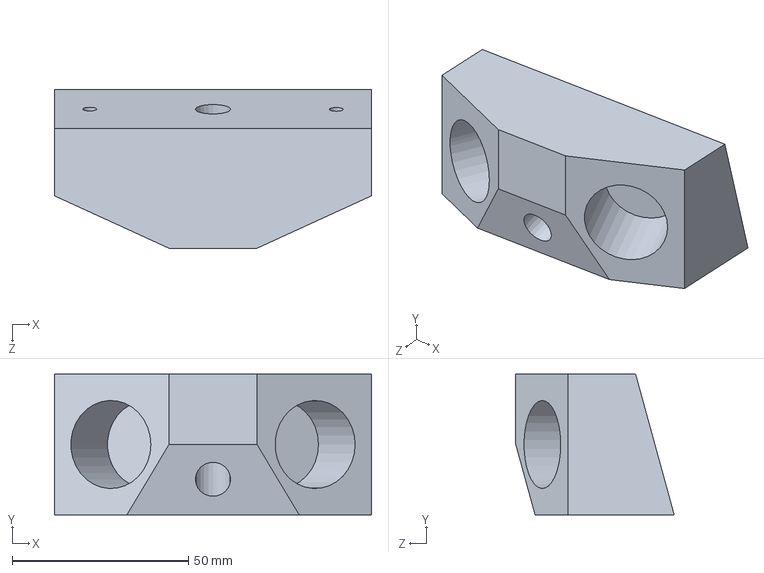
[picture p118: CAD file, 2026-09-23]
cad_3d/3D Modeling/Pièce6_supportPied.SLDPRT
90.0 x 40.0 x 45.0 mm
