DjidelAbdelali/pfe/cad_3d/3D Modeling/Pièce2_EcrouBras.SLDPRT

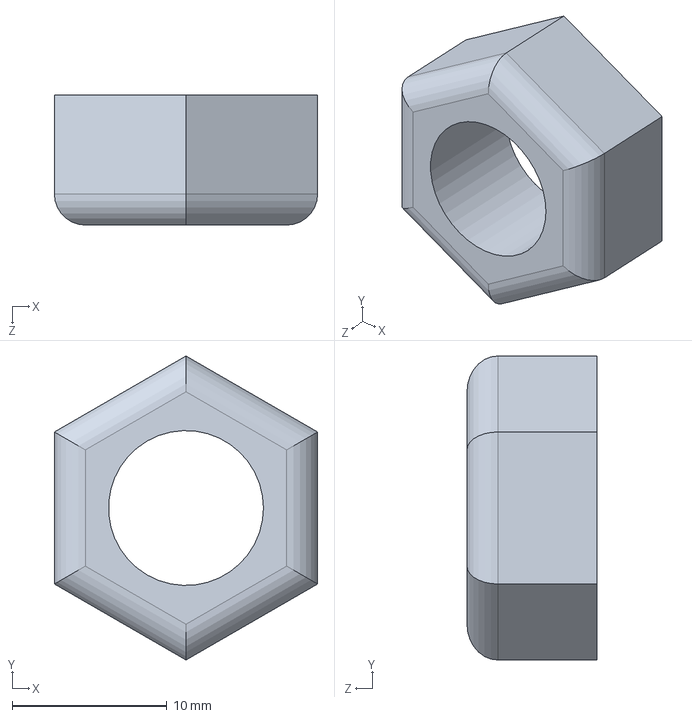
[picture p119: CAD file, 2026-09-23]
cad_3d/3D Modeling/Pièce2_EcrouBras.SLDPRT
17.0 x 19.6 x 8.40 mm
