DjidelAbdelali/pfe/cad_3d/3D Modeling/Pièce3_VisBras.SLDPRT

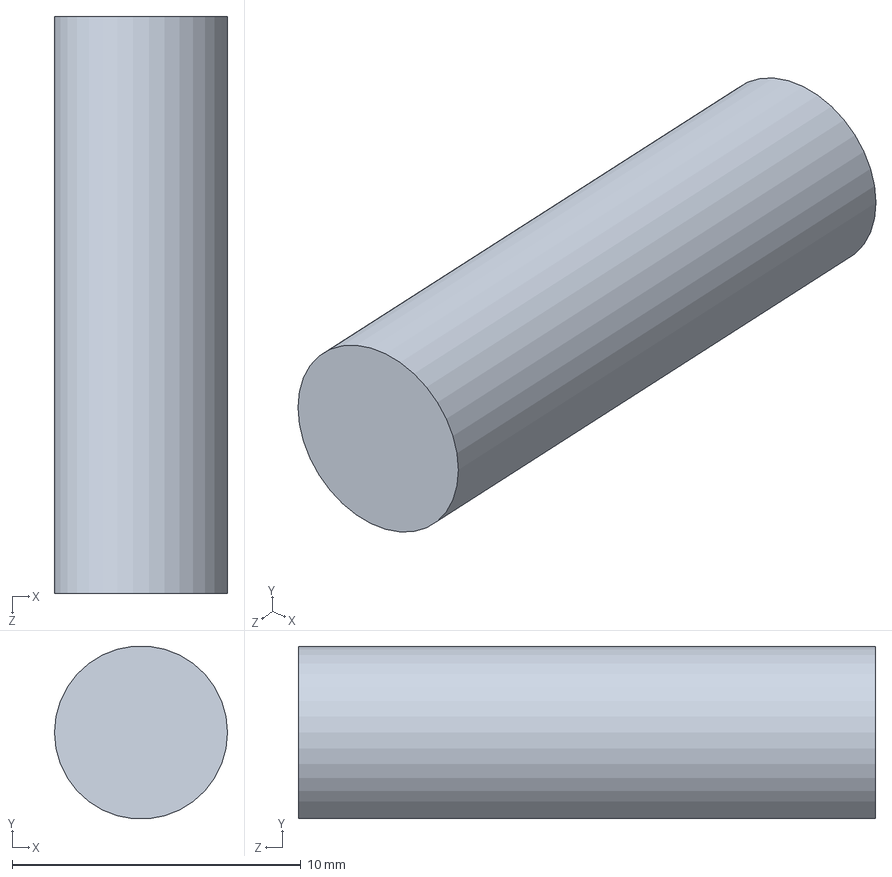
[picture p120: CAD file, 2026-09-23]
cad_3d/3D Modeling/Pièce3_VisBras.SLDPRT
6.00 x 5.97 x 20.0 mm
