DjidelAbdelali/pfe/cad_3d/3D Modeling/Pièce7_Articulation_4D_Défaut_sldprt.STL

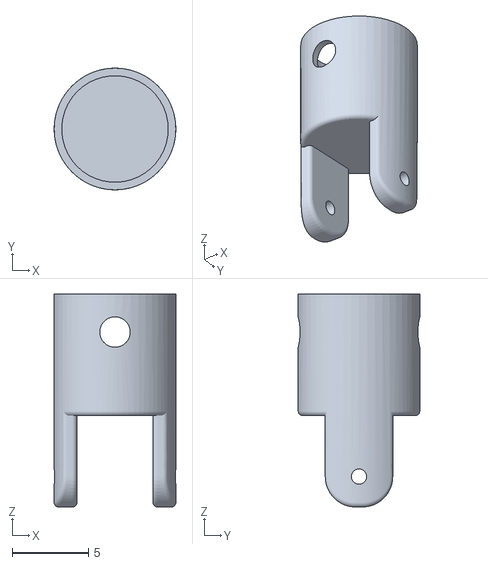
[picture p121: CAD file, 2026-09-23]
cad_3d/3D Modeling/Pièce7_Articulation_4D_Défaut_sldprt.STL
8.00 x 8.00 x 14.0
