DjidelAbdelali/pfe/(list of files, cad)

Other CAD files:
cad_3d/3D Modeling/Roeu.SLDASM
cad_3d/3D Modeling/Pirce0_Roeu2.SLDASM
cad_3d/Pièce0_Plaque.SLDPRT
cad_3d/3D Modeling/Pièce1_Roue_ecrou_Défaut_sldprt.STEP
cad_3d/3D Modeling/Pièce0_Plaque.SLDPRT
cad_3d/Pièce4_Extremetees.SLDPRT
cad_3d/Nacelle1.SLDPRT
cad_3d/3D Modeling/Pièce5_ViceTcyM2.5_10.SLDPRT
cad_3d/3D Modeling/Pièce5_Capot.SLDPRT
cad_3d/3D Modeling/Pièce5_ViceTcyM3_10.SLDPRT
cad_3d/3D Modeling/Pièce5_ViceTcyM2_Défaut_sldprt.STL
cad_3d/3D Modeling/Pièce1_poulieDents.SLDPRT
cad_3d/3D Modeling/Pièce5_Nacelle_Défaut_sldprt.STEP
cad_3d/3D Modeling/Pièce5_RaccordCardon.SLDPRT
cad_3d/3D Modeling/Pièce0_Bras.SLDPRT
cad_3d/3D Modeling/Pièce1_PignonDents.SLDPRT
cad_3d/3D Modeling/Pièce1_Roue_ecrou.SLDPRT
cad_3d/3D Modeling/Piece1_RoeuEcrou.SLDPRT
cad_3d/3D Modeling/Pièce0_Base.SLDPRT
cad_3d/3D Modeling/Pièce5_BagueArret_Défaut_sldprt.STEP
cad_3d/3D Modeling/Pièce4_Tube_Défaut_sldprt.STEP
cad_3d/3D Modeling/Pièce5_Tube.SLDPRT
cad_3d/3D Modeling/Pièce1_PignonDents_Défaut_sldprt.STEP
cad_3d/3D Modeling/Pièce4_Tube2.SLDPRT
cad_3d/3D Modeling/Pièce2_Articulation.SLDPRT
cad_3d/3D Modeling/Pièce5_Guide.SLDPRT
cad_3d/3D Modeling/Pièce5_RaccordTuyau.SLDPRT
cad_3d/3D Modeling/Pièce1_arbre.SLDPRT
cad_3d/3D Modeling/Pièce0_Base_Défaut_sldprt.STL
cad_3d/3D Modeling/Pièce0_Bras_Défaut_sldprt.STL
cad_3d/3D Modeling/Pièce1_PignonDents_Défaut_sldprt.STL
cad_3d/3D Modeling/Pièce1_Roue_ecrou_Défaut_sldprt.STL
cad_3d/3D Modeling/Pièce1_arbre_Défaut_sldprt.STL
cad_3d/3D Modeling/Pièce1_poulieDents_Défaut_sldprt.STL
cad_3d/3D Modeling/Pièce1_poulie_dents.SLDPRT
cad_3d/3D Modeling/Pièce2_Articulation_Défaut_sldprt.STL
cad_3d/3D Modeling/Pièce4_Extremetees_Défaut_sldprt.STL
cad_3d/3D Modeling/Pièce4_Tube_Défaut_sldprt.STL
cad_3d/3D Modeling/Pièce5_BagueArret_Défaut_sldprt.STL
cad_3d/3D Modeling/Pièce5_Capot_Défaut_sldprt.STL
cad_3d/3D Modeling/Pièce5_Guide_Défaut_sldprt.STL
cad_3d/3D Modeling/Pièce5_Nacelle_Défaut_sldprt.STL
cad_3d/3D Modeling/Pièce5_RaccordCardon_Défaut_sldprt.STL
cad_3d/3D Modeling/Pièce5_RaccordTuyau_Défaut_sldprt.STL
cad_3d/3D Modeling/Pièce5_Tube_Défaut_sldprt.STL
cad_3d/3D Modeling/Pièce5_ViceTcyM3_10_Défaut_sldprt.STL
cad_3d/3D Modeling/RobotDelta - Copie.SLDASM
cad_3d/3D Modeling/poulieDents.SLDPRT
