DjidelAbdelali/pfe/cad_3d/3D Modeling/simbody_3d_results.csv

Time | X_actual | Y_actual | Z_actual | X_desired | Y_desired | Z_desired
-588.702182933141 | -0.00480773523942464 | -0.00118298204974983 | -0.148714670645325 | 0.25 | 0 | -0.43
-7835.95657979599 | -0.0048077352394706 | -0.00118298204982 | -0.148714670645215 | 0.25 | 0 | -0.429999999173299
-7835.95658885269 | -0.00480773523951949 | -0.00118298204983192 | -0.148714670645455 | 0.249999999999999 | 0 | -0.429999995039793
-7835.95663410998 | -0.00480773524079828 | -0.00118298205014078 | -0.148714670651799 | 0.249999999999977 | 0 | -0.429999974372265
-7835.95686001859 | -0.00480773527312037 | -0.00118298205795782 | -0.148714670812108 | 0.249999999999422 | 0 | -0.429999871034625
-7835.95795711344 | -0.00480773598695264 | -0.00118298223060381 | -0.148714674352537 | 0.249999999987172 | 0 | -0.42999939217939
-7835.96262715107 | -0.00480774686236677 | -0.00118298486089753 | -0.148714728291762 | 0.249999999800533 | 0 | -0.429997603201926
-7835.97762419982 | -0.00480786215880244 | -0.0011830127461082 | -0.148715300126857 | 0.249999997821898 | 0 | -0.429992079815485
-7836.00785201701 | -0.00480849933991321 | -0.00118316685190987 | -0.148718460176398 | 0.249999986887986 | 0 | -0.429980567398508
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
