DjidelAbdelali/pfe/(commit log)

2026-09-23 Add WebGL 3D simulator and portfolio documentation
    [articulation.stl, base.stl, bras.stl, nacelle.stl, tube.stl]
2026-09-23 Add MATLAB and Simulink controller benchmark models
    [simulation_results.csv]
2026-09-23 Add ROS 2 workspace and URDF packages
    [delta_robot.urdf.xacro]
2026-09-23 Add SolidWorks 3D CAD mechanical assembly and part models
    [608-z.SLDASM, 608-z_01.SLDPRT, 608-z_02.SLDPRT, 608-z_03.SLDPRT, 608-z_04.SLDPRT, Assem12-Copy - Copy.SLDASM, Assemblage3.SLDASM, BarreParalleles.SLDASM]
2026-09-23 Add working document buttons for Thesis PDF, Slides PDF, and Slides PPTX in UI and README
